pingpongshow/MDX-1/docs/img/Main PCB.png

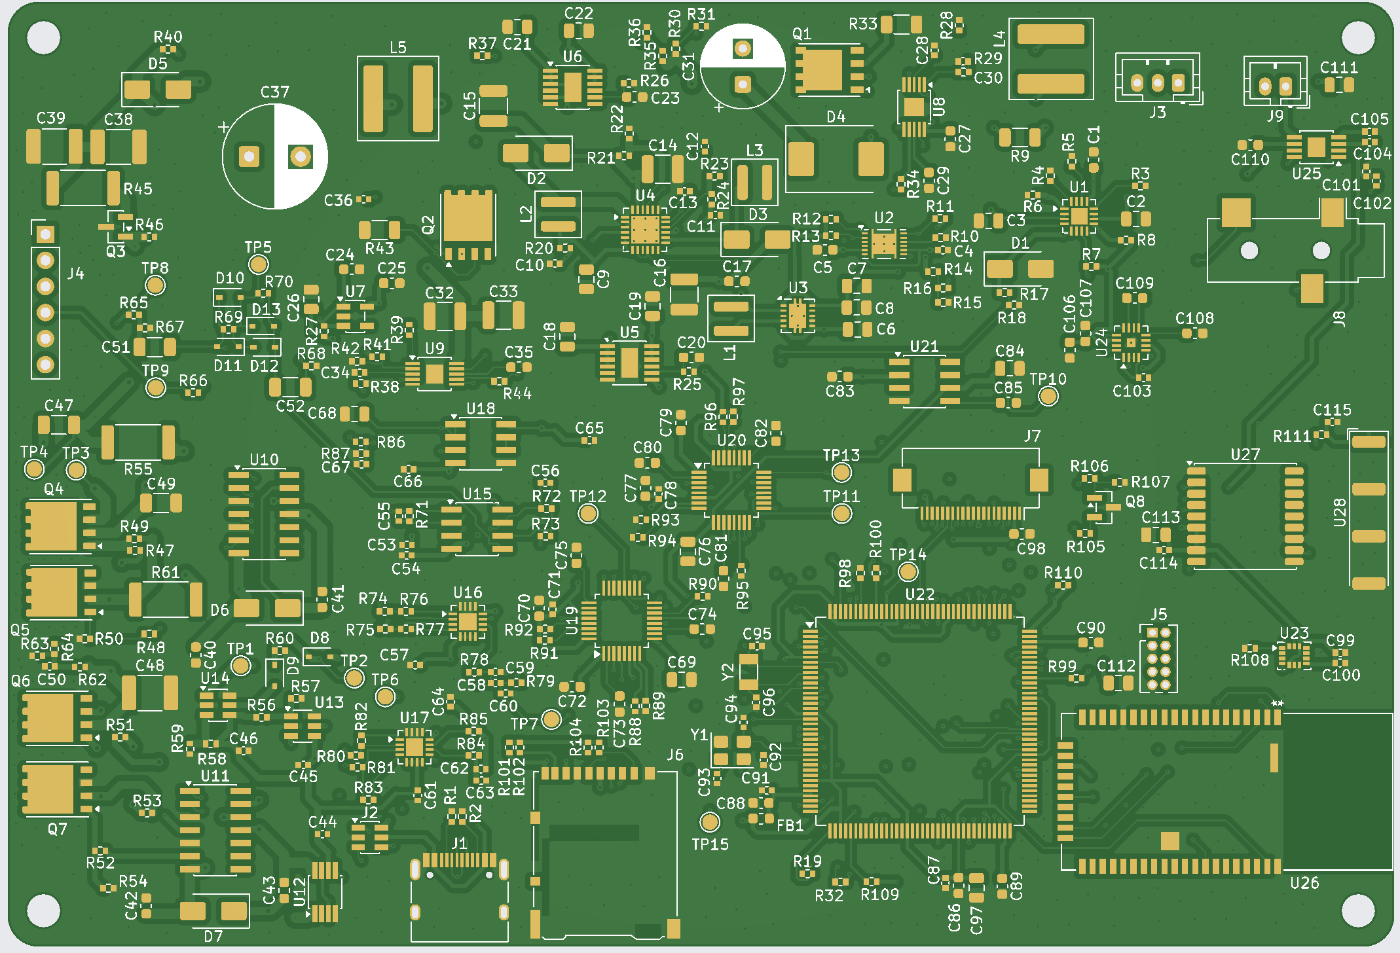
docs/img/Main PCB.png
