pingpongshow/MDX-1/hardware/mdx1/images/mdx1_main_B_Cu.png

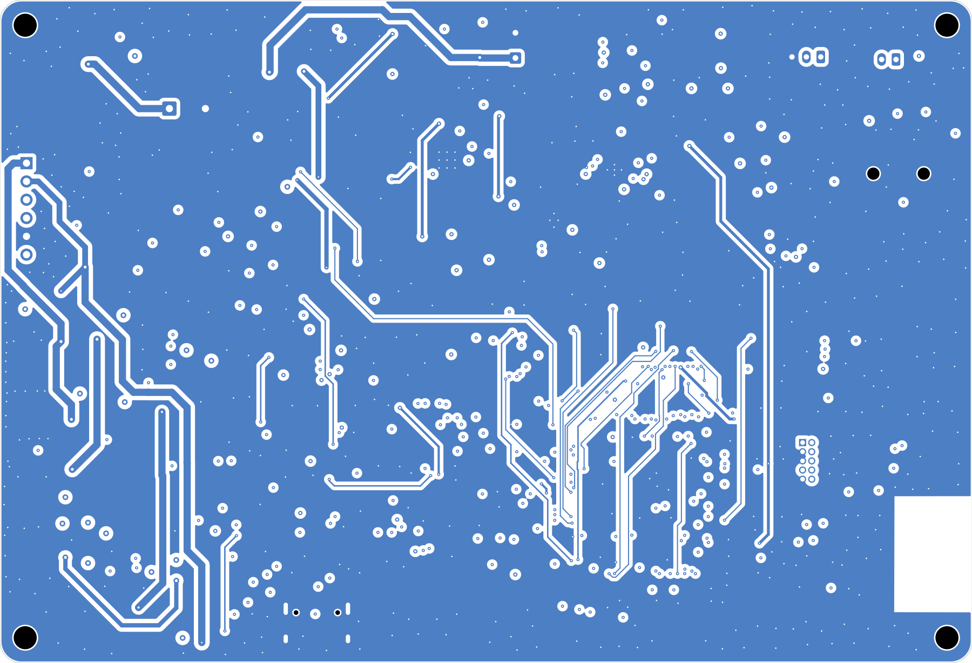
hardware/mdx1/images/mdx1_main_B_Cu.png
