pingpongshow/MDX-1/hardware/mdx1/images/mdx1_main_In2_Cu.png

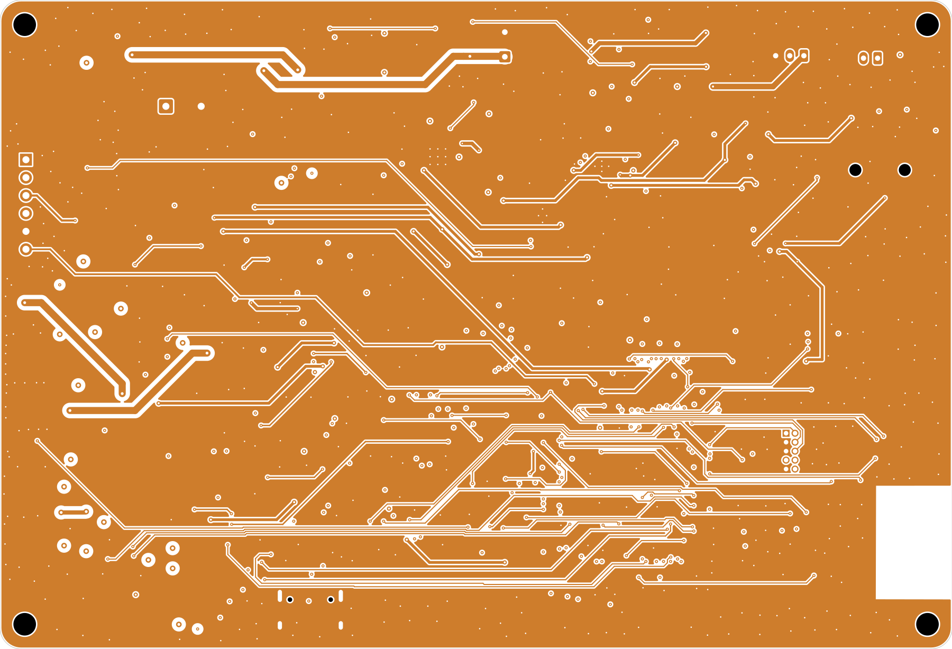
hardware/mdx1/images/mdx1_main_In2_Cu.png
