pingpongshow/MDX-1/hardware/mdx1/images/mdx1_ui_3d_top.png

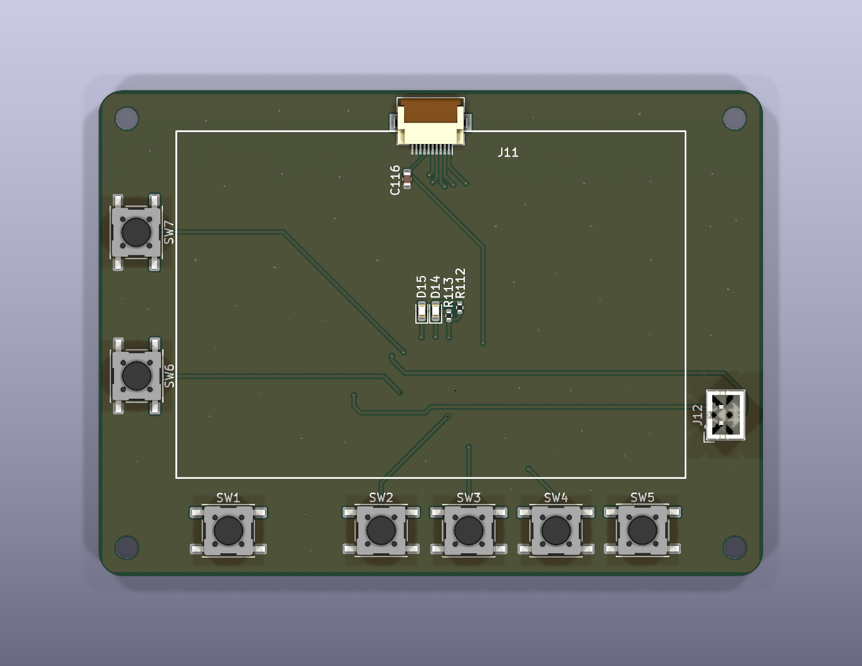
hardware/mdx1/images/mdx1_ui_3d_top.png
