pingpongshow/MDX-1/hardware/mdx1/images/mdx1_ui_B_Cu.png

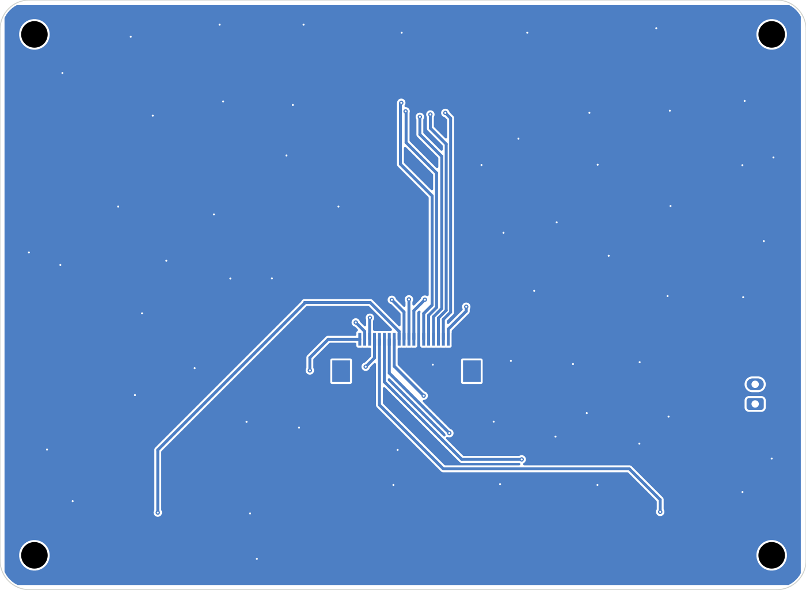
hardware/mdx1/images/mdx1_ui_B_Cu.png
