pingpongshow/MDX-1/hardware/mdx1/fab/BOM/MDX-1_interconnect_BOM.csv

Item | Qty | Description | Mates with | Manufacturer | MPN | Notes
FFC jumper 20-way | 1 | 20 circuits, 0.5 mm pitch, 0.30 mm thick, OPPOSITE-SIDE contacts (Type D), length to suit the enclosure | J7 on the main board to J10 on the UI board | Molex | 15020-02xx (Premo-Flex Type D; e.g. 0150200208 = 51 mm) | Type D is required: FH12 is a bottom-contact ZIF, J7 sits on the main board's TOP layer and J10 on the UI board's BOTTOM layer, so the two ends face opposite ways. Choose the length suffix from the Molex table once the board spacing is fixed. A Type A (same-side) cable only works if the cable is folded 180 degrees in the gap.
JST PH housing 2-pin | 2 | PH series crimp housing, 2 way, 2.0 mm pitch | J9 speaker on the main board; J12 front-light on the UI board | JST | PHR-2 | One per connector
JST PH housing 3-pin | 1 | PH series crimp housing, 3 way, 2.0 mm pitch | J3 battery on the main board | JST | PHR-3
JST PH crimp contact | 8 | SPH-002T-P0.5S crimp terminal, 22-28 AWG | loose contacts for PHR-2 and PHR-3 above | JST | SPH-002T-P0.5S | 2 + 2 + 3 contacts plus one spare; needs the JST WC-240 crimp tool or equivalent
Coil cable connector housing | 1 | 6-way crimp housing, 2.54 mm pitch (mates the J4 pin header) | J4 on the main board | Molex | 22-01-3067 | J4 is a 1x06 2.54 mm vertical pin header (Wurth 61300611121). Mate is a KK-254 6-circuit housing (Molex 22-01-3067) with 08-50-0114 crimp terminals, or any 2.54 mm 6-pos socket. Pin 6 (COIL_ID) may be left unwired for coils with no ID chip.
Coil cable crimp contact | 7 | KK-254 crimp terminal, 22-30 AWG | loose contacts for the coil housing above | Molex | 08-50-0114 | 6 contacts plus one spare
LCD flex | 0 | No separate part: the Sharp LS027B7DH01 has an integrated 10-way FPC tail that inserts directly into J11 | J11 on the UI board | Sharp | LS027B7DH01 | Panel is ordered as the display assembly
SWD programming cable | 1 | 2x5 1.27 mm ribbon, keyed | J5 on the main board |  |  | Standard Cortex-M 10-pin debug cable supplied with most SWD probes
