pingpongshow/MDX-1/hardware/mdx1/fab/Case/MDX-1_main_outline.dxf

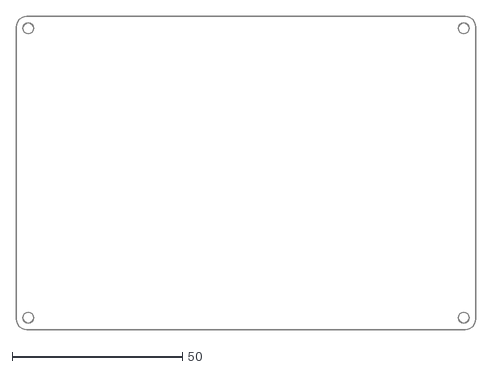
[picture p14: CAD file, 2026-09-09]
hardware/mdx1/fab/Case/MDX-1_main_outline.dxf
135.0 x 92.0
