pingpongshow/MDX-1/hardware/mdx1/fab/Case/LS027B7DH01_LCD_outline.dxf

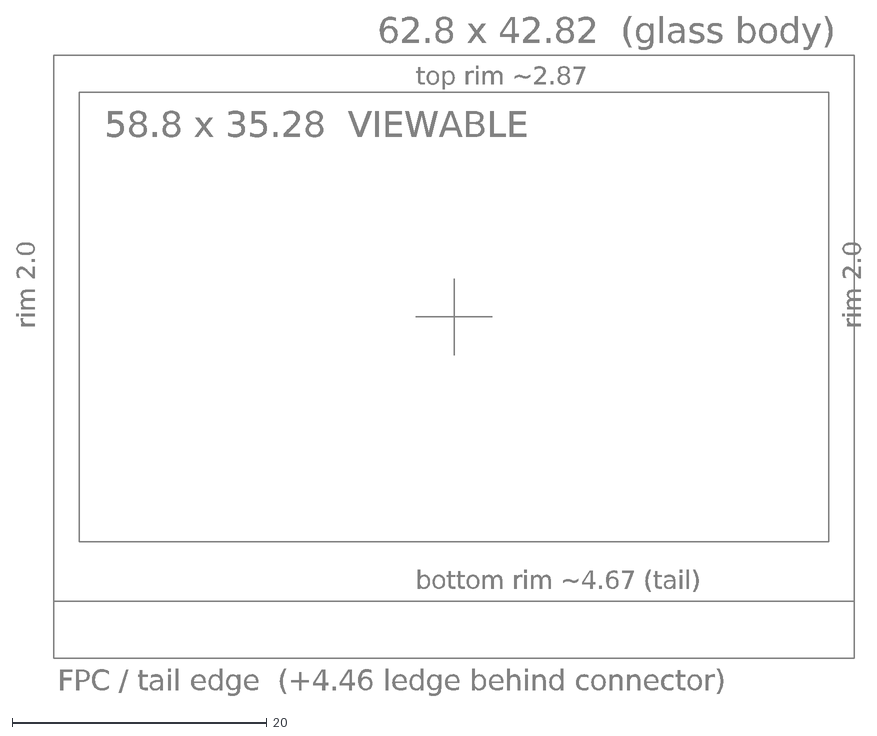
[picture p15: CAD file, 2026-09-09]
hardware/mdx1/fab/Case/LS027B7DH01_LCD_outline.dxf
62.8 x 42.82 (glass body)
58.8 x 35.28 VIEWABLE
FPC / tail edge (+4.46 ledge behind connector)
rim 2.0
top rim ~2.87
bottom rim ~4.67 (tail)
