pingpongshow/MDX-1/hardware/mdx1/fab/Case/MDX-1_ui_layout.dxf

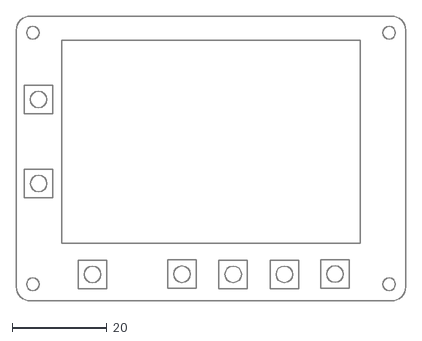
[picture p16: CAD file, 2026-09-09]
hardware/mdx1/fab/Case/MDX-1_ui_layout.dxf
82.0 x 60.0
