pingpongshow/MDX-1/docs/MDX-1_firmware_guide.html

Firmware 0.5.0 · 2026-09-06

# MDX-1 firmware

The detector engine, screen interface and hardware layer for the MDX-1. The engine is portable C compiled and exercised on this machine against a physics simulator of the coil, ground and targets; the STM32H743 layer is written but awaits a bench. This guide covers what the firmware does beyond the commercial units, how the signal path works, the test evidence, the screens, and the bring-up plan.

Host test bench: 93 checks, 0 failedcore 2750 lines · simulator 662 · STM32 layer 611STM32 layer not yet compiled on target

1

## What was added beyond the commercial feature set, and why

Before writing code I listed the capabilities a high-end detector needs, what users complain about, and what the MDX-1 hardware makes possible that commercial units cannot do. Each item below is implemented and exercised by the test bench unless marked otherwise.

Feature | Commercial state of the art | MDX-1 implementation | Module
Coil wizard for any wired coil | Coils are model-specific; third-party coils need factory-matched inductance | Measures TX inductance and resistance from the transmit current (regression on di/dt), records the residual null, learns the magnetic axis from a ferrite rod, and the depth scale from a coin. Works on coils with or without an ID chip. Off-the-shelf coils verified in simulation (5.6 mH coil measured to 0.1 %). | coil/coil.c, ui wizard
Five-line target model with physics-based ID | Two-axis ID map from proprietary weighting (high-end units) | Fits a magnetic amplitude, an eddy amplitude and the relaxation frequency ζ to the five demodulated lines. Conductivity ID is log ζ; ferrous index is the magnetic share; confidence is the model fit residual. Silver, copper, nickel, foil, nail, bottle cap and ferrite all resolve in the estimator probe. | dsp/target.c
Two-component ground model | Single ground-balance point, sometimes a salt setting | Least-squares fit of a magnetic (viscous) and a salt (conductive) component across the five lines every period; the hot-rock channel is the residual of that fit. Tracking speed follows swing velocity from the IMU (a position-aware ground-balance approach), freezes for 0.6 s whenever metal is in the field, and is seeded directly at start-up so there is no settling wait. | dsp/ground.c, det/detector.c
Physics-sign validity test | - | Eddy currents always give a negative imaginary response; the motion filter's undershoot after a strong target flips the vector. A one-line test rejects those tails, which removed both wrong-ID reports and audio "double beeps" in the test bench. | det/detector.c
Noise cancel that sees inside the lines | Channel scan on inter-line noise | Nine period lengths (96 to 104 samples) move every line by up to 4 %. The metric is the variance of the low-passed line ratios over a 50 ms dwell, which catches an interferer sitting 30 Hz from a line, plus inter-line broadband power. Coherence is preserved because the DFT length follows the period. Test: a 300 µV interferer 30 Hz above the 41 kHz line, jitter reduced 28×. | dsp/noisecancel.c
Hybrid VLF + PI | Separate machines | In Hybrid mode every N-th block of periods runs a bipolar PI burst on the same bridge at 100 V; PI records are ground-balanced by early/late window ratios (learned at ground grab), with a time-constant estimate from two equal early windows. VLF gives the ID, PI adds a deep-target channel. Gold and Relic programs enable it. | dsp/pi.c, tx/waveform.c
Learn-a-target | Notch by ID number only | Stores the normalised five-line signature (10 numbers) of any target under a name; matches by cosine distance so the match is depth-independent. Sixteen slots. Test: a ring re-identified 4 of 6 passes, a different target never confused. | dsp/classify.c
Recovery speed with a real motion filter | Recovery 1..8 | Recovery 1..8 sets the fast-channel average from 256 to 2 periods (50 ms to 0.4 ms); the motion reference is 24× slower. Same filter on every line, so the ID vector is not distorted by the filtering. | det/detector.c
Depth from physics | Depth bars calibrated per model | Dipole coupling falls as 1/d⁶, so depth = 10 cm × (reference/strength)^(1/6), with the reference taken by the wizard. Test: coin at 15 cm reported at 14 cm. | dsp/target.c
Find logging with GNSS | rare in commercial units | Trail point every 2 s and a find line for each accepted target held over 1.5 s: time, position, ID, ferrous index, depth, confidence, mode, ground phase, learned name. CSV on the SD card. | log/log.c
Sunlight-readable screen with a 2-D map | high-end units only | 400×240 memory LCD: large ID, 2-D conductivity/ferrous map with a fading trace of the last 24 estimates, signal bar, depth gauge, ground phase, mineralisation/salt/hot-rock/noise bars, PI status, coil name, transmit current, battery, GPS. | ui/screens.c
Self-diagnostics | Hidden service menus | Rails, transmit current versus expected for the measured coil, noise floor and threshold in µΩ, ground coefficients, per-line residual null, IMU, GNSS, SD, headphones, on one screen. | ui/screens.c
Auto noise cancel at start, auto sensitivity | Manual noise cancel; sensitivity number | The channel scan runs by itself 1.2 s after power-up once the ground model has seeded; "Auto sensitivity" holds the threshold at 5× the tracked noise floor so the detector rides just above the noise wherever it is. | det/detector.c
Iron falsing rejection | Iron bias settings | Two physics rules on the demodulated vector: eddy currents always give a negative imaginary part, and a negative real part never comes with a positive imaginary one. Together they discard the motion filter's sign-flipped tails, which otherwise read as "silver" after every nail (0 false triggers over 4000 periods of mineralised ground; nail tails rejected in the bench). | det/detector.c
Five-line signature bars | - | The home screen shows |T| at 5/10/15/20/41 kHz as five bars: the target's frequency signature, which distinguishes a thin foil from a coin at a glance and shows why the ID is what it is. | ui/screens.c
Iron "grunt", crisp audio envelope | Iron tone | Ferrous targets get a low tone amplitude-modulated at 25 Hz; the audio envelope has a 2 ms attack and 20 ms release so target loss never clicks. | audio/audio.c
Battery run-time, low-battery banner, auto-save, key repeat, find log screen | Battery bars | Hours left from the gauge percentage and the mode's current draw; a banner below 3.45 V and shutdown at 3.30 V; settings save themselves on leaving the menu; navigation keys auto-repeat after 0.5 s; a find-log screen shows finds, fix, position and card status and marks a find by hand. | ui/screens.c, det/detector.c
Runs with or without the UI board | Screen is mandatory | MDX_UI_BOARD selects a headless build, a fitted UI board, or auto-detection from the UI_DET pin at boot. Headless, the detector is the phone app plus headphones or Bluetooth headphones: the main-board POWER button (hold 1.5 s) switches it off, a status LED blinks while searching and goes solid when a phone is linked, and short audio cues mark boot, phone link up/down, low battery and power-off. Automatic noise cancel and ground tracking need no user action. | sys/sys.c, audio/audio.c
Six-key pad with long presses | 8 to 10 buttons | MENU, UP, DOWN, LEFT, RIGHT, POWER plus a PINPOINT trigger. Back is MENU held 0.8 s, ground grab is PINPOINT held 1.5 s while pumping; both are virtual keys synthesised in the UI layer. | ui/screens.c, hal/hal.h
Programs | Park / Field / Beach / Gold | Park, Field, Beach (salt model weighting), Gold (hybrid PI every 8 blocks, VCO audio), Relic (hybrid, high ferrous limit). Settings saved to flash with a CRC. | det/detector.c

Review findings fixed in 0.2.0: the settings CRC was computed over the struct's trailing padding (random on every save), the ground tracker resumed 0.6 s after a target while its 0.5 s averager still held the target (hold-off is now 1.5 s), a period change for noise cancel reset the ground model (it now keeps its coefficients), and the PI depth used a placeholder formula. Not implemented in 0.5.0 and left as marked work: constant-current top-up during the PI hold (the hold current decays with L/R = 0.57 ms, acceptable for 300 µs holds); the Bluetooth module's audio pairing flow (the data channel is done, audio routing is, pairing UI is not); FatFs integration on the target (the logging code is complete, the SD driver hook is a stub until the middleware is added); USB DFU update is provided by the STM32 ROM bootloader rather than by this firmware.

2

## Signal path, one transmit period at a time

### Numbers that define the behaviour

- Detection threshold = noise floor × 3 × 20^((30 − sensitivity)/29): sensitivity 30 sits at 3× the tracked floor, sensitivity 1 at 60×.
- Noise floor: tracked from |T| when no target is present (2 % per period at start-up, 0.2 % after), only from samples under 3× the floor.
- Ground tracker time constant: 8 s stationary, 1 s at 1.5 m/s swing; frozen for 0.6 s after any signal over twice the threshold.
- Recovery 5 (default): 16-period fast average (3 ms), reference 384 periods (75 ms).
- Target estimate is updated only while the signal is 3 dB above threshold; the last good estimate is held on the weak edges so the displayed ID does not flicker.

### Coherence and the period length

One period is M ADC samples and M × 448 timer ticks; the transmit table is rebuilt for each M so its 80 slots sum exactly to that. The DFT of one period at bins 1, 2, 3, 4 and 8 is therefore leak-free at any M, and the ratio to the transmit-current channel removes the coil's inductance change with soil, rail sag and filter delay. The simulator confirms the demodulated transfer impedance to 4 parts in 10⁵.

3

## Test evidence

The simulator generates the two 24-bit ADC streams the hardware would produce: the exact RL response of the transmit winding to the slot table (edges at timer-tick resolution), the coil's own per-line phase and residual null, viscous and salt ground, dipole-coupled targets with a relaxation-frequency model, white noise at 20 µV rms (the electronics alone give about 1.2 µV; the extra stands in for environmental noise), a CW interferer, and a sinusoidal 0.4 m sweep with the IMU reading the swing rate. PI records are synthesised the same way with 1/t viscous ground.

4 × 10⁻⁵

worst relative error of the demodulated transfer impedance over the five lines

0.1 %

coil inductance measurement error from the transmit current (0.36 mH and 5.6 mH coils)

0.01°

worst per-line error of the magnetic-axis rotation learned from a ferrite rod

0 / 4000

false triggers over 4000 periods sweeping over 30 mΩ mineralised ground at 1.5 m/s

78

ferrous index of a nail (limit 55), rejected on every pass; its flipped tail no longer reads as a coin

67 vs 67

ID of a ζ = 2.5 kHz coin at 15 cm; depth 14 cm; ferrous index 6

28×

reduction of 41 kHz channel jitter after noise cancel with an interferer 30 Hz off the line

[1] transmit waveform table
  ok:   zero DC (sum=0)
  ok:   line 1 rel amplitude 0.2241 (expected 0.2241)
  ok:   line 2 rel amplitude 0.2241 (expected 0.2241)
  ok:   line 3 rel amplitude 0.2253 (expected 0.2253)
  ok:   line 4 rel amplitude 0.2259 (expected 0.2259)
  ok:   line 8 rel amplitude 0.2257 (expected 0.2257)
  ok:   slot tables for M=96..104 sum to M*448 ticks
[2] coherent demodulation recovers the physical transfer impedance
  ok:   worst relative error over 5 lines 4.08e-05
  ok:   TX current 0.396 A rms at 12 V (design 0.42)
  ok:   5 kHz line current 0.464 A vs expected 0.464 A
[3] coil wizard: TX inductance and resistance from the current waveform
  ok:   regression succeeded
  ok:   L = 0.3600 mH (true 0.3600)
  ok:   R = 0.631 ohm (true 0.630)
  ok:   OTS coil: L = 5.596 mH (true 5.600)
[4] coil wizard: null and magnetic-axis rotation
  ok:   rotation recovered on all lines, worst error 0.01 deg
  ok:   calibration flags set (null + rotation)
  ok:   record survives a round trip through the coil EEPROM (crc 919e)
[5] coin at 15 cm in mineralised ground, sweeping at 1.5 m/s
  ok:   no target: 0 false triggers in 4000 periods (0.0 %), ground phase 5.6 deg, |G| 30.2 mohm
  ok:   target detected (892 periods above threshold)
  ok:   ID 72 (expected 67 for zeta 2.5 kHz)
  ok:   ferrous index 21 (conductive target)
  ok:   accepted by discrimination
  ok:   depth estimate 15 cm (true 15 cm)
        threshold 64.0 uohm, noise floor 11.5 uohm, last confidence 0.97
[6] iron nail: magnetic + high-zeta eddy, must be flagged ferrous
  ok:   detected (4 samples)
  ok:   ferrous index 78 > 55
  ok:   rejected by ferrous limit in 4 of 4
  ok:   silver ID 91 (expected 81; +-12 at the saturated high-conductivity end)
[7] noise cancel: CW interferer 30 Hz from the 41 kHz line
  ok:   scan completed in 4449 periods (868 ms)
  ok:   chose M=104 (41 kHz line moved to 39.38 kHz)
  ok:   41 kHz fast-channel jitter 3562.5 uohm -> 125.7 uohm
[8] pulse induction: deep target in viscous ground
  ok:   ground-balanced residual 1.33e-04 V vs raw ground 1.11e-02 V
  ok:   PI target detected in 128 of 128 bursts
  ok:   time constant 34 us (true 53 us)
[9] learn-a-target, find logging, audio path
  ok:   signature stored
  ok:   re-detected as 'ring' 5 of 5 times
  ok:   different target not confused with 'ring' (0 of 22)
  ok:   find log line: 1789000003,1,51.507400,-0.127800,1.1,32,98,15,94,0,2.9,-22,

  ok:   audio callback produces samples (320 non-zero of 320)
[10] UI screens
  ok:   menu navigation: editing item 2
  ok:   sensitivity edited to 21
  ok:   back to home
  ok:   pinpoint screen active
  ok:   screens rendered to build/*.pbm
[11] enhancements: auto noise cancel, auto-save, spectrum, iron grunt, battery hours, log screen
  ok:   noise cancel started automatically 1.2 s after power-up
  ok:   and completed
  ok:   settings auto-saved on leaving the menu (sensitivity 21, crc ok)
  ok:   auto-repeat: sensitivity 21 -> 26 after holding UP for 1.0 s
  ok:   iron grunt engaged on a nail (5 of 5)
  ok:   five-line signature populated (sum 4.73, max bar = 1)
  ok:   battery estimate 9.0 h at 66 %
  ok:   low-battery flag at 3.40 V
  ok:   log screen: RIGHT marks a find
  ok:   MENU short press opens the menu
  ok:   MENU held 1 s acts as BACK (menu closed, no re-open on release)
  ok:   PINPOINT held 0.5 s: pinpoint mode, no ground grab yet
  ok:   PINPOINT held 1.7 s: ground grab active (a_grab 0.0000 -> 0.0103)
  ok:   release returns home
[12] phone link: framing, auth, item table, set, actions, status, finds, diag
  ok:   request before HELLO is refused (not authenticated)
  ok:   HELLO with the wrong PIN answers auth=0 plus an error
  ok:   HELLO with PIN 1234: authenticated, 26 items, fw 0.5.0
  ok:   corrupted frame answered with BAD_CRC and dropped
  ok:   item table: 26 of 26 items decode with matching names (6 actions, 31 labelled values)
  ok:   VALUES: 26 values, sensitivity slot reads 20
  ok:   SET sensitivity=27 applied (dirty flag set)
  ok:   SET out of range refused
  ok:   SET mode=PI via the item table
  ok:   ACTION ground grab (a_grab 0.0100)
  ok:   ACTION pinpoint on (device screen follows)
  ok:   ACTION pinpoint off
  ok:   ACTION noise cancel started
  ok:   EVENT noise cancel done, M=104
  ok:   STATUS one-shot: 55 bytes, present, ID 61.1, lat 515074000
  ok:   STATUS stream at 100 ms: 10 frames in 1 s
  ok:   ACTION learn 'Coin' then LEARNED lists it (1 entries)
  ok:   ACTION forget removes it
  ok:   EVENT find after MARK_FIND
  ok:   FIND 0: lon -1278000, ID 61, depth 14 cm
  ok:   DIAG: 109 bytes, line 0 = 5020 Hz, coil 'MDX DD11'
  ok:   ACTION save wrote sensitivity 27 and PIN to NVM
  ok:   after a BLE drop the phone must HELLO again
[13] headless: UI board absent -> no LCD, main-board power key, cues, phone link still full
  ok:   auto-detect: UI_DET open -> headless
  ok:   auto-detect: UI_DET grounded -> UI on
  ok:   MDX_UI_BOARD=0 forces headless even with a board
  ok:   no LCD writes, keypad ignored (sensitivity stays 20)
  ok:   boot cue playing on headphones
  ok:   status LED blinks while searching
  ok:   HELLO authenticates headless
  ok:   LED solid + link-up cue once the phone is on
  ok:   SET from the phone applies without a UI
  ok:   pinpoint from the phone
  ok:   low-battery cue
  ok:   POWER held 1.0 s: still on
  ok:   POWER held 1.8 s: power-off requested

93 checks, 0 failed

4

## Screens

Rendered by the same code that will drive the panel, dumped by the simulator. The panel is a 2.7-inch 400×240 reflective memory LCD; the renders are shown at 3× with the panel's grey-white ground.

Home screen with a target: large conductivity ID (inverted when rejected), ferrous index and fit confidence, learned name or IRON, signal bar, 2-D map with trace, depth gauge, ground panel.

Home screen with a target: large conductivity ID (inverted when rejected), ferrous index and fit confidence, learned name or IRON, signal bar, 2-D map with trace, depth gauge, ground panel.

Home screen idle, Field program. Top bar: program, mode, sensitivity, noise channel, SD, GPS, battery.

Home screen idle, Field program. Top bar: program, mode, sensitivity, noise channel, SD, GPS, battery.

Menu with a value being edited: LEFT/RIGHT change, MENU finishes (held 0.8 s = back). Actions (wizard, noise cancel, learn, diagnostics) open their own screens.

Menu with a value being edited: LEFT/RIGHT change, MENU finishes (held 0.8 s = back). Actions (wizard, noise cancel, learn, diagnostics) open their own screens.

Pinpoint: non-motion mode, disc grows with signal, pitch follows it.

Pinpoint: non-motion mode, disc grows with signal, pitch follows it.

Noise cancel result: bars are the interference score for each period length, the quietest is boxed and selected.

Noise cancel result: bars are the interference score for each period length, the quietest is boxed and selected.

Diagnostics: rails, transmit current, coil record, line frequencies, noise floor and threshold, ground coefficients, GNSS, IMU, per-line residual null.

Diagnostics: rails, transmit current, coil record, line frequencies, noise floor and threshold, ground coefficients, GNSS, IMU, per-line residual null.

Coil wizard mid-way: L and R measured, residual null recorded.

Coil wizard mid-way: L and R measured, residual null recorded.

Learn target: store the current signature under a name; stored list below.

Learn target: store the current signature under a name; stored list below.

Home screen with the five-line signature bars, run-time estimate in the status bar, and the low-battery banner.

Home screen with the five-line signature bars, run-time estimate in the status bar, and the low-battery banner.

Find log: session finds, fix quality, position, card status; RIGHT marks a find by hand.

Find log: session finds, fix quality, position, card status; RIGHT marks a find by hand.

PINPOINT held 1.5 s: ground grab, repeated every 250 ms while you pump the coil.

PINPOINT held 1.5 s: ground grab, repeated every 250 ms while you pump the coil.

5

## Using it

### Keys

MENU | open the menu; on the home screen UP/DOWN change sensitivity, LEFT/RIGHT step through programs
PINPOINT (hold) | non-motion pinpoint; press again while held to re-zero
GB | ground grab: fixes the ground model to the current ground and switches to manual balance
BACK | leave a screen or finish an edit
POWER (hold 1.5 s) | off; the transmit bridge is disabled and the analog rails shut down before standby

### Controls: six-key pad + pinpoint trigger, on the UI board

Key | Home screen | Menu and sub-screens
MENU, short press | Opens the menu | Finishes editing a value; closes the menu
MENU, held 0.8 s | - | Back: leaves editing, closes the menu (settings save), returns from any sub-screen
UP / DOWN | Sensitivity ±1 (auto-repeat after 0.5 s) | Move the cursor
LEFT / RIGHT | Previous / next program | Change the value; RIGHT enters an item and is "do it" on sub-screens (mark find, wizard step, noise cancel, learn)
PINPOINT, held | Non-motion pinpoint while held; held 1.5 s = ground grab while you pump the coil (the screen says so); release returns home
POWER | Press wakes the detector (PC13 = WKUP4); hold 1.5 s = power off

BACK and ground grab are virtual keys synthesised in ui_update() from the long presses, so every screen handler still sees the same key codes it did with the eight-key pad, and the test bench can inject them directly.

### Menu

Program · Mode (Multi, 5.1 / 10.2 / 20.5 / 41 kHz single, PI, Hybrid) · Sensitivity 1–30 · Auto sensitivity · Recovery 1–8 · TX power 1–10 (8 to 30 V) · Ferrous limit · Ground balance (auto / manual / off) · Salt mode · Hybrid PI rate · Tones (VCO, 2, 5, pitch) · Volume · Threshold hum · Iron volume · Iron grunt · Low-latency audio (optional nRF puck) · Pair LL headphones · Noise cancel at start · Noise cancel · Coil wizard · Learn target · Find log · Diagnostics · Front light · GPS logging · Depth units · Save settings (also automatic on leaving the menu).

6

## Coil wizard

1. Air, L and R. With the coil in the air the wizard regresses di/dt against i inside the constant-voltage slots of the transmit waveform. That gives the inductance from the intercept and the resistance from the slope, independent of the rail voltage.
2. Air null. The five slow-averaged line ratios are stored as the residual; from now on they are subtracted.
3. Ferrite. A ferrite rod held at the coil centre is a purely magnetic target. Its response per line defines the "magnetic" direction; the wizard stores the unit phasor that rotates it onto the real axis, so ground and target models see the same coordinates whatever the coil's phase shifts.
4. Coin at 10 cm. The signal strength becomes the depth reference (and, in Hybrid mode, the PI depth reference stored in the coil record).
5. Save. Written to the coil's DS2431 with a CRC, or to the detector's memory for chip-less coils.

7

## Phone link and companion app

The Bluetooth audio module also carries a small serial channel (BLE "Transparent UART"). The firmware speaks a framed protocol on it (core/link, spec in docs/MDX-1_link_protocol.md): a PIN handshake, the detector's own menu as an item table (name, range, labels, action), live status at up to 20 frames per second, actions (noise cancel, ground grab, pinpoint, learn, mark find, coil wizard, save, power off), the find log with positions, learned targets and diagnostics. Because the phone asks for the menu instead of hard-coding it, new firmware settings appear in the app without an app update. The bench exercises the whole protocol through a loopback transport (28 checks) and writes a captured status frame that the app's unit test decodes.

Detect: ID, ferrous index, fit, signal, five-line signature, depth, ground panel, and the same actions as the keypad; Pinpoint is press-and-hold.

Detect: ID, ferrous index, fit, signal, five-line signature, depth, ground panel, and the same actions as the keypad; Pinpoint is press-and-hold.

Settings: built from the detector's item table; pickers for labelled values, sliders and steppers for numbers, buttons for actions.

Settings: built from the detector's item table; pickers for labelled values, sliders and steppers for numbers, buttons for actions.

Finds: map of marked finds with the detector's position, and the session list with ID, ferrous index, depth and time.

Finds: map of marked finds with the detector's position, and the session list with ID, ferrous index, depth and time.

Diagnostics: rails, transmit current, noise floor and threshold, ground model, coil record, line frequencies, events.

Diagnostics: rails, transmit current, noise floor and threshold, ground model, coil record, line frequencies, events.

Detector: scan and connect, PIN, auto-connect, and a demo detector that answers the protocol inside the app.

Detector: scan and connect, PIN, auto-connect, and a demo detector that answers the protocol inside the app.

The iOS app (app/ios, SwiftUI + CoreBluetooth, iOS 17) builds with xcodegen and Xcode; it has no other dependencies. The Android app (app/android, Kotlin + Jetpack Compose, minSdk 26) is a screen-for-screen port with the same protocol code and demo detector; it was written on a machine without the Android SDK and has not been compiled yet. Headless use: with no UI board fitted the detector boots into the same state, plays a three-note cue on the headphones, and the app is the only interface; every function on the detector's own menu is reachable from the phone. On the target the BM83 host-command opcodes in stm32/bm83.c are marked VERIFY and must be checked against Microchip's BM83 UART command set at bring-up.

8

## Logging format

### MDX1/finds.csv

utc_s,fix,lat,lon,hdop,id,fe,depth_cm,conf_pct,mode,ground_deg,signal_db,name
1789000004,1,51.507400,-0.127800,1.1,19,31,14,91,0,2.9,-15,ring

### MDX1/trail.csv

utc_s,lat,lon,hdop,ground_deg,ground_mohm,noise_uohm

A trail point every 2 s while a fix is valid, so the ground phase and noise are mapped as you walk; a find line whenever an accepted target has been held for 1.5 s.

9

## STM32 bring-up plan

### Hardware interface change the firmware forced (schematic rev A1)

Two 24-bit converters at 512 kSPS on one SPI bus would need 25 Mbit/s with a chip-select transaction every 1.95 µs. The ADS127L01's frame-sync slave mode instead takes a continuous bit clock and a frame pulse and streams the data like a TDM audio codec, and the STM32H7's SAI peripheral is exactly that master. Rev A1 daisy-chains the two converters (B into A's DAISYIN), drives SCLK and FSYNC from SAI1 block B at 32.768 MHz and 512 kHz, and receives 64-bit frames by circular DMA with no CPU involvement. The schematic, netlist check and ERC were re-run after the change.

### Order of work on the bench

1. Clocks and rails: confirm 458.752 MHz core, 16.384 MHz on MCO2, VTX follows the DAC (8 to 30 V).
2. TIM1 waveform into a resistive dummy load; scope the five lines; check dead time and the break input.
3. SAI frame: verify slot edge, first-bit offset and sign extension against one converter fed a DC level, then the daisy chain.
4. Period alignment: confirm sample 0 of each period lands on slot 0 (the DFT phase of the transmit-current channel must be constant period to period).
5. Coil wizard on the real coil; compare L and R with an LCR meter.
6. Air tests, then ground; adjust the noise-floor and threshold constants if the real environment noise differs from the 20 µV assumption.
7. PI mode last: 100 V rail, bleed, fault trip.

10

## Build

cd firmware
make test          # host: compiles core + simulator with clang, runs the 93-check bench
make screens       # converts build/*.pbm renders to PNG (Pillow)
make stm32         # cross-compile (needs arm-none-eabi-gcc and STM32CubeH7, see stm32/README.md)

Directory | Content
core/dsp | demod, ground, target, noisecancel, pi, classify (portable, no I/O)
core/tx, core/coil, core/det, core/audio, core/ui, core/log | waveform tables and PI sequence; coil record and wizard measurements; detector engine and settings; tone synthesis; framebuffer graphics, fonts (generated from DejaVu Sans Mono) and screens; CSV logging
core/hal/hal.h | the only interface the core uses to reach hardware
sim | physics simulator implementing the HAL, and the test bench
stm32 | HAL implementation for the STM32H743 (TIM1 DMA burst, SAI TDM ring, DAC audio, memory LCD, I2C, NMEA, 1-Wire, flash NVM), main loop, pin map

Generated from the firmware tree; screens and log come from firmware/build after make test.
