pingpongshow/MDX-1/docs/MDX-1_coil_manual.html

Build manual · coil rev A · 2026-09-05

# MDX-1 search coil

How to build the 11-inch double-D coil the MDX-1 was designed around, with every dimension and winding count computed from the electromagnetic model, and how to use an off-the-shelf wired coil instead. The detector's coil wizard measures whatever coil is connected, so neither path needs an LCR meter for the electrical part.

1

## Electrical specification

Winding | Turns | Wire | Inductance | Resistance | Wire length
TX (transmit D) | 23 | Litz 60 × 0.10 mm (0.80 mm Cu equivalent), or 0.80 mm solid enamelled | 0.36 mH | 0.63 Ω | 18.3 m
RX (receive D) | 63 | 0.25 mm solid enamelled | 3.05 mH | 17.6 Ω | 50.2 m

### Derived figures

- RX self-resonance with 190 pF total (winding 30, shield 60, 1 m cable 100): 209 kHz. Keep above 150 kHz: no more than 1.2 m of cable, and no foil shield directly on the RX bundle.
- Null overlap (RX D edge past TX D edge, both symmetric about the centre): 20.8 mm. Sensitivity of the null: 5.8 µH per mm, which is 1.50 Ω of transfer impedance per mm at 41 kHz. That is why nulling is a two-stage job (section 5).
- TX field on axis at 5 kHz with the 12 V rail (0.49 A peak): 48 µT at 5 cm, 26 µT at 10 cm, 7.5 µT at 20 cm, 2.8 µT at 30 cm.
- Coil tolerance the firmware accepts without recalibration: inductance ±10 %, resistance ±30 %. The wizard measures and stores the real values.

2

## Geometry

### How the numbers were obtained

The centre-line of each D is a 280 mm circle cut by a vertical chord. Inductance uses the Neumann formula on that path with the bundle's geometric mean distance as the self term; mutual inductance between the two D's is the same integral with the windings stacked 4 mm apart. The overlap was swept until the mutual inductance crossed zero. The script is tools/coil_calc.py; change the diameter or wire and it recomputes turns and null.

### Layout rules

- TX D on the left, RX D on the right when the cable exits at 12 o'clock. Either way round works; the wizard defines the axes.
- Both D edges parallel, overlap centred on the coil centre.
- TX bundle sits on the base of the shell, RX bundle above it in the overlap region, separated by 4 mm of foam. This spacing is part of the calculation; changing it moves the null by roughly 1 mm per 2 mm of spacing.
- Keep both bundles at least 8 mm from the shell wall so the shield and potting do not compress them.

3

## Materials

Item | Quantity | Notes
Litz wire 60 × 0.10 mm (or 0.80 mm enamelled copper) | 20 m | Litz halves the AC resistance at 41 kHz (skin depth 0.33 mm). Solid wire is acceptable: +0.2 Ω at 41 kHz.
Enamelled copper 0.25 mm | 55 m | Class 155 polyurethane enamel, solderable.
Coil shell, open 11 in DD housing | 1 | Aftermarket blank DD shells (ABS, 290 mm) fit; or 3D-print in ASA with a 2 mm base and a separate cover.
Closed-cell PE foam sheet, 4 mm | A4 sheet | Spacer between TX and RX at the overlap, and bundle support.
Graphite shielding tape or graphite paint (200 – 2000 Ω/sq) | 3 m / 100 ml | Electrostatic shield. Never use foil or copper tape: a closed conductive loop kills the 41 kHz line.
Tinned drain wire 0.3 mm | 2 m | Spiralled along each shield, joined to the cable shield only at the cable end.
6-core screened cable, 24 AWG, PUR jacket, 6 mm OD | 1.0 m | Two twisted pairs for TX and RX, one pair for ID/GND, overall braid.
M12 A-coded 8-pin male cable connector, IP68 | 1 | Mates with the panel socket on the control box.
DS2431 1-Wire EEPROM (SOT-23) on a carrier | 1 | Coil identity and calibration; solder to a 10 × 8 mm scrap PCB.
Two-part epoxy potting resin + glass microballoons | 500 g | Low-exotherm, slow cure; microballoons reduce weight and shrinkage.
Kapton tape, hot-melt glue, cable gland M12 | - | Tacking, strain relief.

4

## Build steps

Print the winding templates. Two D shapes at 1:1 with the centre-line dimensions from section 2 (chord at ±10.4 mm from the centre). Pin nails every 25 mm just outside the line to form the winding jig on a board.

Wind the TX D. 23 turns of Litz, keeping the bundle round and tight. Leave 300 mm tails. Bind every 40 mm with thread. Lift off the jig and tape the bundle with Kapton.

Wind the RX D. 63 turns of 0.25 mm wire on the second template. Count carefully; every turn is 1.6 % of the inductance. Bind and tape as before.

Shield each bundle. Wrap graphite tape (or brush two coats of graphite paint over a Kapton wrap) with the drain wire spiralled underneath. Stop 10 mm short of closing the loop, on the side facing the cable exit, so the shield is a C, not an O. Bring each drain wire out with the winding tails.

Dry-fit in the shell. TX D on the base, RX D on 4 mm foam over the TX in the overlap region. The RX D must be free to slide ±5 mm across the overlap. Route all tails to the cable exit; keep TX tails twisted together and RX tails twisted together.

Terminate the cable. Pinout in section 6. Solder the DS2431 carrier to the ID and GND cores. Fit the cable gland. Do not connect the drain wires to the shell.

Coarse null. Connect to the MDX-1, open Menu → Coil wizard, run step 1 (L and R are measured from the transmit current, expect 0.36 mH / 0.63 Ω ±10 %). Step 2 shows the residual per line live. Slide the RX D until the 41 kHz residual is smallest, then check the 5 kHz line; they null within 0.5 mm of each other. Tack with hot-melt at four points.

Fine null with a bucking loop. Section 5. Target: residual under 0.3 Ω at 41 kHz (20 mV at the preamp), under 0.1 Ω at 5 kHz.

Pot in two pours. First pour to just cover the TX bundle; cure fully; re-check the null (it will move a little as the resin shrinks); adjust the bucking loop; second pour to cover the RX. Cure 24 h. Fit the cover with a bead of resin.

Final calibration. Run the whole wizard: air null, ferrite rod (defines the magnetic axis per line), and a copper coin at 10 cm (depth reference). Save; the record is written to the DS2431 and the coil is now plug-and-play.

5

## Nulling

### Why two stages

The null moves by %.1f µH per millimetre of overlap. At 41 kHz with the 12 V rail (63 mA on that line) that is 94 mV of residual per millimetre at the coil, and the receive chain saturates at 125 mV. Mechanical positioning gets you to about 0.3 mm; the bucking loop covers the last few hundred microhenries without touching the D's.

The residual does not need to be zero. The firmware measures it in the air null step and subtracts it; what matters is that it is small enough to leave headroom (under 60 mV at every line) and stable with temperature, which is a potting question.

### Bucking loop procedure

1. Cut 600 mm of the 0.25 mm RX wire. Form a single loop of about 40 mm diameter and connect it in series with the RX winding (break the RX tail inside the shell).
2. Lay the loop flat in the overlap zone. Moving it toward the TX D increases negative coupling, toward the RX D positive; rotating it 180° flips the sign. Watch the 41 kHz residual on the wizard screen.
3. When the 41 kHz residual is minimal, check 5 kHz. If the two disagree by more than 0.1 Ω, the phase of the residual differs between lines: a small piece of ferrite (2 mm) or aluminium foil (5 × 5 mm) taped near the loop trims the reactive part. Aluminium adds a lossy (eddy) component, ferrite a magnetic one.
4. Tack, re-check, pot.

The wizard screen shows the residual in µΩ and in mV at the preamp. Numbers to expect after coarse positioning: 0.5 to 2 Ω (30 to 120 mV) at 41 kHz. After the loop: under 0.3 Ω. After potting: a shift of 0.05 to 0.2 Ω, which the air-null step absorbs.

6

## Cable and connector

M12 pin | Signal | Cable core | Notes
1 | TX+ | pair A, white | to bridge output A (COIL_TX+)
2 | TX− | pair A, brown | through the 20 mΩ shunt (COIL_TX−)
3 | RX+ | pair B, green | preamp input +
4 | RX− | pair B, yellow | preamp input −
5 | GND / shield | braid + pair C, grey | cable braid and both winding drains land here; the shell is not grounded
6 | COIL_ID | pair C, pink | 1-Wire data to the DS2431, 4.7 kΩ pull-up in the control box
7 | spare (+3V3 in a future revision) | - | reserved for active coils
8 | spare | - | reserved

### Cable practice

- TX pair carries up to 3 A peak in PI mode and 100 V edges: keep it twisted and away from the RX pair inside the shell; in the cable the pairs are separate.
- The RX pair adds capacitance in parallel with the RX winding (about 100 pF per metre). Do not extend the cable.
- Braid drained at the control-box end only. Inside the coil the drain wires join the braid at the gland.
- Strain relief: 40 mm of the cable is potted into the spine.

7

## Identity chip record (DS2431, 128 bytes)

Offset | Size | Field | Content
0 | 4 | magic | 0x4D445831 "MDX1"
4 | 1 | type | 1 DD, 2 mono, 3 concentric
5 | 1 | size | diameter in cm
6 | 1 | version | record format, 1
7 | 1 | flags | bit 0 null stored, bit 1 rotation stored, bit 2 depth reference stored
8 | 12 | name | ASCII, shown on the home screen
20 | 16 | L_tx, R_tx, L_rx, R_rx | float32, mH / Ω
36 | 40 | null[5] | complex float32 per line, residual transfer impedance in Ω
76 | 40 | rot[5] | complex unit phasor per line rotating measurements so that magnetic material reads +real
116 | 4 | depth_ref | |T| of the reference coin at 10 cm, Ω
120 | 2 | serial | coil serial
122 | 4 | reserved | -
126 | 2 | crc | CRC-16/CCITT-FALSE over bytes 0..125

Coils without a chip work too: the detector keeps one calibration record in its own memory for a "chip-less" coil and shows "no chip" on the diagnostics screen. The wizard must be re-run when such a coil is swapped.

8

## Acceptance tests

Test | Method | Pass
TX winding | Coil wizard step 1 (regression on the transmit current) | L within 10 % and R within 30 % of the table in section 1
RX self-resonance | LCR meter at the connector, or sweep: the diagnostics noise figure rises sharply near resonance | above 150 kHz
Residual null | Wizard step 2, coil in air 1 m from any metal | under 0.3 Ω at 41 kHz, under 0.1 Ω at 5 kHz, no OVERLOAD flag at TX power 10
Noise floor | Diagnostics screen, coil in air, sensitivity 20 | floor under 30 µΩ; the electronics alone contribute about 5 µΩ
Air test | Copper coin swept at 20 cm, 25 cm, 30 cm below the coil, 1 m/s | ID within ±3 of the 10 cm value at all three distances; audible at 30 cm at sensitivity 24
Ferrous | Nail at 10 cm | Ferrous index above 55, rejected in Field program
PI mode | Oscilloscope on RX+ / RX− at the preamp input, PI mode, no target | ringing settled to under 20 mV by 5 µs after each reversal (checks the shield gap and cable dressing)
Thermal | Freezer 30 min, then wizard step 2 | residual shift under 0.2 Ω

9

## Using an off-the-shelf coil

Any wired induction-balance coil with separate transmit and receive windings can be used: DD, concentric or mono-plus-receive. Coils that contain their own electronics (wireless designs) cannot. The MDX-1 does not require a particular inductance because the transmit rail is programmable and the receive chain has no tuned circuits; the coil wizard measures the coil and calibrates the null, the magnetic axis and the depth scale.

Coil | TX / RX inductance (mH) | 5 kHz line current at 12 V | Sensitivity vs MDX DD11 | At 30 V rail | Sensitivity
MDX DD11 (this manual) | 0.36 / 3.05 | 488 mA | +0.0 dB | 1212 mA | +7.9 dB
Fisher F2 / F4 family (2.4 mH / 2.4 mH) | 2.40 / 2.40 | 73 mA | -9.3 dB | 182 mA | -1.4 dB
Tesoro family (5.6 mH / 6.2 mH, 25 ohm) | 5.60 / 6.20 | 31 mA | -8.8 dB | 78 mA | -0.9 dB
DetectorPro 2.4 kHz coils (9.5 mH / 10.3 mH) | 9.50 / 10.30 | 18 mA | -8.9 dB | 46 mA | -1.0 dB

### Reading the table

Sensitivity here is transmit ampere-turns times receive turns, relative to the MDX coil at 12 V, assuming similar geometry. A high-inductance coil has more turns per volt of drive but proportionally less current, so it loses about 9 dB at the default rail and recovers to within about 1 dB when TX power is set to 10 (30 V). Set TX power to 8 to 10 for any coil above 1 mH. The published figures for these families come from Geotech forum measurements; measure your own coil with the wizard, since manufacturers do not publish them.

### Identify the windings

1. With an ohmmeter at the coil plug, find the two pairs. The lower-resistance pair (typically 1 to 6 Ω on modern coils, up to 25 Ω on older ones) is TX; the higher pair is RX. On a five-pin plug the fifth pin is the shield.
2. If both pairs read the same, wind three turns of any wire round the coil, drive it from a signal generator, and the pair with the larger induced voltage is RX (more turns).
3. Note any built-in capacitor across a winding (some brands resonate the TX): it must be removed, since the MDX-1 drives a rectangular waveform.

### Adapter and setup

1. Make an adapter from the coil's plug to the M12 socket using the pinout in section 6. Leave pin 6 unconnected (no chip); the firmware falls back to its internal record.
2. Menu → Coil wizard. Step 1 measures L and R; if L is above 8 mH or R above 40 Ω the wizard warns that TX current will be low.
3. Air null, ferrite, coin: as for the MDX coil. Save.
4. Set TX power 8 to 10 for coils above 1 mH. Watch the OVERLOAD flag on the home screen: a poorly nulled commercial coil can exceed the 125 mV input range at high power; reduce TX power until it clears.
5. Noise cancel, then ground balance as usual.

Self-resonance: 6 to 10 mH receive windings with their own cable often resonate between 60 and 100 kHz. The 41 kHz line then sits near resonance, where the winding's gain and phase move with temperature. The wizard's rotation step compensates the phase at the time of calibration; if the 41 kHz ID drifts in the field, run the air-null step again, or use the Multi mode's lower lines by selecting the Beach program, which weights 5 to 20 kHz.

10

## Safety

- PI and Hybrid modes put ±100 V edges on the TX winding and cable. Use only the specified cable and connector, and do not use an off-the-shelf coil in PI mode unless its TX winding insulation and connector are rated for 150 V. The Multi and single-frequency modes stay under 30 V.
- The transmit winding dissipates under 0.5 W in any mode; no thermal precautions are needed.
- Potting resin: follow the manufacturer's ventilation and skin-protection guidance; low-exotherm resin only, in two pours, to avoid softening the shell.

Numbers in this manual are produced by tools/coil_calc.py (Neumann-formula inductance and mutual inductance on the D-shaped centre-lines) and match the firmware's coil model. Commercial coil inductances from Geotech forum threads on the TGSL, Tesoro and DetectorPro coils.
