pingpongshow/MDX-1/docs/MDX-1_schematic.pdf

1 | 2 | 3 | 4 | 5 | 6 | 7 | 8
1 | 2 | 3 | 4 | 5 | 6 | 7 | 8

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
Size: A3 | Rev: A4 | F Date: 2026-09-05
KiCad E.D.A. 10.0.5 | Id: 1/9

# Title: MDX-1 multi-frequency / PI metal detector

### File: mdx1.kicad_sch

### Sheet: /

## Open hardware design (generated)

### Simultaneous 5-frequency VLF-IB + bipolar PI, 24-bit RX

UI board (separate PCB): memory LCD, 6-key pad + pinpoint + power, LEDs, front-light File: ui_board.kicad_sch UI, audio, wireless: memory LCD, keypad, IMU, headphone + speaker amps, Bluetooth audio, GNSS

File: ui_audio_rf.kicad_sch | RX front end: coil input protection, 20x differential preamp, ADC drivers
File: rx_frontend.kicad_sch | ADC: 2x ADS127L01 24-bit 512 kSPS, 2.5 V reference

## File: adc.kicad_sch Search coil assembly (DD 11 in): windings, shield, ID chip

## File: coil.kicad_sch MCU: STM32H743ZI, clocks, debug, storage

## File: mcu.kicad_sch Power: charger, gauge, rails, TX boost converters

File: power.kicad_sch

## TX driver: 3-level H-bridge, current sense, over-current trip

File: tx_driver.kicad_sch MDX-1 Simultaneous multi-frequency + pulse-induction metal detector

Generated from tools/mdx1_design.py - edit the generator, not the .kicad_sch files. Capacitors drawn at a pin belong to that pin.

Sheets: 1 Power 2 TX driver 3 RX front end 4 ADC 5 MCU 6 Audio/RF + UI link 7 UI board (separate PCB) 8 Coil. All inter-sheet signals are global labels.

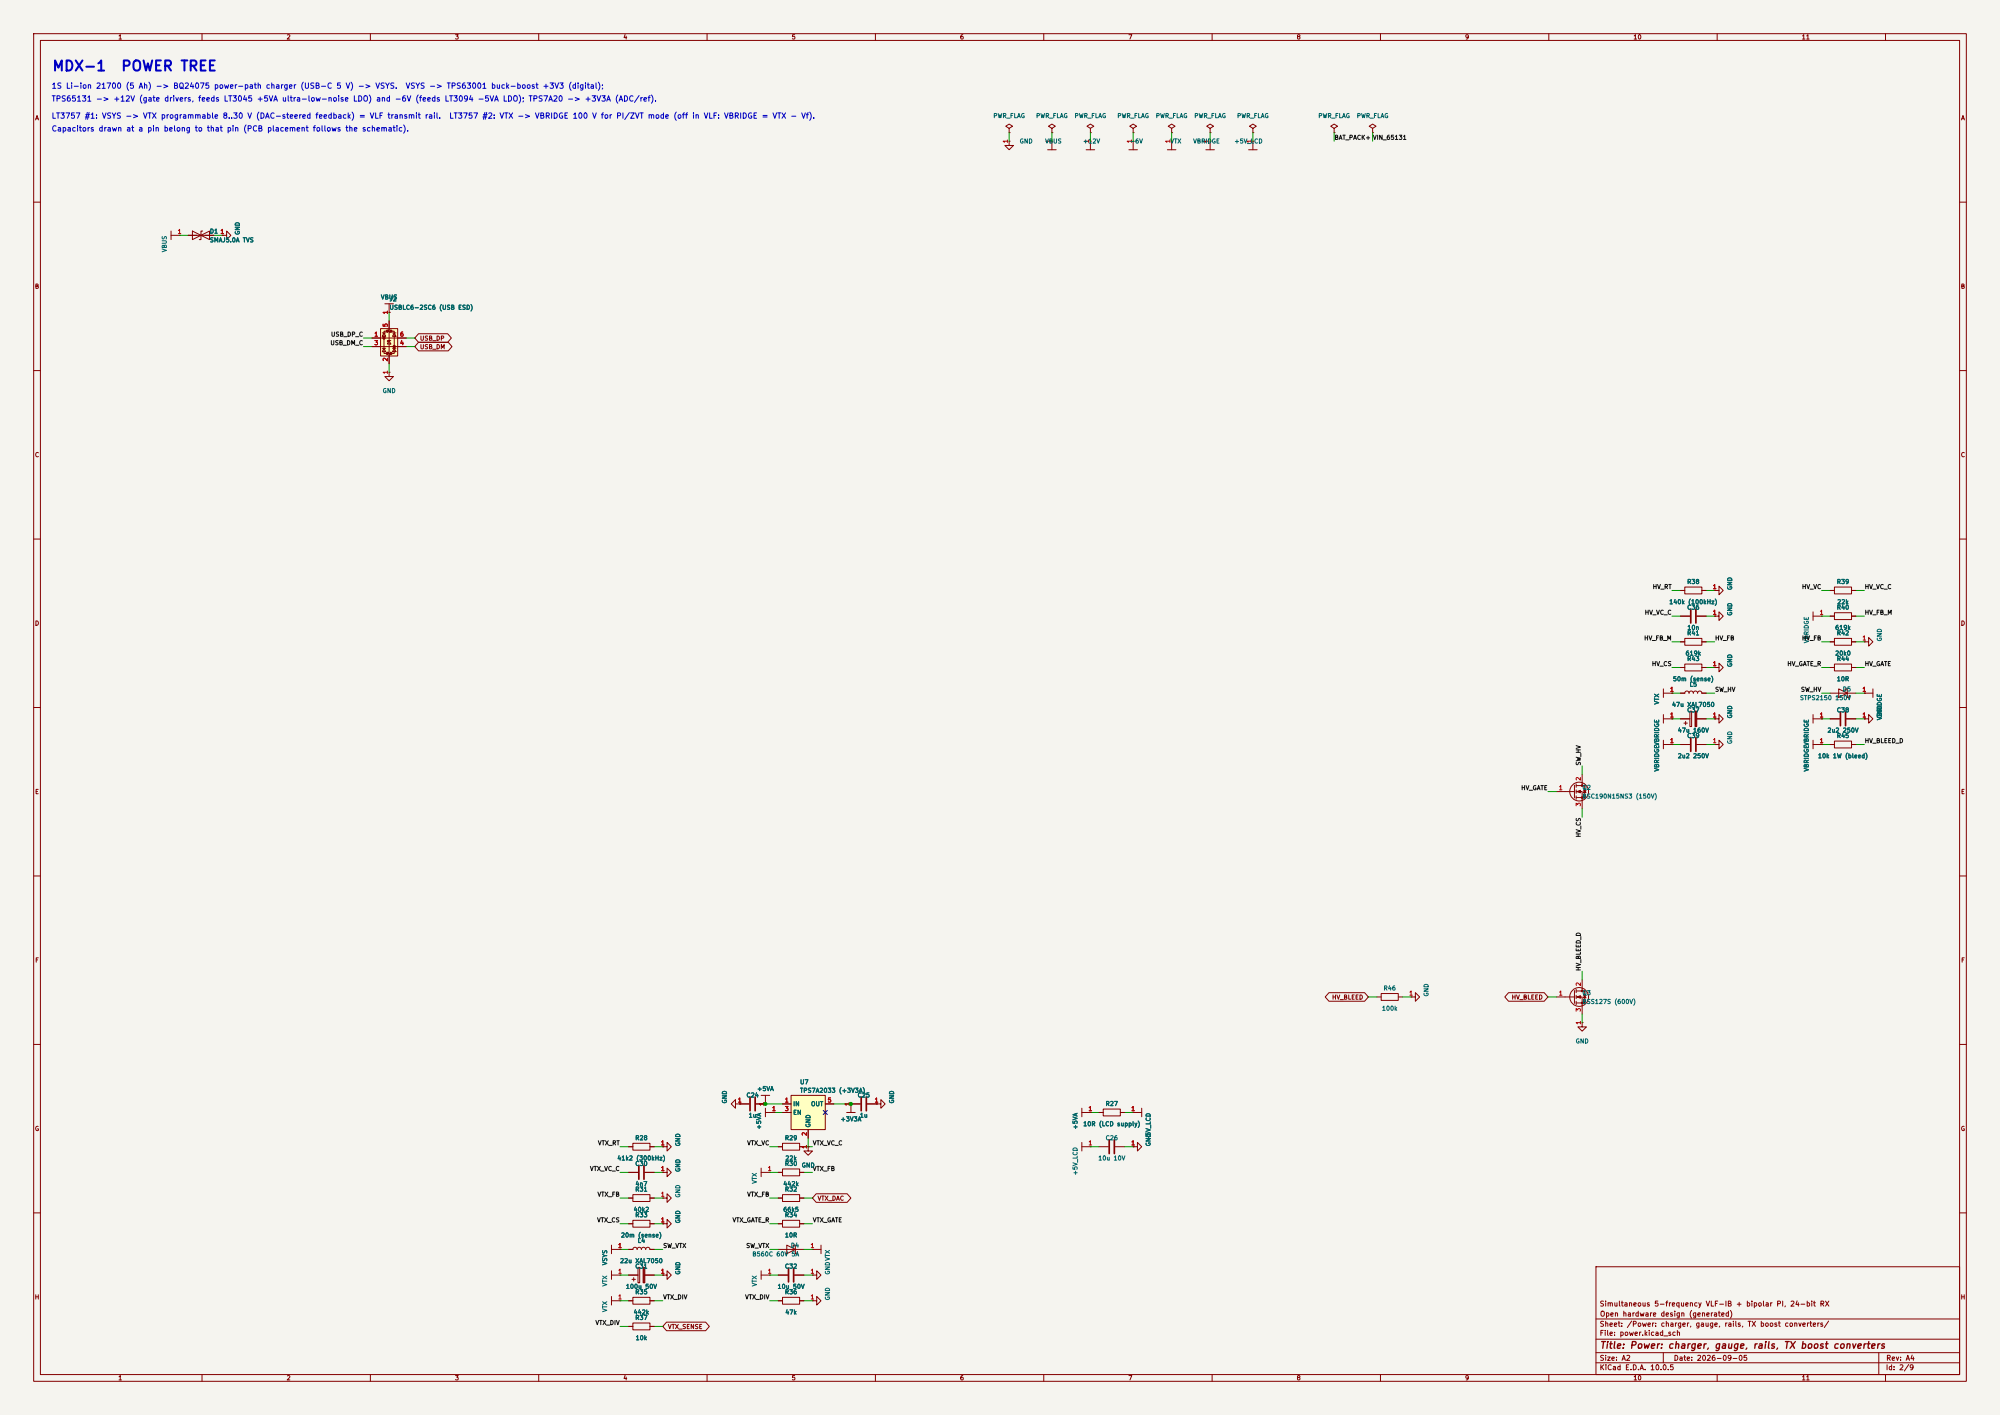
[picture p17: page 2]

Simultaneous 5-frequency VLF-IB + bipolar PI, 24-bit RX GND

TPS65131 -> +12V (gate drivers, feeds LT3045 +5VA ultra-low-noise LDO) and -6V (feeds LT3094 -5VA LDO); TPS7A20 -> +3V3A (ADC/ref).

Capacitors drawn at a pin belong to that pin (PCB placement follows the schematic).

Open hardware design (generated)
Sheet: /Power: charger, gauge, rails, TX boost converters/
File: power.kicad_sch
Title: Power: charger, gauge, rails, TX boost converters

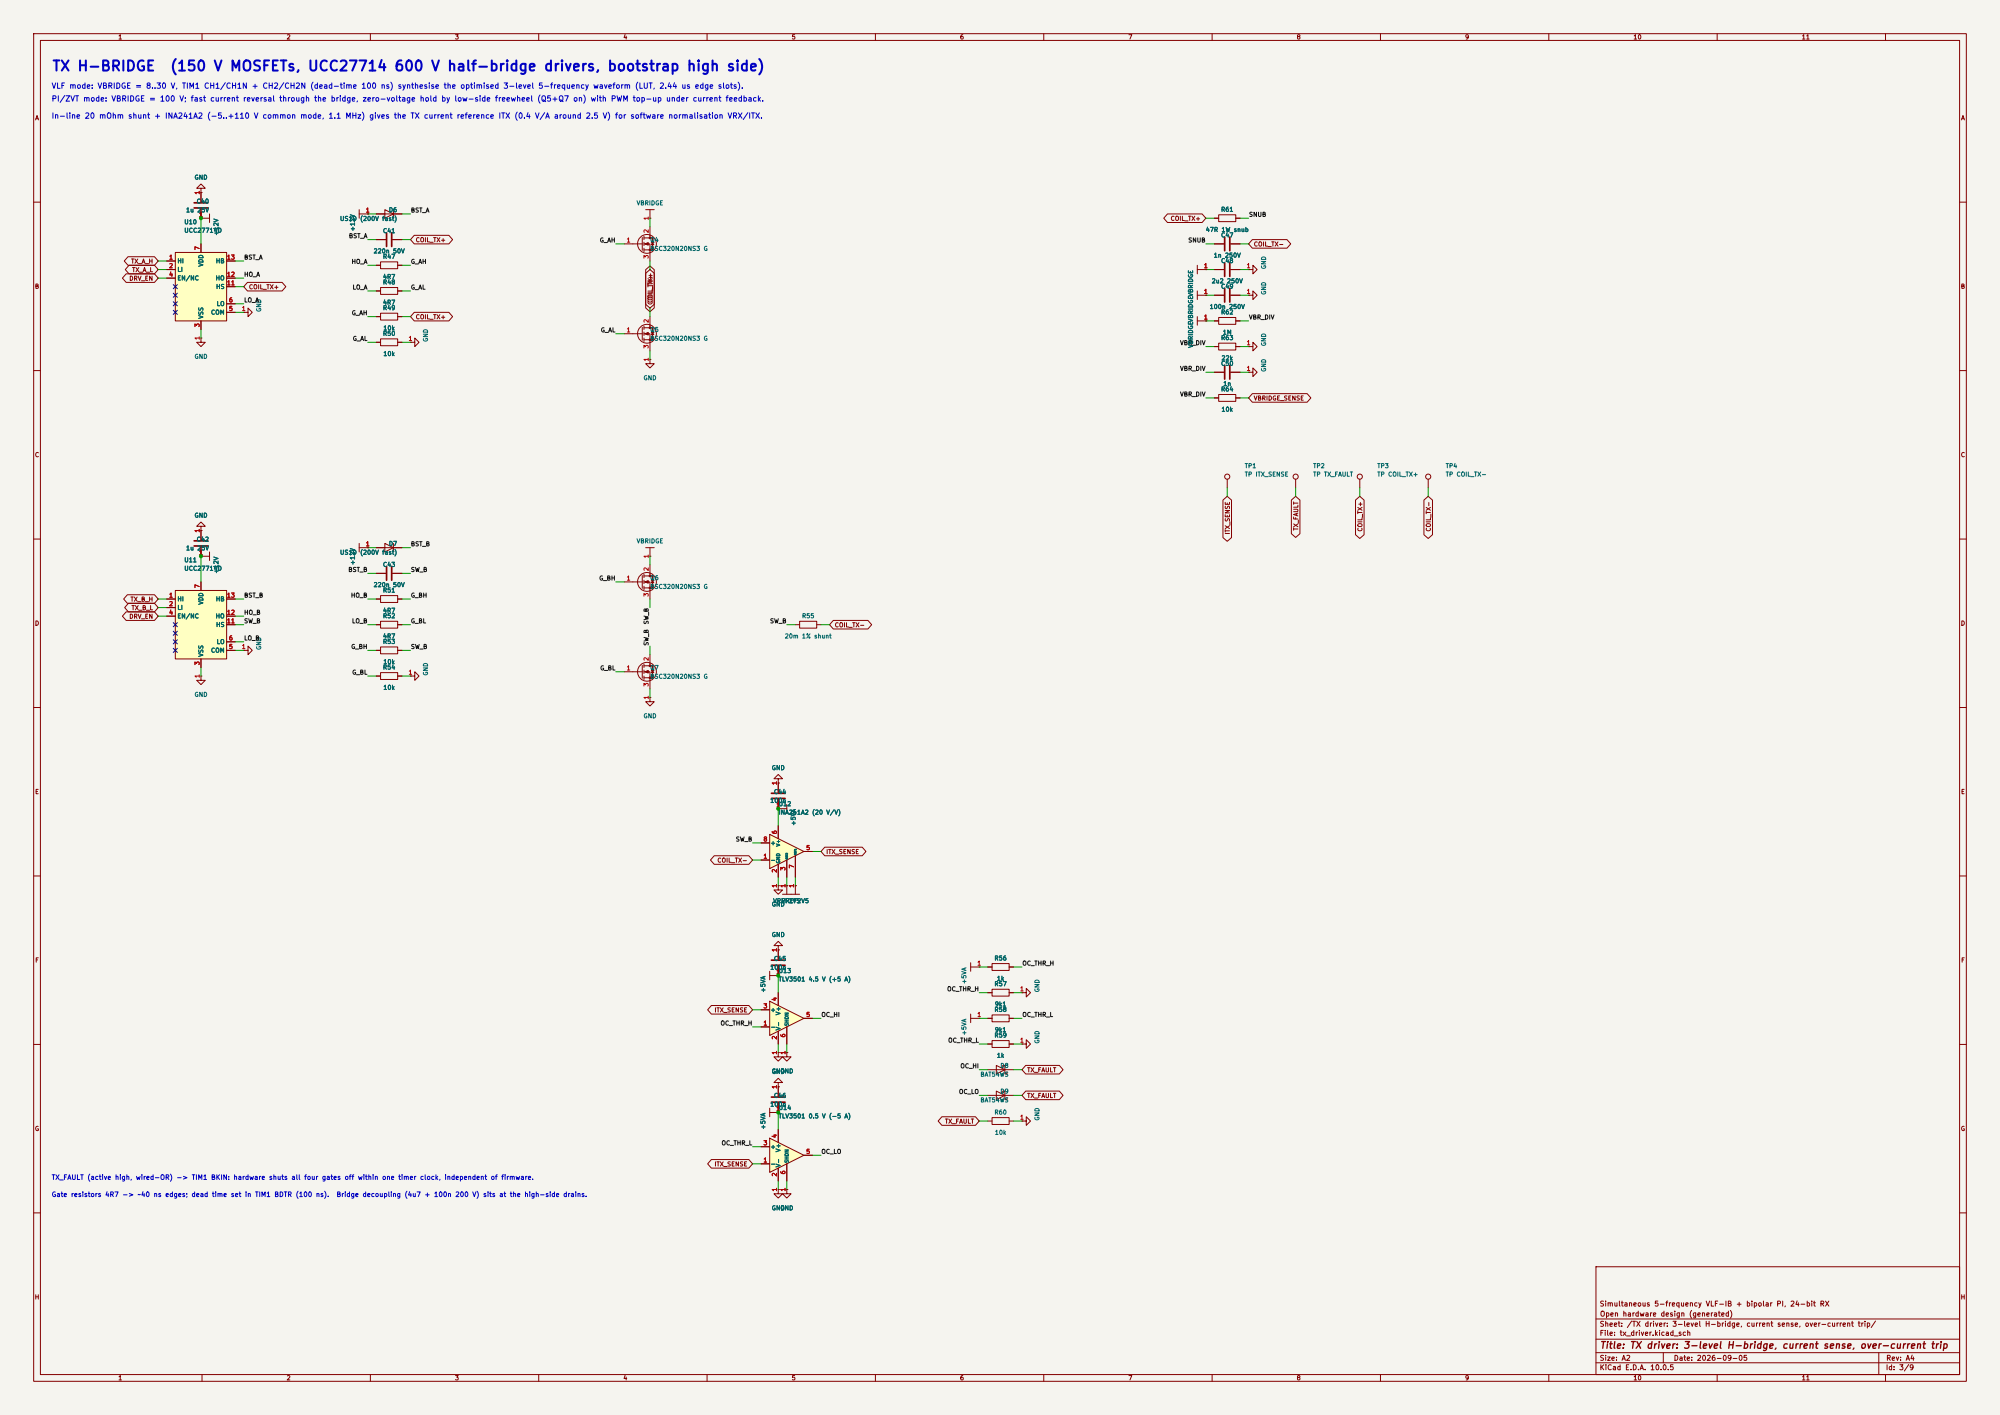
[picture p18: page 3]

TX H-BRIDGE (150 V MOSFETs, UCC27714 600 V half-bridge drivers, bootstrap high side)

VLF mode: VBRIDGE = 8..30 V, TIM1 CH1/CH1N + CH2/CH2N (dead-time 100 ns) synthesise the optimised 3-level 5-frequency waveform (LUT, 2.44 us edge slots).

PI/ZVT mode: VBRIDGE = 100 V; fast current reversal through the bridge, zero-voltage hold by low-side freewheel (Q5+Q7 on) with PWM top-up under current feedback.

In-line 20 mOhm shunt + INA241A2 (-5..+110 V common mode, 1.1 MHz) gives the TX current reference ITX (0.4 V/A around 2.5 V) for software normalisation VRX/ITX.

TX_FAULT (active high, wired-OR) -> TIM1 BKIN: hardware shuts all four gates off within one timer clock, independent of firmware. Gate resistors 4R7 -> ~40 ns edges; dead time set in TIM1 BDTR (100 ns). Bridge decoupling (4u7 + 100n 200 V) sits at the high-side drains.

Simultaneous 5-frequency VLF-IB + bipolar PI, 24-bit RX

Sheet: /TX driver: 3-level H-bridge, current sense, over-current trip/
File: tx_driver.kicad_sch
Title: TX driver: 3-level H-bridge, current sense, over-current trip

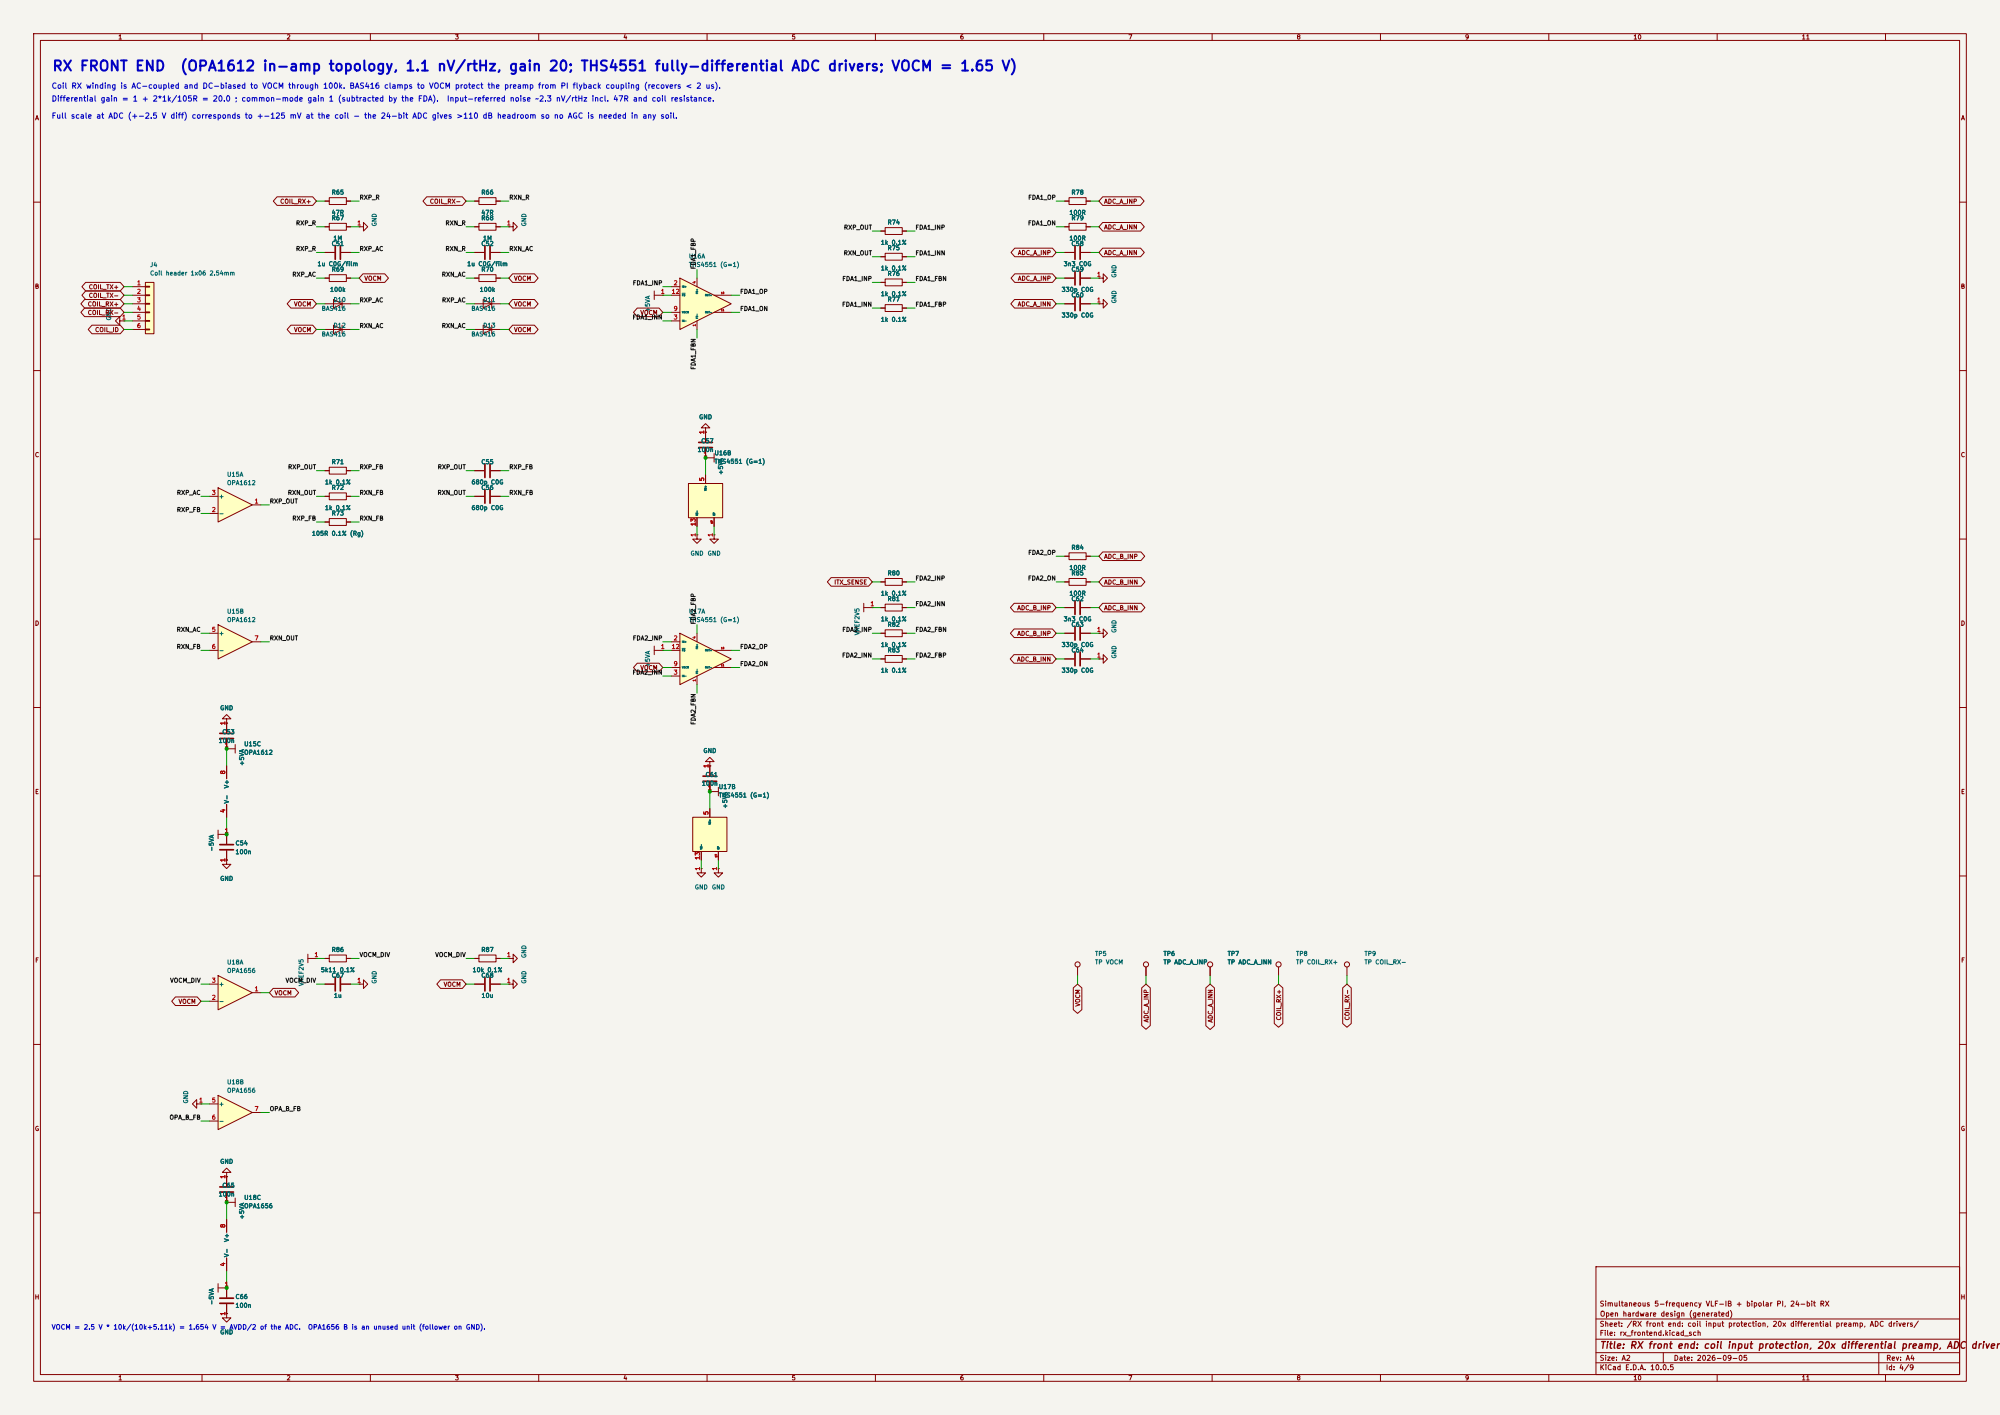
[picture p19: page 4]

RX FRONT END (OPA1612 in-amp topology, 1.1 nV/rtHz, gain 20; THS4551 fully-differential ADC drivers; VOCM = 1.65 V)

Coil RX winding is AC-coupled and DC-biased to VOCM through 100k. BAS416 clamps to VOCM protect the preamp from PI flyback coupling (recovers < 2 us).

Full scale at ADC (+-2.5 V diff) corresponds to +-125 mV at the coil - the 24-bit ADC gives >110 dB headroom so no AGC is needed in any soil.

VOCM = 2.5 V * 10k/(10k+5.11k) = 1.654 V = AVDD/2 of the ADC. OPA1656 B is an unused unit (follower on GND).

Sheet: /RX front end: coil input protection, 20x differential preamp, ADC drivers/
File: rx_frontend.kicad_sch
Title: RX front end: coil input protection, 20x differential preamp, ADC drivers

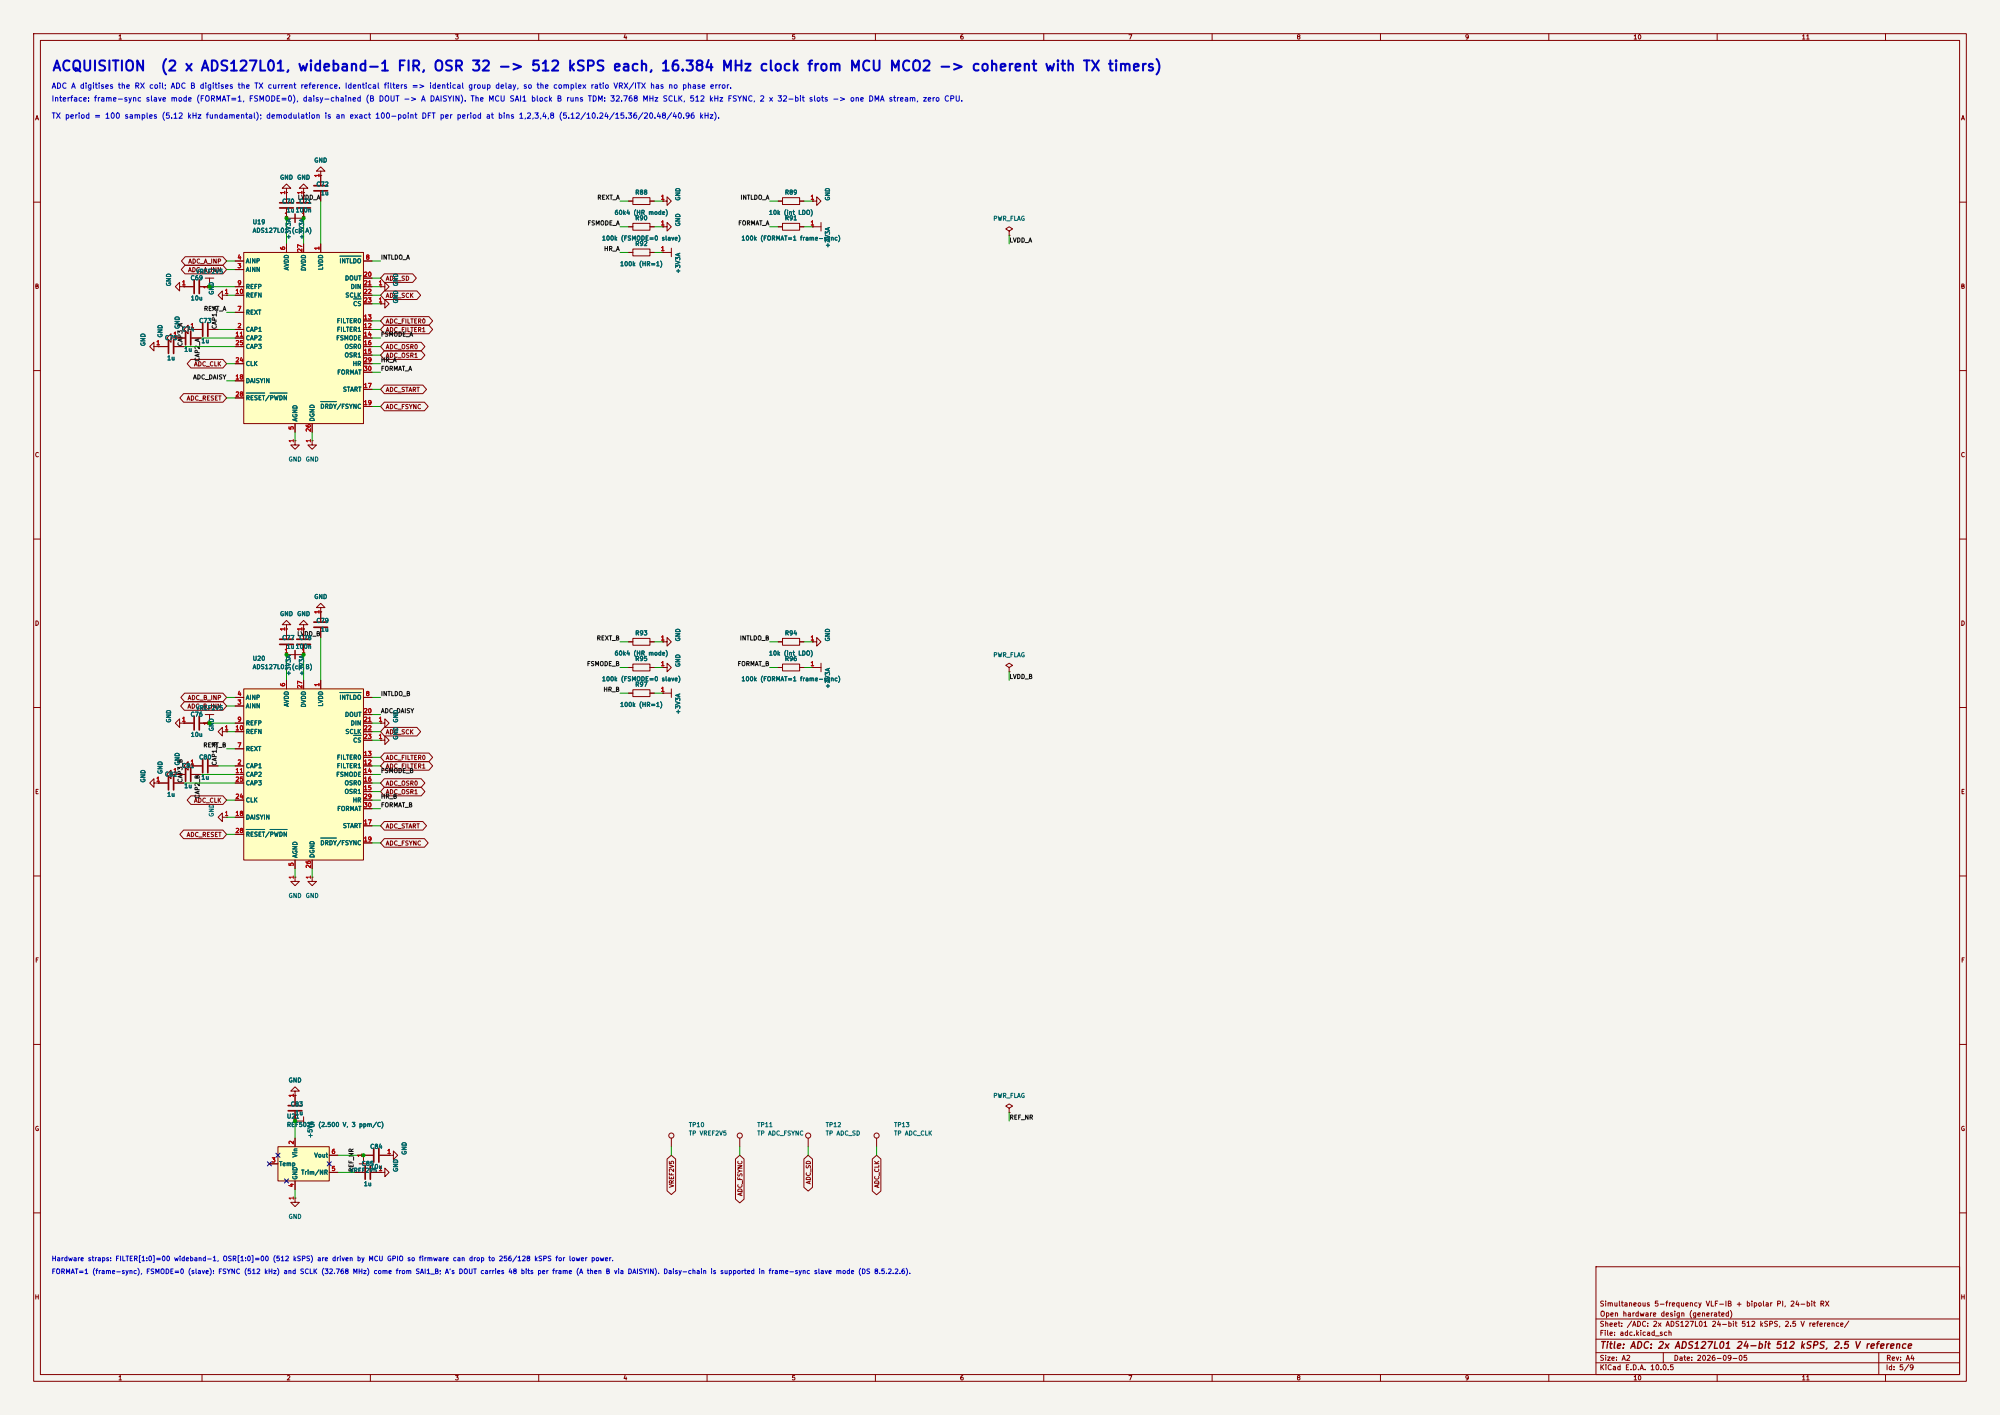
[picture p20: page 5]

ACQUISITION (2 x ADS127L01, wideband-1 FIR, OSR 32 -> 512 kSPS each, 16.384 MHz clock from MCU MCO2 -> coherent with TX timers)

ADC A digitises the RX coil; ADC B digitises the TX current reference. Identical filters => identical group delay, so the complex ratio VRX/ITX has no phase error.
Interface: frame-sync slave mode (FORMAT=1, FSMODE=0), daisy-chained (B DOUT -> A DAISYIN). The MCU SAI1 block B runs TDM: 32.768 MHz SCLK, 512 kHz FSYNC, 2 x 32-bit slots -> one DMA stream, zero CPU.

TX period = 100 samples (5.12 kHz fundamental); demodulation is an exact 100-point DFT per period at bins 1,2,3,4,8 (5.12/10.24/15.36/20.48/40.96 kHz).

FORMAT=1 (frame-sync), FSMODE=0 (slave): FSYNC (512 kHz) and SCLK (32.768 MHz) come from SAI1_B; A's DOUT carries 48 bits per frame (A then B via DAISYIN). Daisy-chain is supported in frame-sync slave mode (DS 8.5.2.2.6). Hardware straps: FILTER[1:0]=00 wideband-1, OSR[1:0]=00 (512 kSPS) are driven by MCU GPIO so firmware can drop to 256/128 kSPS for lower power.

Sheet: /ADC: 2x ADS127L01 24-bit 512 kSPS, 2.5 V reference/
File: adc.kicad_sch
Title: ADC: 2x ADS127L01 24-bit 512 kSPS, 2.5 V reference

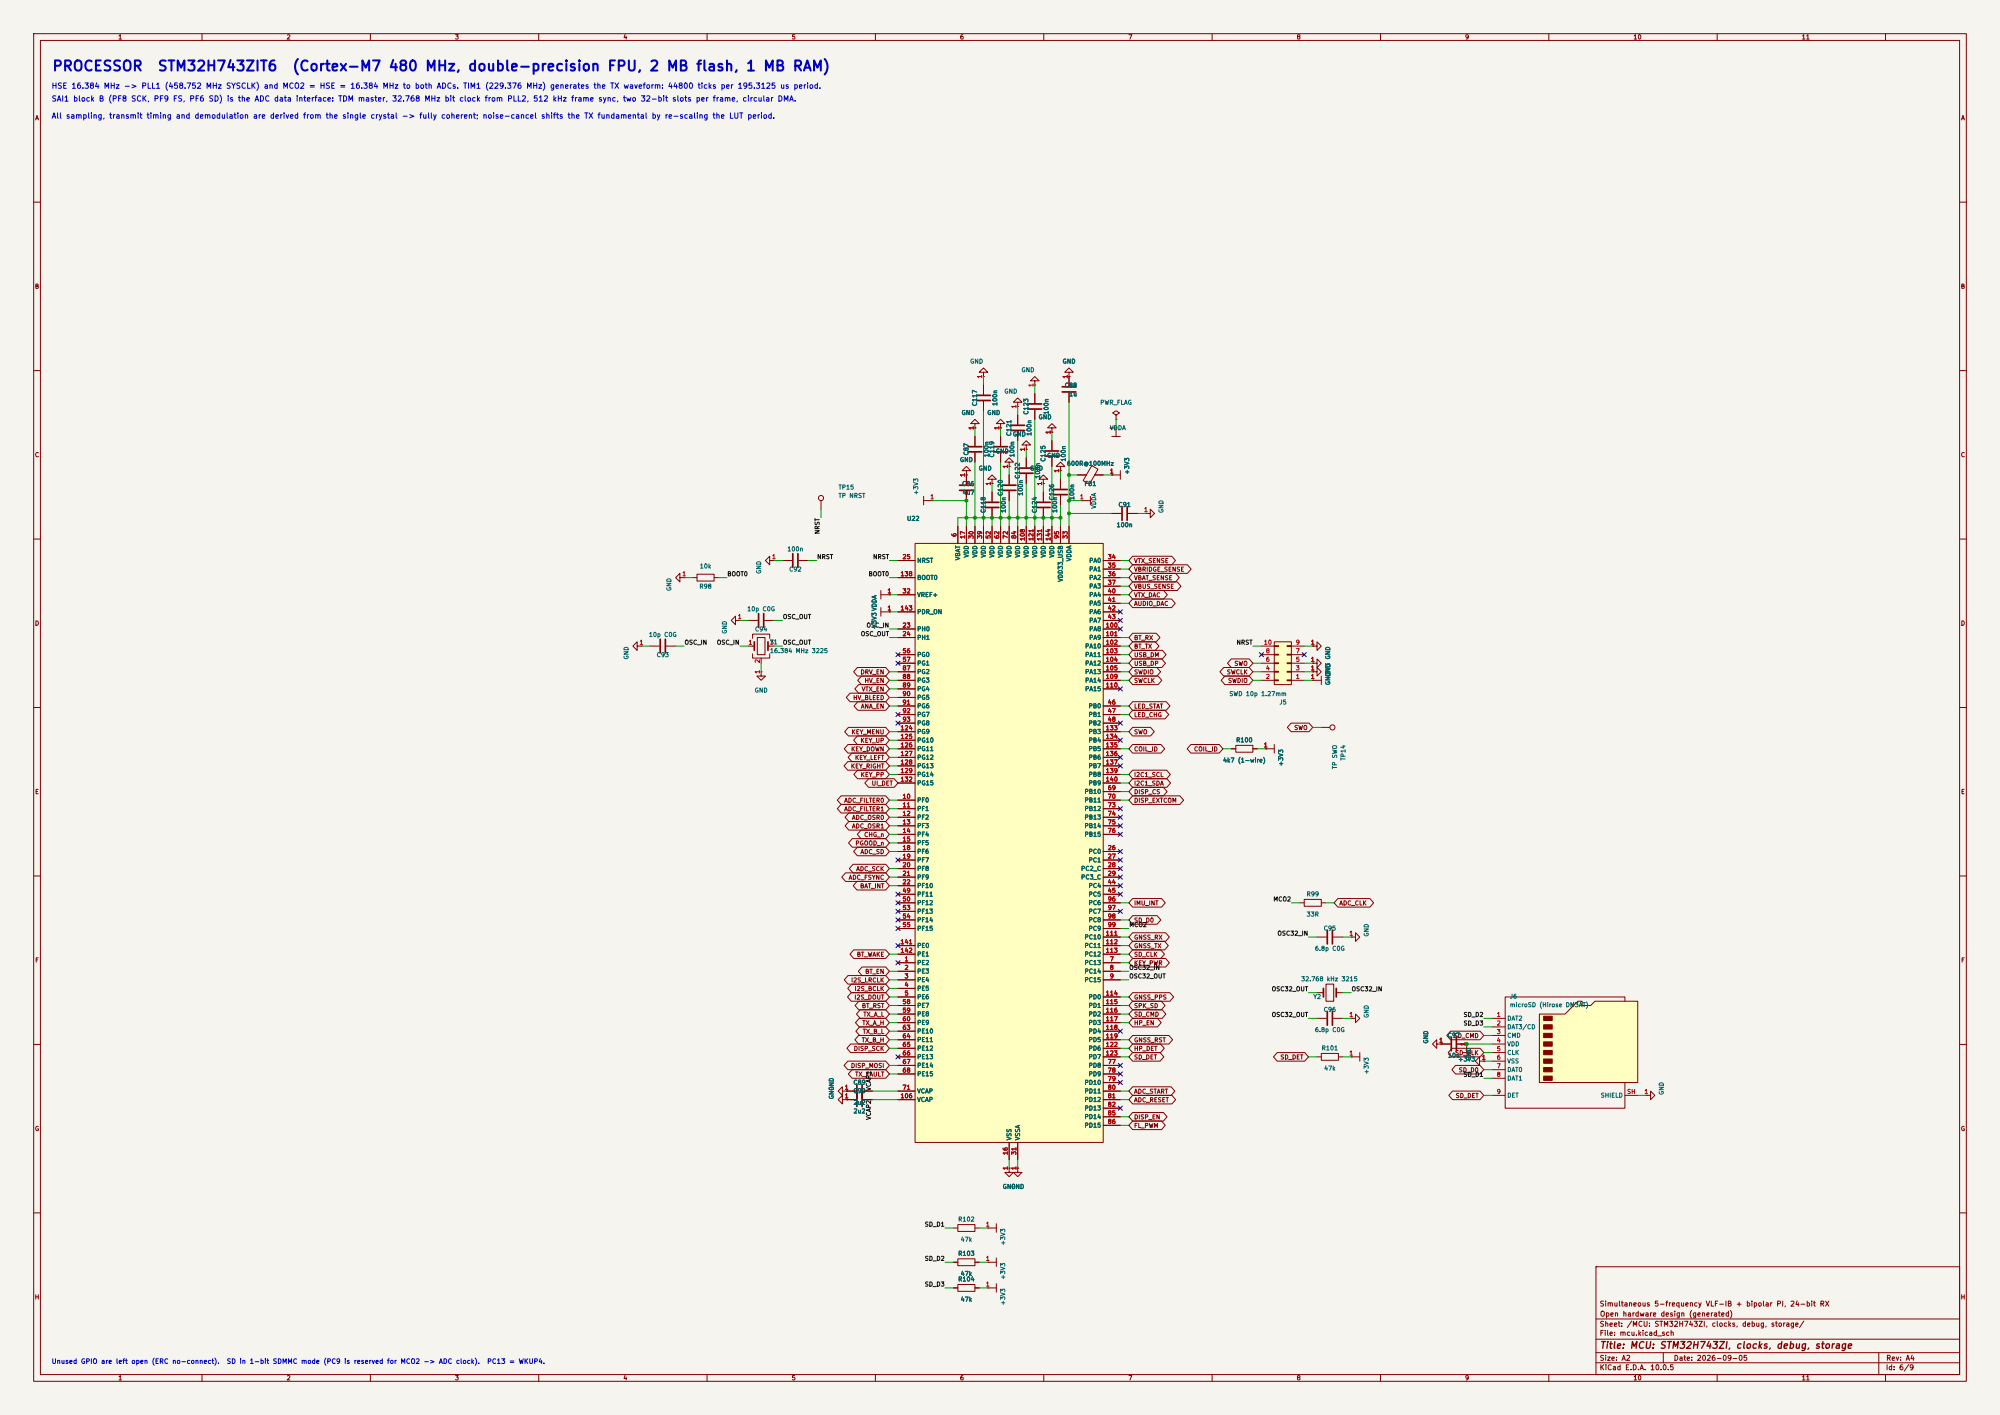
[picture p21: page 6]

PROCESSOR STM32H743ZIT6 (Cortex-M7 480 MHz, double-precision FPU, 2 MB flash, 1 MB RAM)

HSE 16.384 MHz -> PLL1 (458.752 MHz SYSCLK) and MCO2 = HSE = 16.384 MHz to both ADCs. TIM1 (229.376 MHz) generates the TX waveform: 44800 ticks per 195.3125 us period.
SAI1 block B (PF8 SCK, PF9 FS, PF6 SD) is the ADC data interface: TDM master, 32.768 MHz bit clock from PLL2, 512 kHz frame sync, two 32-bit slots per frame, circular DMA.

1 U22PE2 1 PE3 2 PE4 3 PE5 4 PE6 5 VBAT 6 PC13 7 PC14 8 PC15 9 PF0 10 PF1 11 PF2 12 PF3 13 PF4 14 PF5 15 VSS 16 VDD 17 PF6 18 PF7 19 PF8 20 PF9 21 PF10 22 PH0 23 PH1 24 NRST 25 PC0 26 PC1 27 PC2_C 28 PC3_C 29 VDD 30 VSSA 31

Sheet: /MCU: STM32H743ZI, clocks, debug, storage/
File: mcu.kicad_sch
Title: MCU: STM32H743ZI, clocks, debug, storage

Unused GPIO are left open (ERC no-connect). SD in 1-bit SDMMC mode (PC9 is reserved for MCO2 -> ADC clock). PC13 = WKUP4.

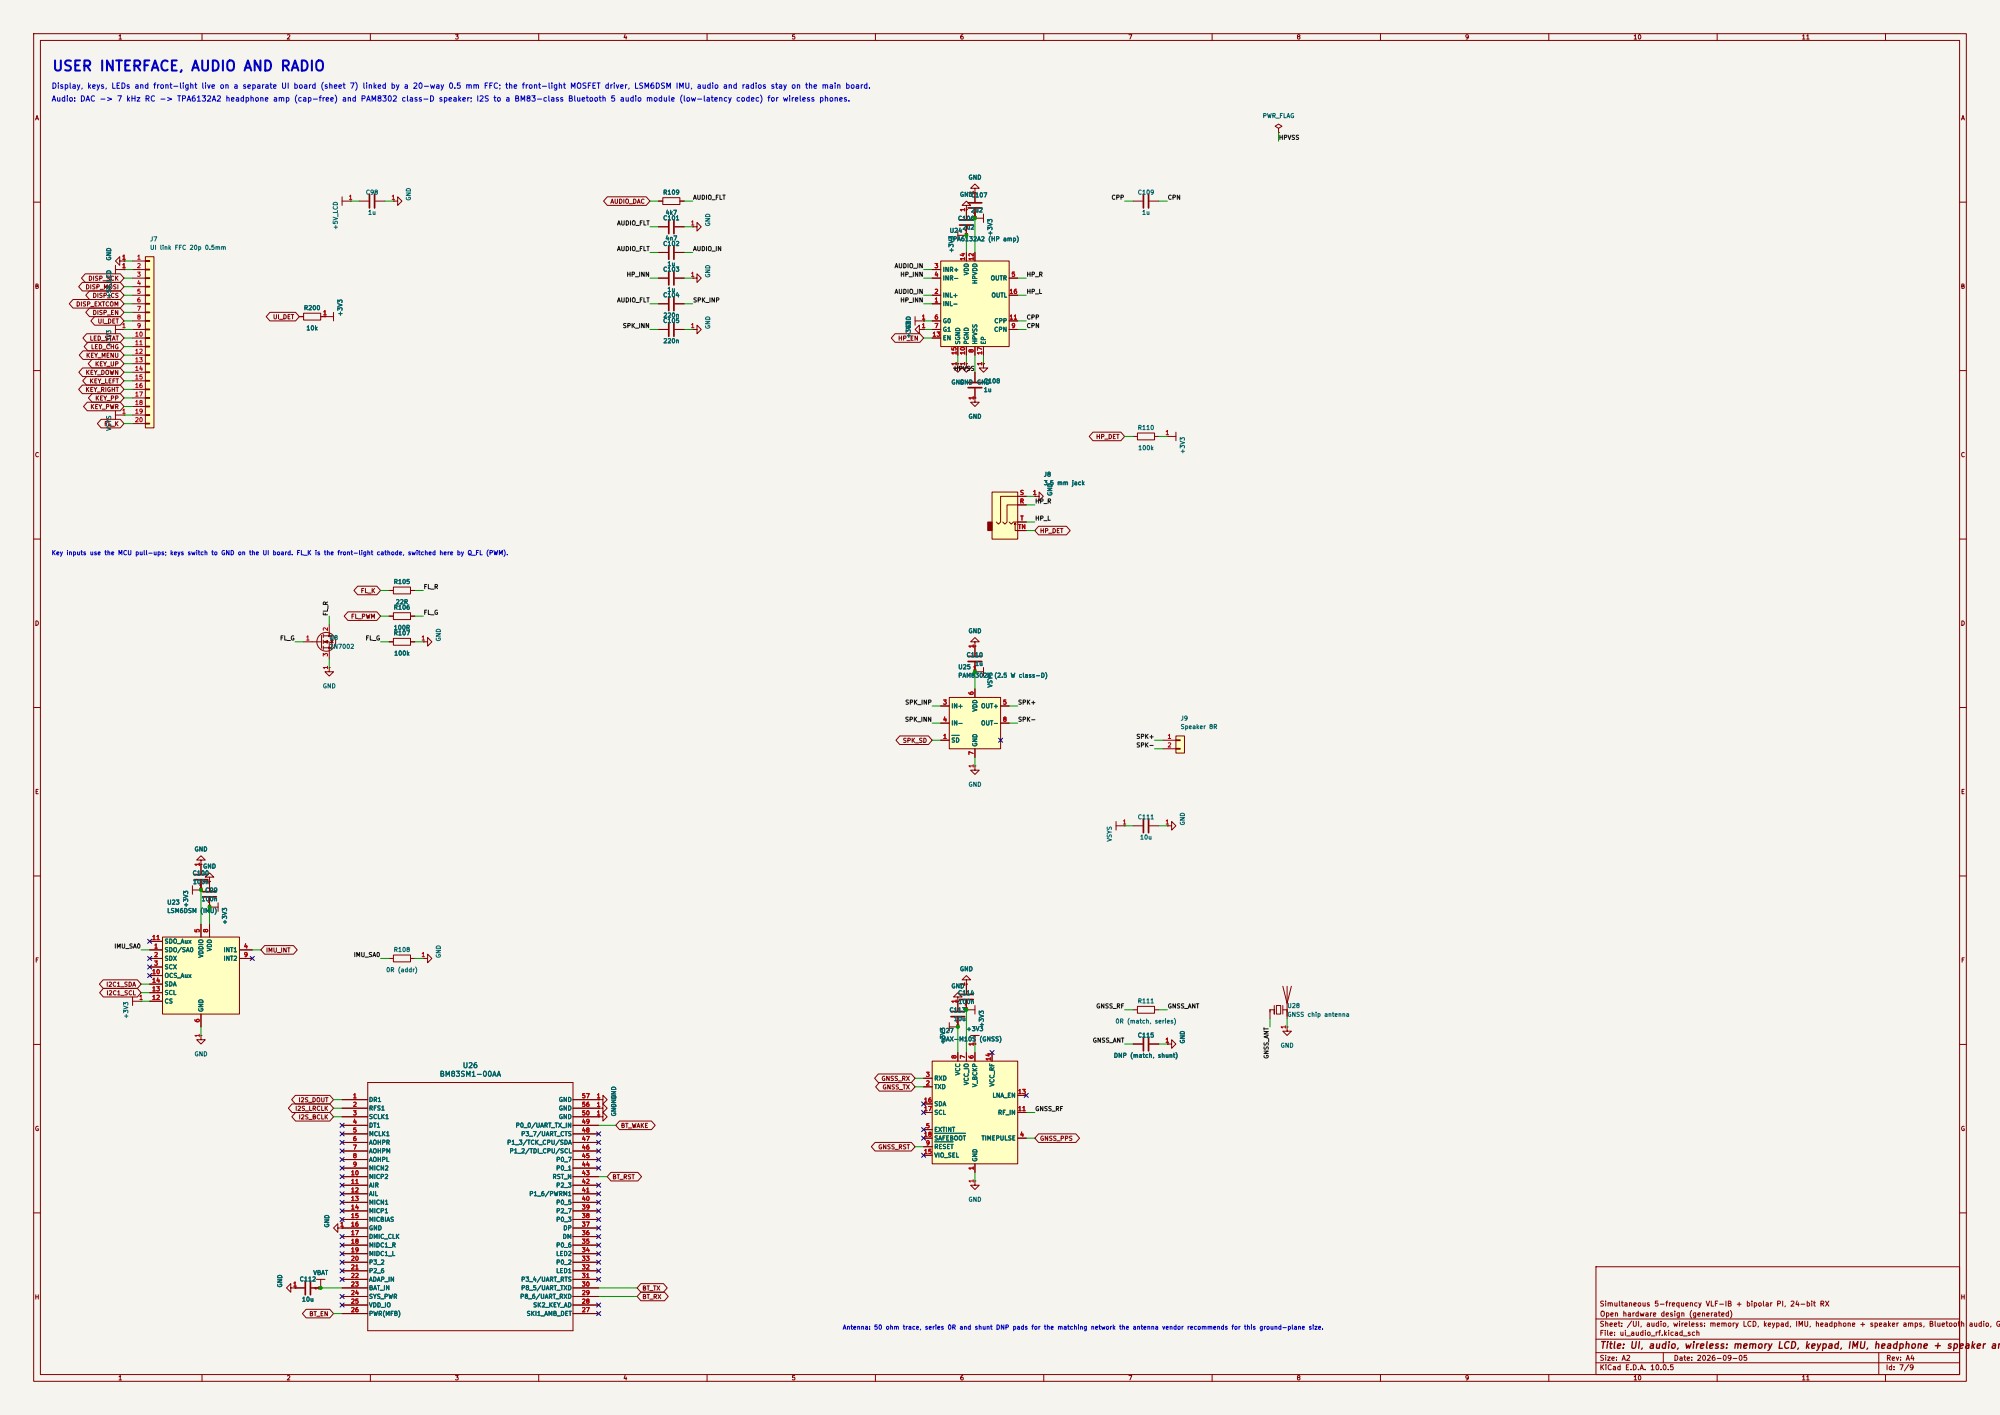
[picture p22: page 7]

CPP USER INTERFACE, AUDIO AND RADIO

Display, keys, LEDs and front-light live on a separate UI board (sheet 7) linked by a 20-way 0.5 mm FFC; the front-light MOSFET driver, LSM6DSM IMU, audio and radios stay on the main board.

Audio: DAC -> 7 kHz RC -> TPA6132A2 headphone amp (cap-free) and PAM8302 class-D speaker; I2S to a BM83-class Bluetooth 5 audio module (low-latency codec) for wireless phones.

8 CPN 9 PGND 10 CPP 11 HPVDD 12

Key inputs use the MCU pull-ups; keys switch to GND on the UI board. FL_K is the front-light cathode, switched here by Q_FL (PWM).

Antenna: 50 ohm trace, series 0R and shunt DNP pads for the matching network the antenna vendor recommends for this ground-plane size. U27 MAX-M10S (GNSS) GND

Sheet: /UI, audio, wireless: memory LCD, keypad, IMU, headphone + speaker amps, Bluetooth audio, GNSS/
File: ui_audio_rf.kicad_sch
Title: UI, audio, wireless: memory LCD, keypad, IMU, headphone + speaker amps, Bluetooth audio, GNSS

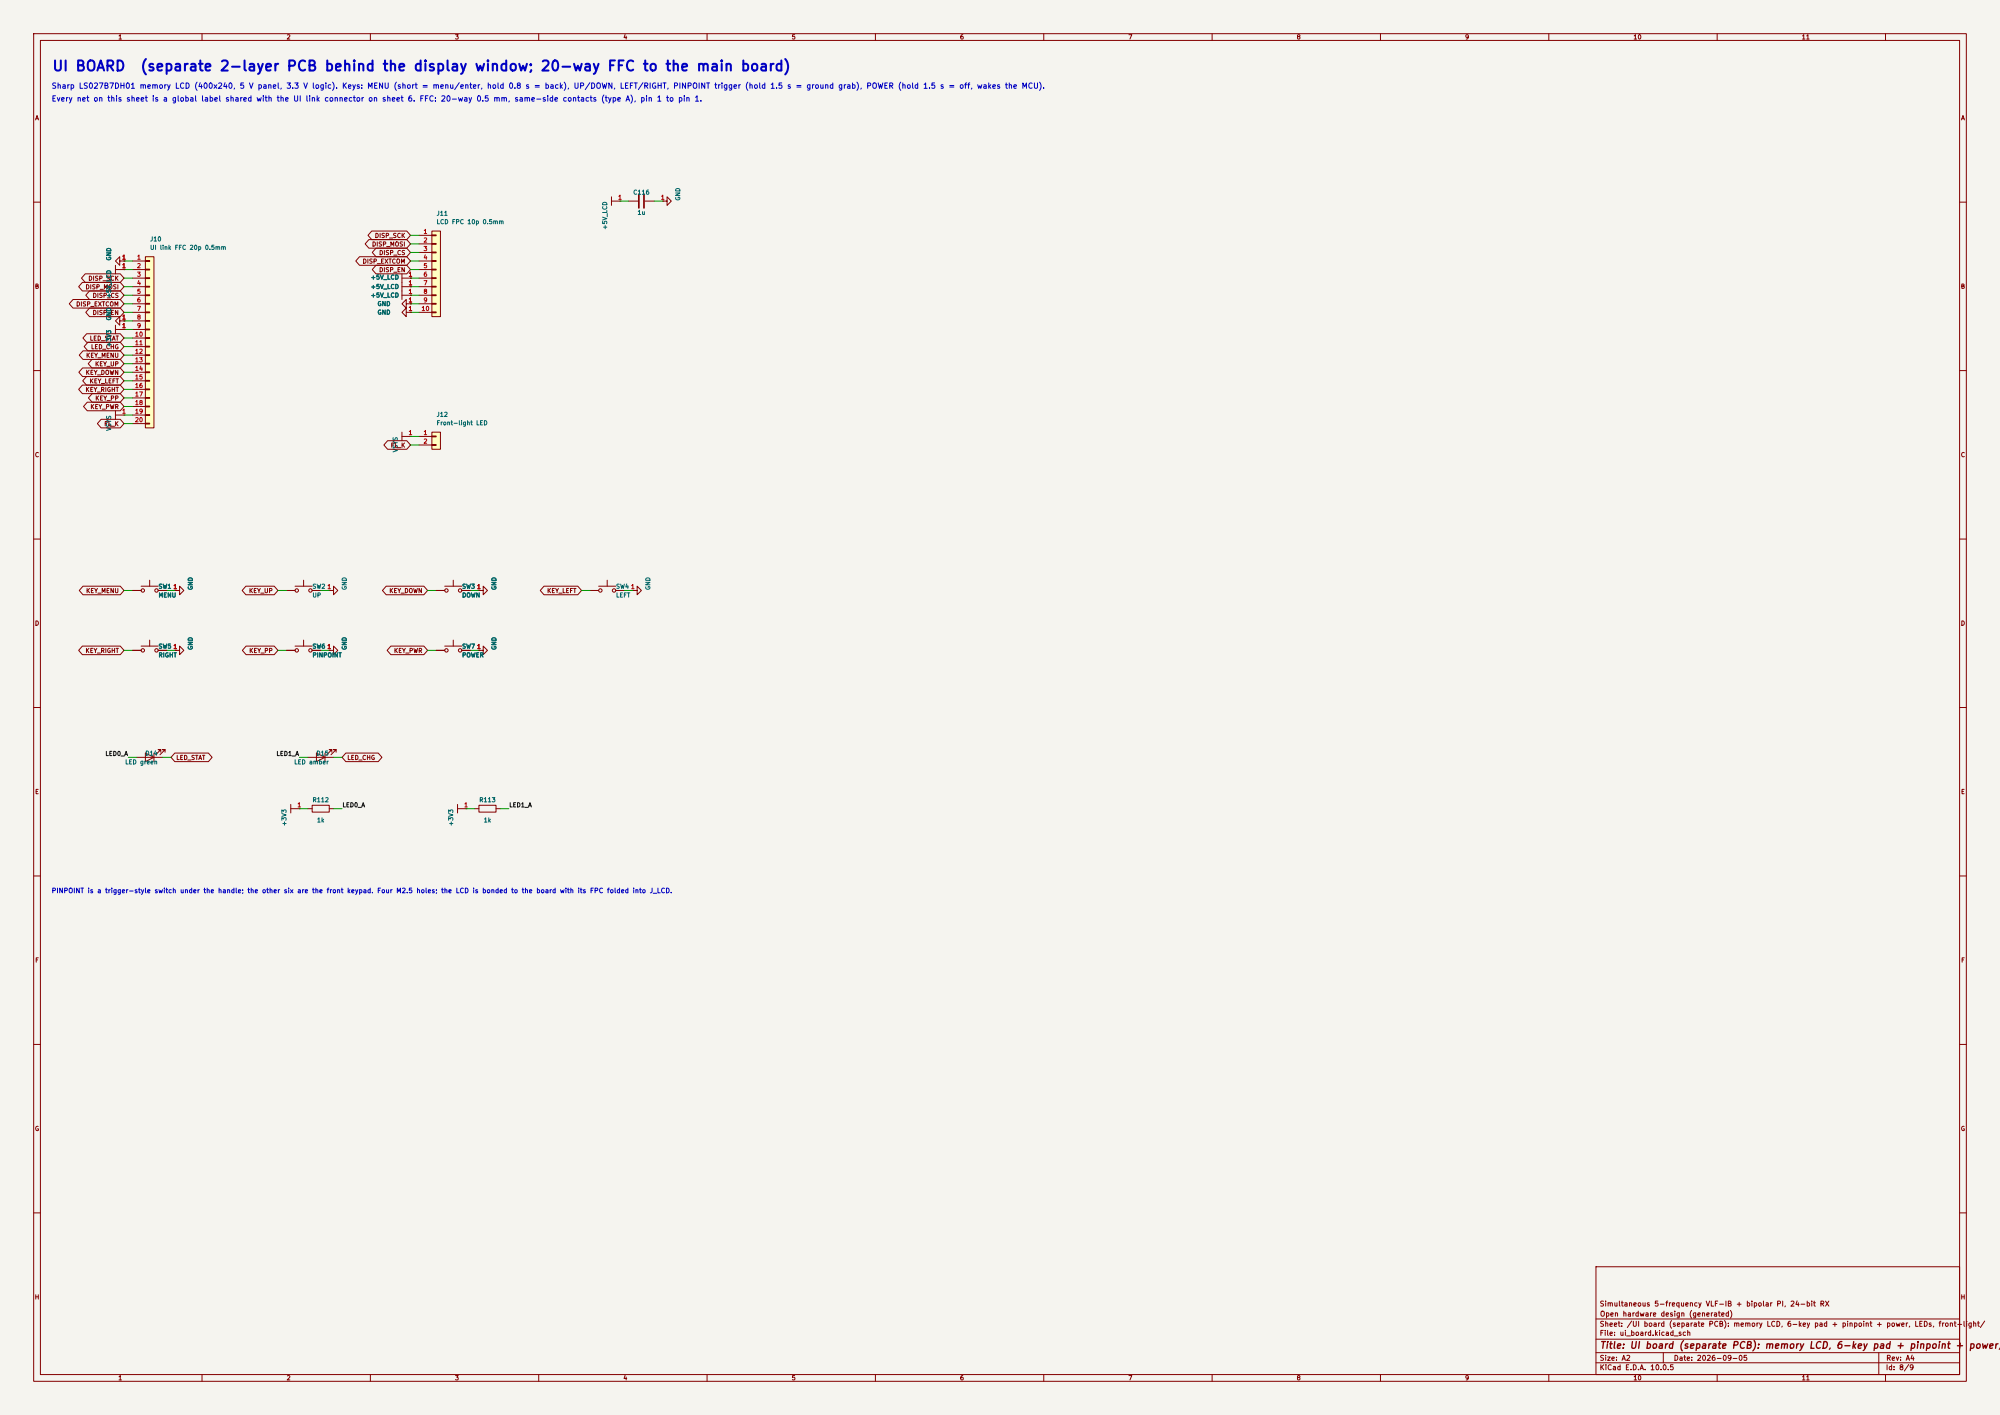
[picture p23: page 8]

UI BOARD (separate 2-layer PCB behind the display window; 20-way FFC to the main board)

Sharp LS027B7DH01 memory LCD (400x240, 5 V panel, 3.3 V logic). Keys: MENU (short = menu/enter, hold 0.8 s = back), UP/DOWN, LEFT/RIGHT, PINPOINT trigger (hold 1.5 s = ground grab), POWER (hold 1.5 s = off, wakes the MCU).

Every net on this sheet is a global label shared with the UI link connector on sheet 6. FFC: 20-way 0.5 mm, same-side contacts (type A), pin 1 to pin 1.

Sheet: /UI board (separate PCB): memory LCD, 6-key pad + pinpoint + power, LEDs, front-light/
File: ui_board.kicad_sch
Title: UI board (separate PCB): memory LCD, 6-key pad + pinpoint + power, LEDs, front-light

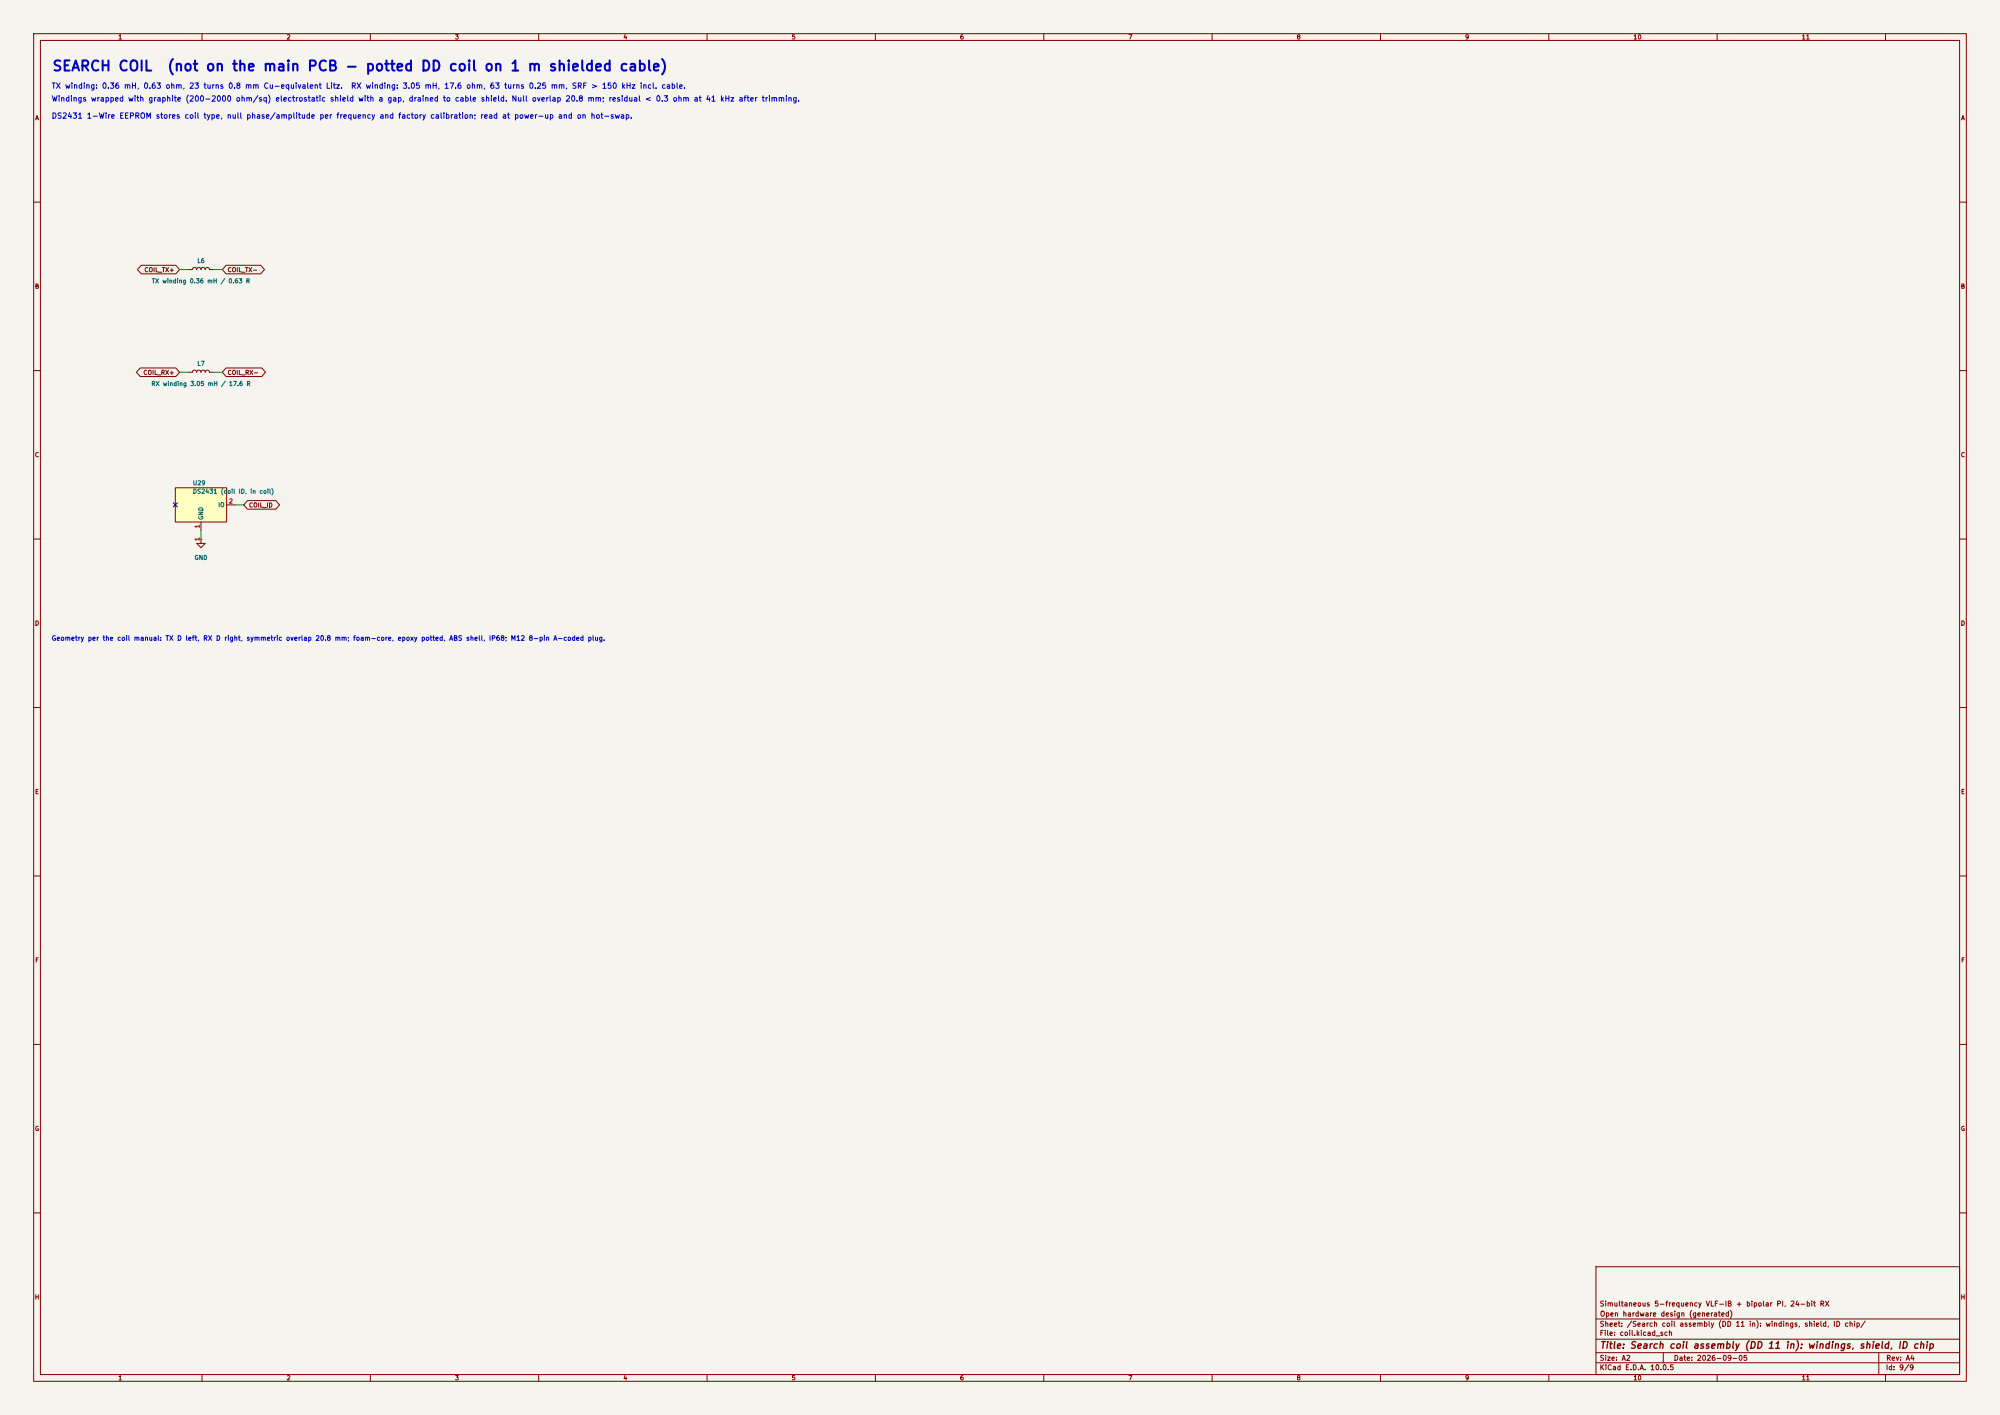
[picture p24: page 9]

SEARCH COIL (not on the main PCB - potted DD coil on 1 m shielded cable)

Windings wrapped with graphite (200-2000 ohm/sq) electrostatic shield with a gap, drained to cable shield. Null overlap 20.8 mm; residual < 0.3 ohm at 41 kHz after trimming.

DS2431 1-Wire EEPROM stores coil type, null phase/amplitude per frequency and factory calibration; read at power-up and on hot-swap.

Geometry per the coil manual: TX D left, RX D right, symmetric overlap 20.8 mm; foam-core, epoxy potted, ABS shell, IP68; M12 8-pin A-coded plug.

Sheet: /Search coil assembly (DD 11 in): windings, shield, ID chip/
File: coil.kicad_sch
Title: Search coil assembly (DD 11 in): windings, shield, ID chip
