pingpongshow/MDX-1/(list of files, drawings)

Other design files:
hardware/mdx1/mdx1_route3.dsn
