pingpongshow/MDX-1/hardware/mdx1/mdx1.kicad_pcb

## KiCad design hardware/mdx1/mdx1.kicad_pcb (2026-09-26)

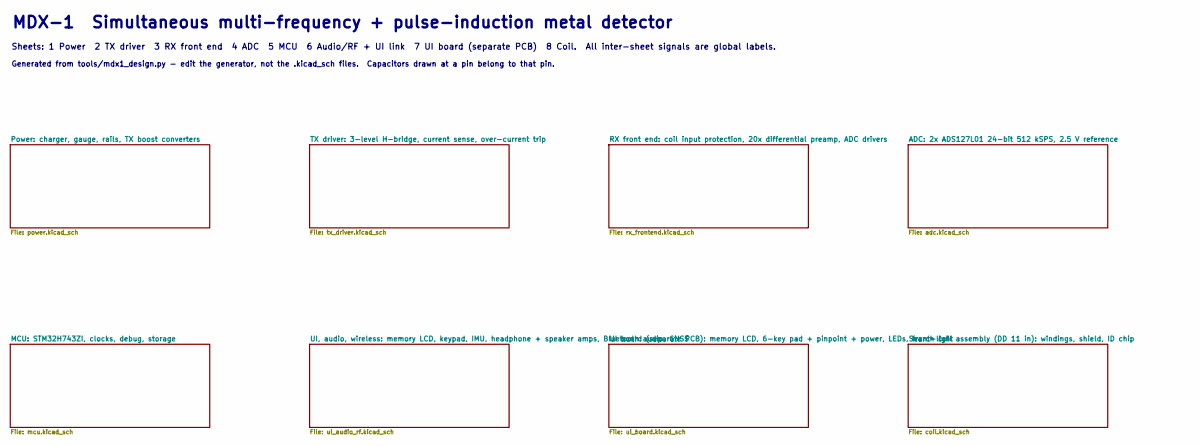
[picture p25: schematic mdx1.kicad_sch, MDX-1 multi-frequency / PI metal detector]

Notes on the sheet:
MDX-1 Simultaneous multi-frequency + pulse-induction metal detector
Generated from tools/mdx1_design.py - edit the generator, not the .kicad_sch files. Capacitors drawn at a pin belong to that pin.
Sheets: 1 Power 2 TX driver 3 RX front end 4 ADC 5 MCU 6 Audio/RF + UI link 7 UI board (separate PCB) 8 Coil. All inter-sheet signals are global labels.

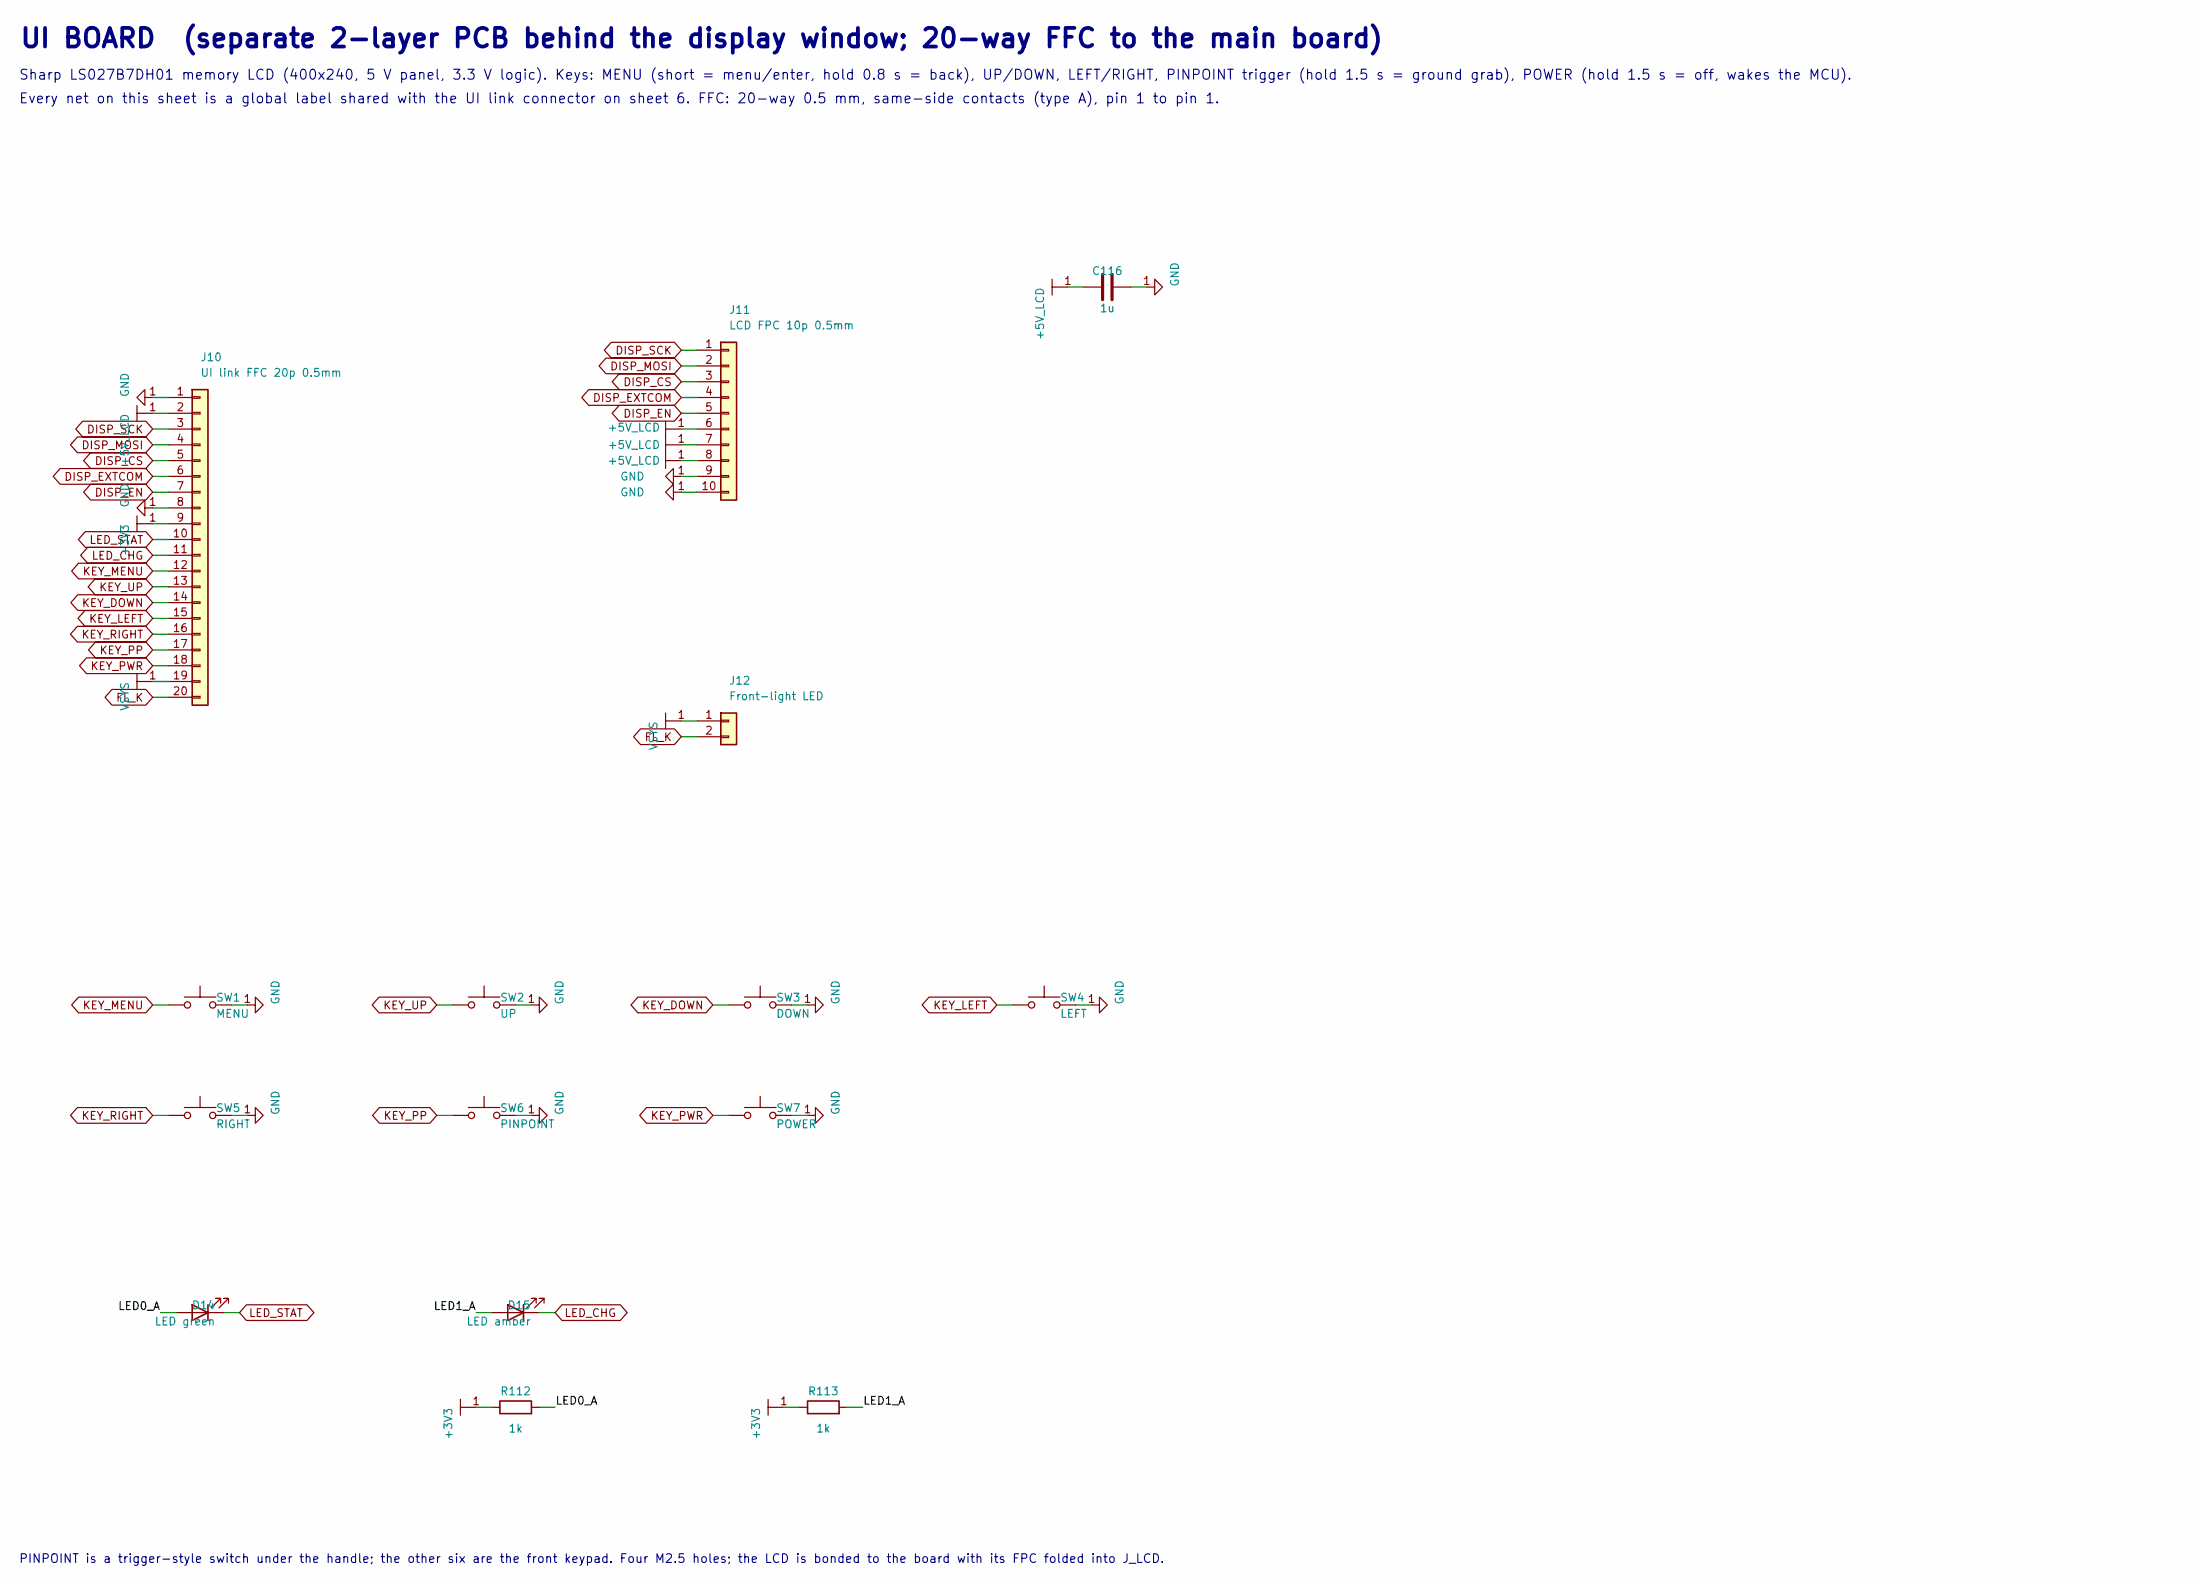
[picture p26: schematic ui_board.kicad_sch, UI board (separate PCB): memory LCD, 6-key pad + pinpoint +…]

Parts:
C116: 1u; C_0603_1608Metric
D14: LED green; LED_0603_1608Metric
D15: LED amber; LED_0603_1608Metric
J10: UI link FFC 20p 0.5mm; Hirose_FH12-20S-0.5SH_1x20-1MP_P0.50mm_Horizontal
J11: LCD FPC 10p 0.5mm; Hirose_FH12-10S-0.5SH_1x10-1MP_P0.50mm_Horizontal
J12: Front-light LED; JST_PH_B2B-PH-K_1x02_P2.00mm_Vertical
R112, R113: 1k; R_0402_1005Metric
SW1: MENU; SW_SPST_PTS645Sx43SMTR92
SW2: UP; SW_SPST_PTS645Sx43SMTR92
SW3: DOWN; SW_SPST_PTS645Sx43SMTR92
SW4: LEFT; SW_SPST_PTS645Sx43SMTR92
SW5: RIGHT; SW_SPST_PTS645Sx43SMTR92
SW6: PINPOINT; SW_SPST_PTS645Sx43SMTR92
SW7: POWER; SW_SPST_PTS645Sx43SMTR92

Connections:
unnamed: C116.1, J10.2, J11.6, J11.7, J11.8
unnamed: C116.2, J10.1, J10.8, J11.9, J11.10, SW1.2, SW2.2, SW3.2, SW4.2, SW5.2, SW6.2, SW7.2
unnamed: D14.1 (K), J10.10
unnamed: D14.2 (A), R112.2
unnamed: D15.1 (K), J10.11
unnamed: D15.2 (A), R113.2
unnamed: J10.3, J11.1
unnamed: J10.4, J11.2
unnamed: J10.5, J11.3
unnamed: J10.6, J11.4
unnamed: J10.7, J11.5
unnamed: J10.9, R112.1, R113.1
unnamed: J10.12, SW1.1
unnamed: J10.13, SW2.1
unnamed: J10.14, SW3.1
unnamed: J10.15, SW4.1
unnamed: J10.16, SW5.1
unnamed: J10.17, SW6.1
unnamed: J10.18, SW7.1
unnamed: J10.19, J12.1
unnamed: J10.20, J12.2

Notes on the sheet:
Sharp LS027B7DH01 memory LCD (400x240, 5 V panel, 3.3 V logic). Keys: MENU (short = menu/enter, hold 0.8 s = back), UP/DOWN, LEFT/RIGHT, PINPOINT trigger (hold 1.5 s = ground grab), POWER (hold 1.5 s = off, wakes the MCU).
PINPOINT is a trigger-style switch under the handle; the other six are the front keypad. Four M2.5 holes; the LCD is bonded to the board with its FPC folded into J_LCD.
UI BOARD (separate 2-layer PCB behind the display window; 20-way FFC to the main board)
Every net on this sheet is a global label shared with the UI link connector on sheet 6. FFC: 20-way 0.5 mm, same-side contacts (type A), pin 1 to pin 1.

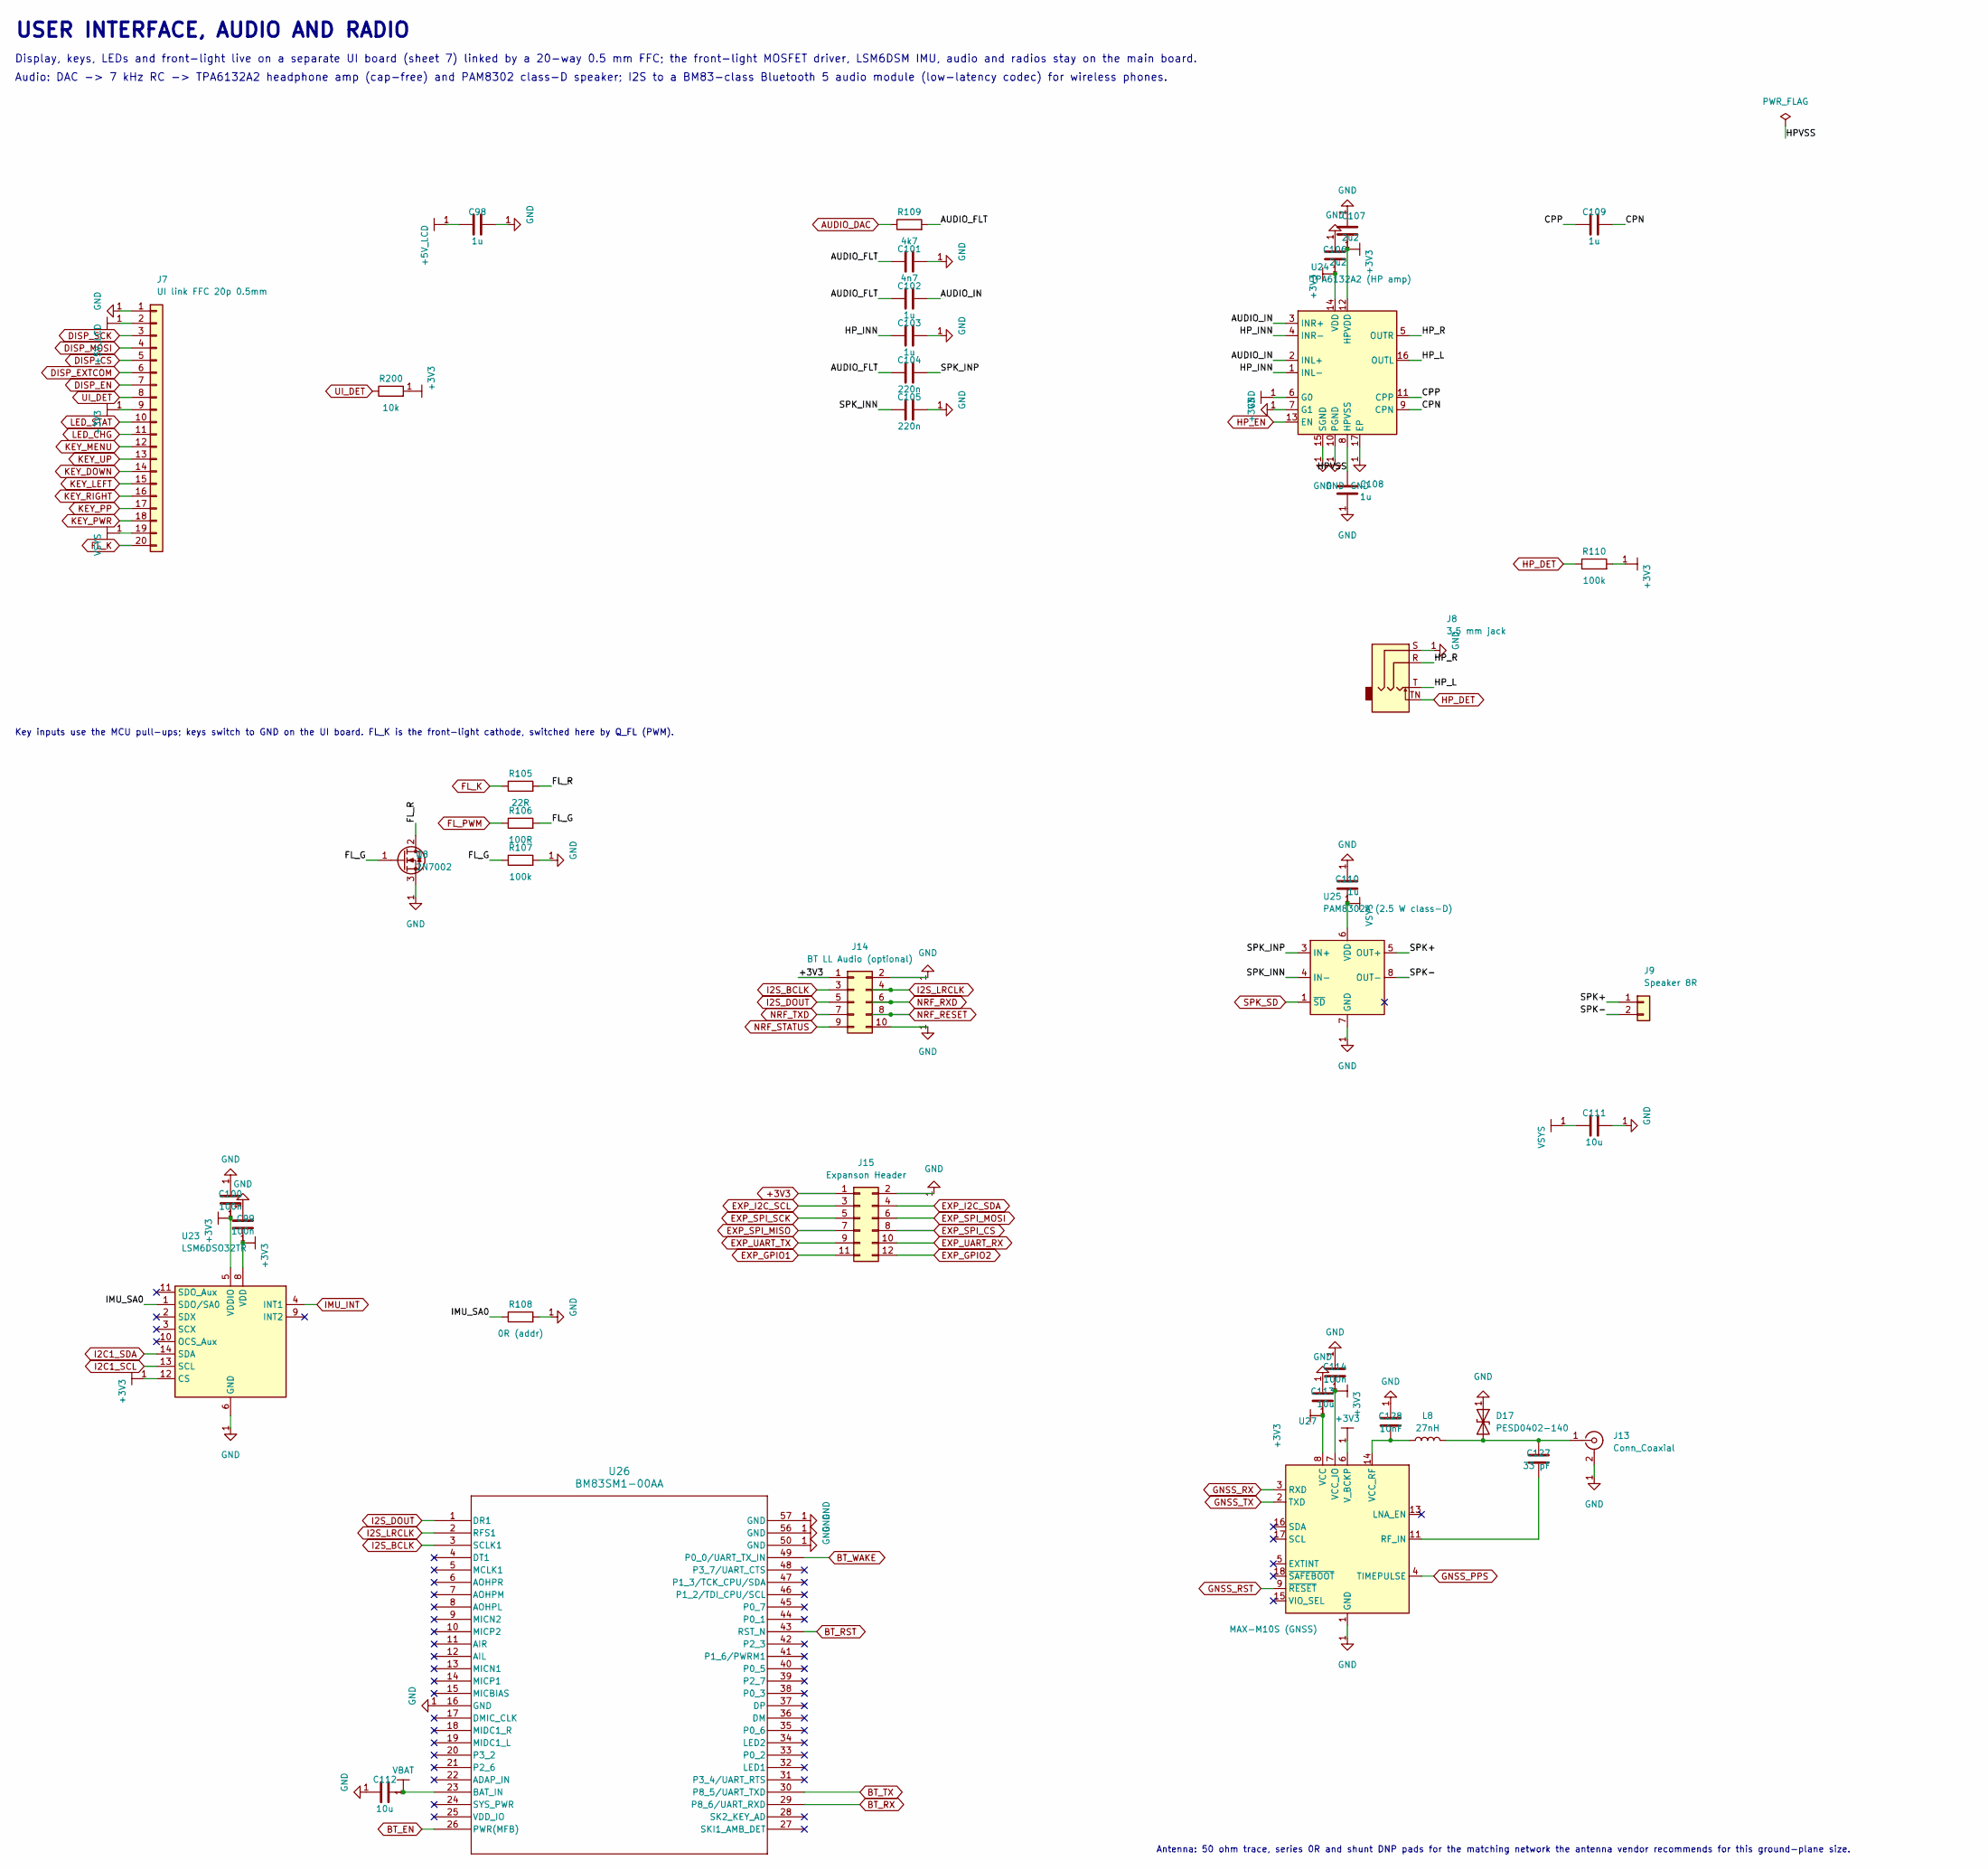
[picture p27: schematic ui_audio_rf.kicad_sch, UI, audio, wireless: memory LCD, keypad, IMU, headphone + s…]

Parts:
C98, C108, C109, C110: 1u; C_0603_1608Metric
C99, C100, C114: 100n; C_0402_1005Metric
C101: 4n7; C_0402_1005Metric
C102, C103: 1u; C_0402_1005Metric
C104, C105: 220n; C_0402_1005Metric
C106, C107: 2u2; C_0603_1608Metric
C111, C112, C113: 10u; C_0805_2012Metric
C127: 33 pF; C_0402_1005Metric
C128: 10nF; C_0402_1005Metric
D17: PESD0402-140; D_0402_1005Metric
J7: UI link FFC 20p 0.5mm; Hirose_FH12-20S-0.5SH_1x20-1MP_P0.50mm_Horizontal
J8: 3.5 mm jack; Jack_3.5mm_CUI_SJ-3523-SMT_Horizontal
J9: Speaker 8R; JST_PH_B2B-PH-K_1x02_P2.00mm_Vertical
J13: Conn_Coaxial; U.FL_Molex_MCRF_73412-0110_Vertical
J14: BT LL Audio (optional); Samtec_T1M-10-X-S-V_1x10-1MP_P1.0mm_Terminal_Vertical
J15: Expanson Header; Samtec_T1M-12-X-S-V_1x12-1MP_P1.0mm_Terminal_Vertical
L8: 27nH; L_0402_1005Metric
Q8: 2N7002; SOT-23
R105: 22R; R_0402_1005Metric
R106: 100R; R_0402_1005Metric
R107, R110: 100k; R_0402_1005Metric
R108: 0R (addr); R_0402_1005Metric
R109: 4k7; R_0402_1005Metric
R200: 10k; R_0402_1005Metric
U23: LSM6DSO32TR; LGA-14_3x2.5mm_P0.5mm_LayoutBorder3x4y
U24: TPA6132A2 (HP amp); Texas_RTE0016D_WQFN-16-1EP_3x3mm_P0.5mm_EP0.8x0.8mm_Thermal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
U25: PAM8302A (2.5 W class-D); MSOP-8-1EP_3x3mm_P0.65mm_EP1.68x1.88mm
U26: BM83SM1-00AA; BM83_MCH
U27: MAX-M10S (GNSS); ublox_MAX

Connections:
+3V3: C99.1, C100.1, C106.1, C107.1, C113.1, C114.1, J7.9, J14.1, J15.1, R110.2, R200.2, U23.5 (VDDIO), U23.8 (VDD), U23.12 (CS), U24.6 (G0), U24.12 (HPVDD), U24.14 (VDD), U27.6 (V_BCKP), U27.7 (VCC_IO), U27.8 (VCC); also elsewhere on the board
+5V_LCD: C98.1, J7.2; also elsewhere on the board
/UI, audio, wireless: memory LCD, keypad, IMU, headphone + speaker amps, Blueto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: C101.1, C102.1, C104.1, R109.2
/UI, audio, wireless: memory LCD, keypad, IMU, headphone + speaker amps, Blueto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: C102.2, U24.2 (INL+), U24.3 (INR+)
/UI, audio, wireless: memory LCD, keypad, IMU, headphone + speaker amps, Blueto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: C109.2, U24.9 (CPN)
/UI, audio, wireless: memory LCD, keypad, IMU, headphone + speaker amps, Blueto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: C109.1, U24.11 (CPP)
/UI, audio, wireless: memory LCD, keypad, IMU, headphone + speaker amps, Blueto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: Q8.1 (G), R106.2, R107.1
/UI, audio, wireless: memory LCD, keypad, IMU, headphone + speaker amps, Blueto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: Q8.2 (D), R105.2
/UI, audio, wireless: memory LCD, keypad, IMU, headphone + speaker amps, Blueto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: C108.1, U24.8 (HPVSS)
/UI, audio, wireless: memory LCD, keypad, IMU, headphone + speaker amps, Blueto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: C103.1, U24.1 (INL-), U24.4 (INR-)
/UI, audio, wireless: memory LCD, keypad, IMU, headphone + speaker amps, Blueto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: J8.T, U24.16 (OUTL)
/UI, audio, wireless: memory LCD, keypad, IMU, headphone + speaker amps, Blueto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: J8.R, U24.5 (OUTR)
/UI, audio, wireless: memory LCD, keypad, IMU, headphone + speaker amps, Blueto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: R108.1, U23.1 (SDO/SA0)
/UI, audio, wireless: memory LCD, keypad, IMU, headphone + speaker amps, Blueto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: J9.1, U25.5 (OUT+)
/UI, audio, wireless: memory LCD, keypad, IMU, headphone + speaker amps, Blueto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: J9.2, U25.8 (OUT-)
/UI, audio, wireless: memory LCD, keypad, IMU, headphone + speaker amps, Blueto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: C105.1, U25.4 (IN-)
/UI, audio, wireless: memory LCD, keypad, IMU, headphone + speaker amps, Blueto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: C104.2, U25.3 (IN+)
AUDIO_DAC: R109.1; also elsewhere on the board
BT_EN: U26.26 (PWR(MFB)); also elsewhere on the board
BT_RST: U26.43 (RST_N); also elsewhere on the board
BT_RX: U26.29 (P8_6/UART_RXD); also elsewhere on the board
BT_TX: U26.30 (P8_5/UART_TXD); also elsewhere on the board
BT_WAKE: U26.49 (P0_0/UART_TX_IN); also elsewhere on the board
DISP_CS: J7.5; also elsewhere on the board
DISP_EN: J7.7; also elsewhere on the board
DISP_EXTCOM: J7.6; also elsewhere on the board
DISP_MOSI: J7.4; also elsewhere on the board
DISP_SCK: J7.3; also elsewhere on the board
EXP_GPIO1: J15.11; also elsewhere on the board
EXP_GPIO2: J15.12; also elsewhere on the board
EXP_I2C_SCL: J15.3; also elsewhere on the board
EXP_I2C_SDA: J15.4; also elsewhere on the board
EXP_SPI_CS: J15.8; also elsewhere on the board
EXP_SPI_MISO: J15.7; also elsewhere on the board
EXP_SPI_MOSI: J15.6; also elsewhere on the board
EXP_SPI_SCK: J15.5; also elsewhere on the board
EXP_UART_RX: J15.10; also elsewhere on the board
EXP_UART_TX: J15.9; also elsewhere on the board
FL_K: J7.20, R105.1
FL_PWM: R106.1; also elsewhere on the board
GNSS_PPS: U27.4 (TIMEPULSE); also elsewhere on the board
GNSS_RST: U27.9 (~RESET); also elsewhere on the board
GNSS_RX: U27.3 (RXD); also elsewhere on the board
GNSS_TX: U27.2 (TXD); also elsewhere on the board
HP_DET: J8.TN, R110.1; also elsewhere on the board
HP_EN: U24.13 (EN); also elsewhere on the board
I2C1_SCL: U23.13 (SCL); also elsewhere on the board
I2C1_SDA: U23.14 (SDA); also elsewhere on the board
I2S_BCLK: J14.3, U26.3 (SCLK1); also elsewhere on the board
I2S_DOUT: J14.5, U26.1 (DR1); also elsewhere on the board
I2S_LRCLK: J14.4, U26.2 (RFS1); also elsewhere on the board
IMU_INT: U23.4 (INT1); also elsewhere on the board
KEY_DOWN: J7.14; also elsewhere on the board
KEY_LEFT: J7.15; also elsewhere on the board
KEY_MENU: J7.12; also elsewhere on the board
KEY_PP: J7.17; also elsewhere on the board
KEY_PWR: J7.18; also elsewhere on the board
KEY_RIGHT: J7.16; also elsewhere on the board
KEY_UP: J7.13; also elsewhere on the board
LED_CHG: J7.11; also elsewhere on the board
LED_STAT: J7.10; also elsewhere on the board
NRF_RESET: J14.8; also elsewhere on the board
NRF_RXD: J14.6; also elsewhere on the board
NRF_STATUS: J14.9; also elsewhere on the board
NRF_TXD: J14.7; also elsewhere on the board
unnamed: C127.2, D17.2 (A2), J13.1 (In), L8.2
unnamed: C127.1, U27.11 (RF_IN)
unnamed: C128.1, L8.1, U27.14 (VCC_RF)
SPK_SD: U25.1 (~SD); also elsewhere on the board
UI_DET: J7.8, R200.1; also elsewhere on the board
VBAT: C112.1, U26.23 (BAT_IN); also elsewhere on the board
VSYS: C110.1, C111.1, J7.19, U25.6 (VDD); also elsewhere on the board

Notes on the sheet:
Display, keys, LEDs and front-light live on a separate UI board (sheet 7) linked by a 20-way 0.5 mm FFC; the front-light MOSFET driver, LSM6DSM IMU, audio and radios stay on the main board.
Antenna: 50 ohm trace, series 0R and shunt DNP pads for the matching network the antenna vendor recommends for this ground-plane size.
Key inputs use the MCU pull-ups; keys switch to GND on the UI board. FL_K is the front-light cathode, switched here by Q_FL (PWM).
USER INTERFACE, AUDIO AND RADIO
Audio: DAC -> 7 kHz RC -> TPA6132A2 headphone amp (cap-free) and PAM8302 class-D speaker; I2S to a BM83-class Bluetooth 5 audio module (low-latency codec) for wireless phones.

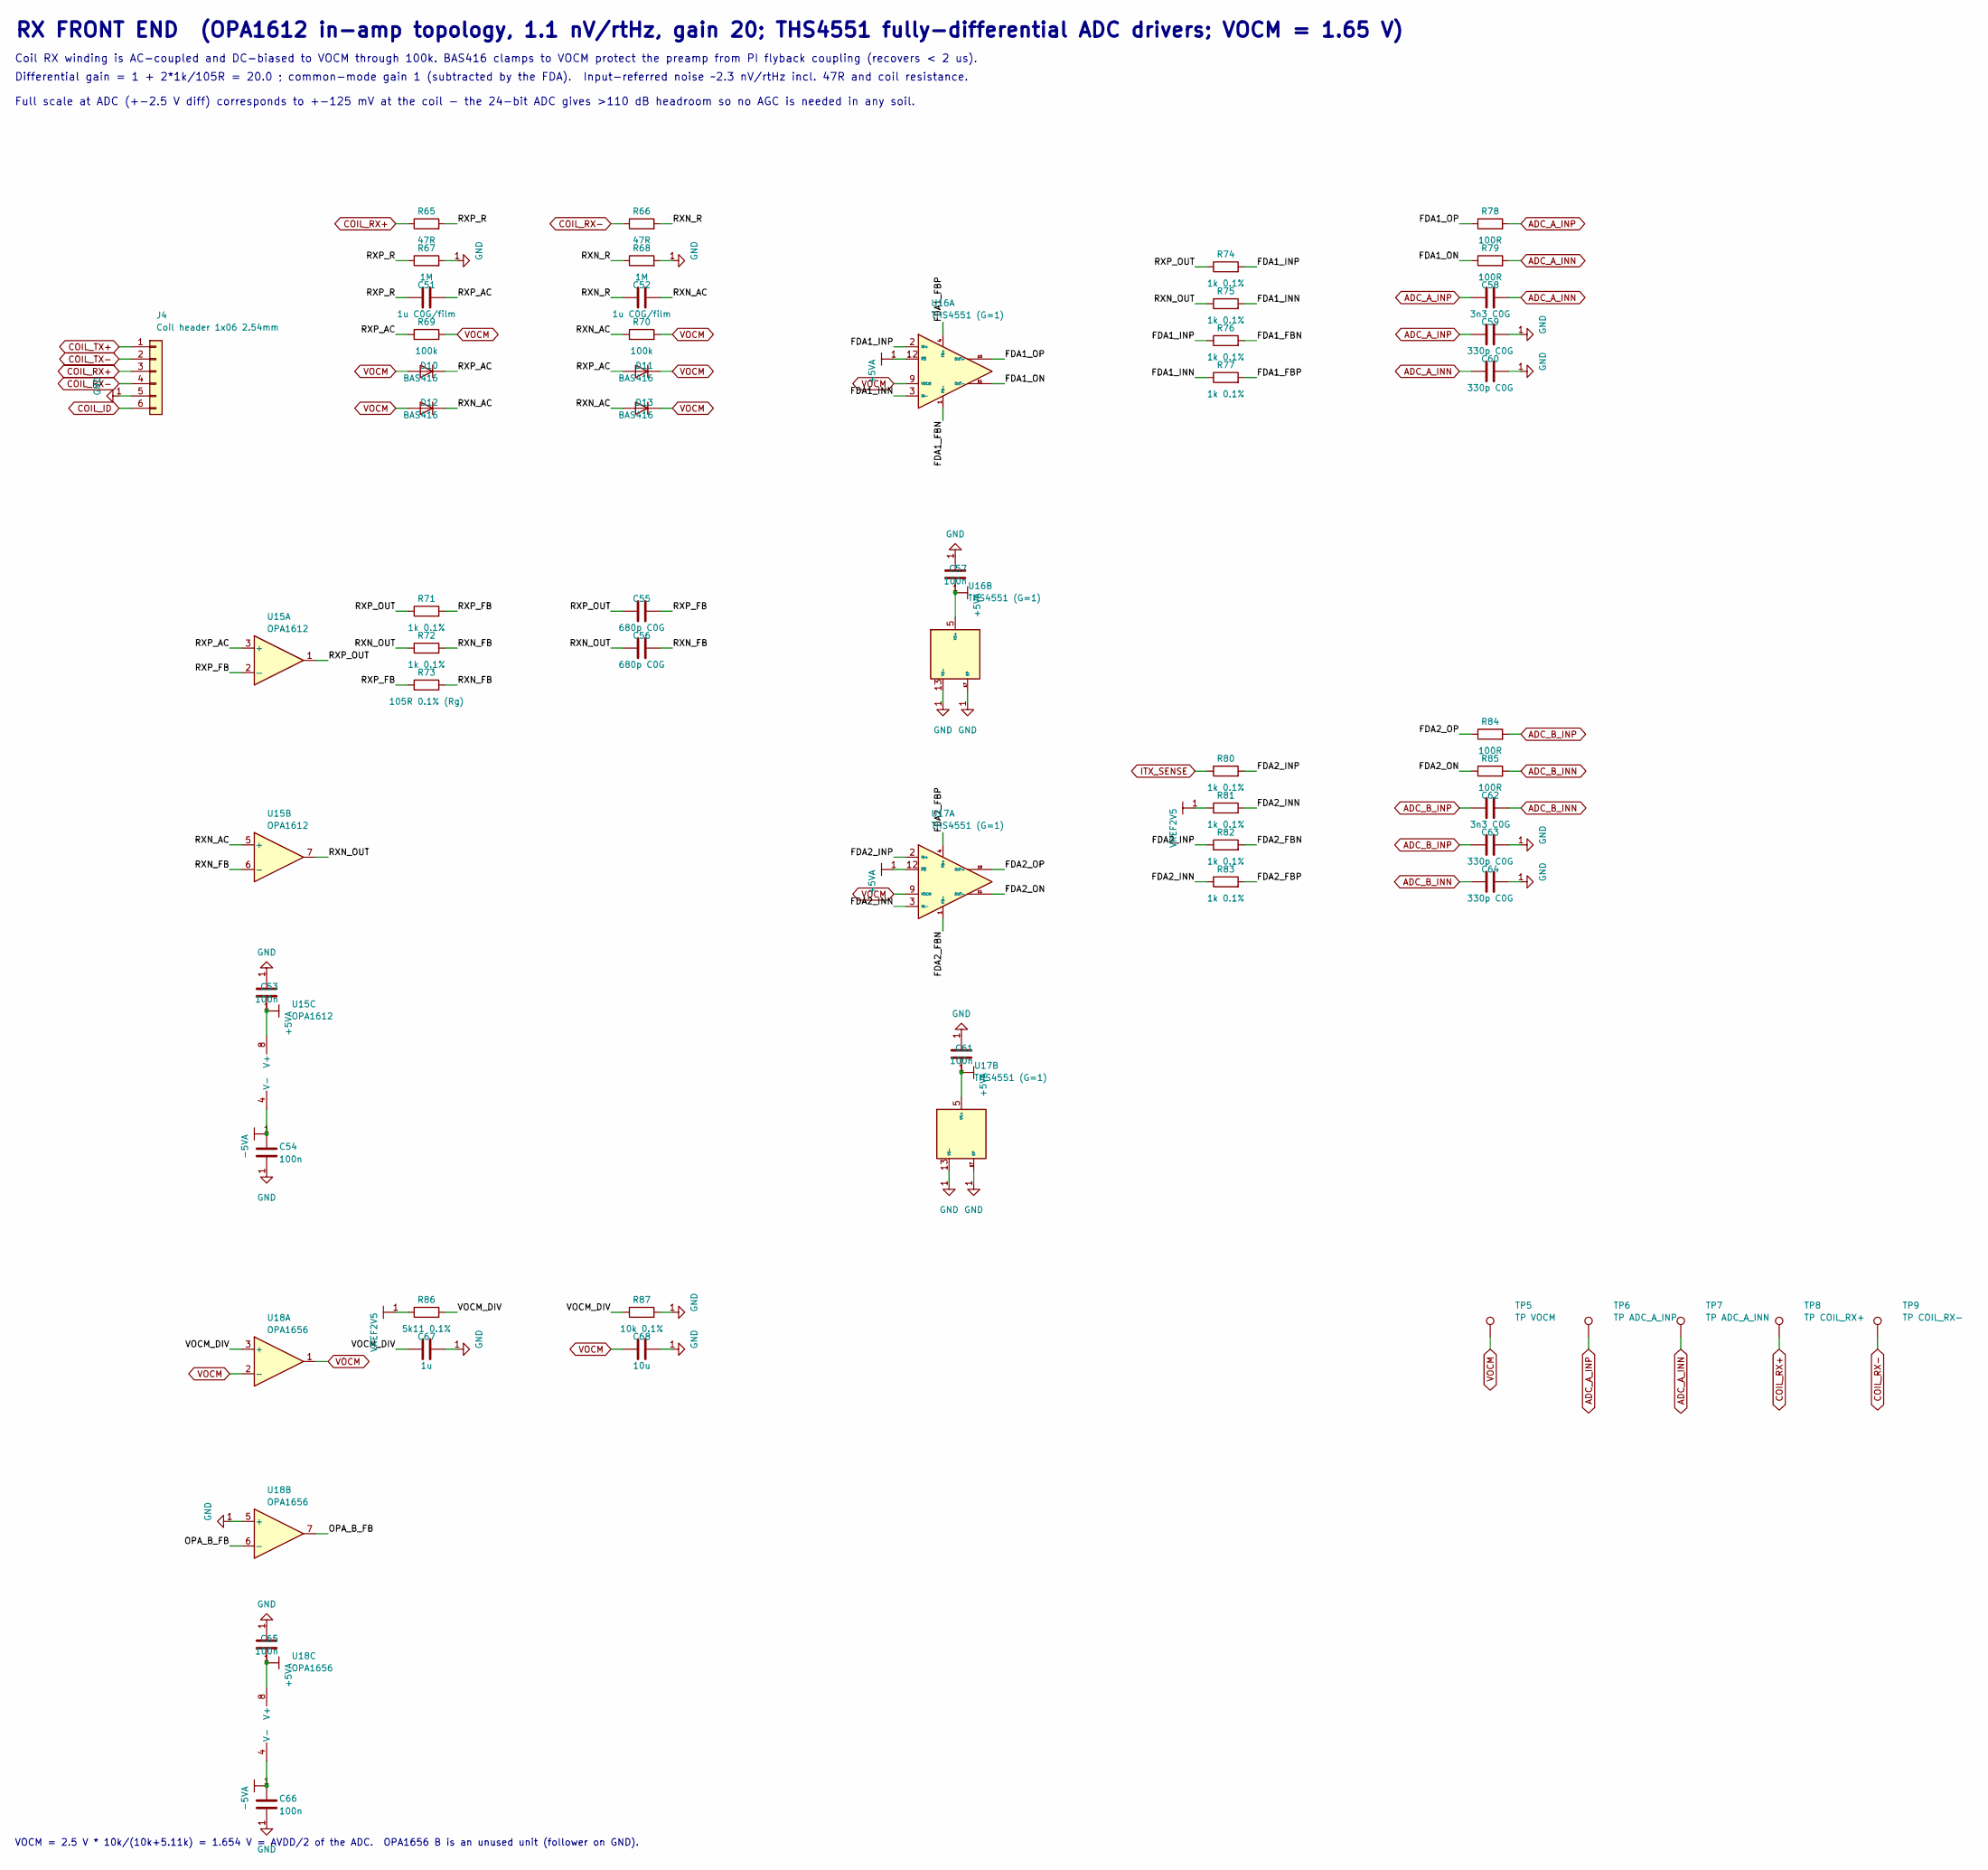
[picture p28: schematic rx_frontend.kicad_sch, RX front end: coil input protection, 20x differential pream…]

Parts:
C51, C52: 1u C0G/film; C_1210_3225Metric
C53, C54, C57, C61, C65, C66: 100n; C_0402_1005Metric
C55, C56: 680p C0G; C_0402_1005Metric
C58, C62: 3n3 C0G; C_0402_1005Metric
C59, C60, C63, C64: 330p C0G; C_0402_1005Metric
C67: 1u; C_0402_1005Metric
C68: 10u; C_0805_2012Metric
D10, D11, D12, D13: BAS416; SOT-23
J4: Coil header 1x06 2.54mm; PinHeader_1x06_P2.54mm_Vertical
R65, R66: 47R; R_0402_1005Metric
R67, R68: 1M; R_0402_1005Metric
R69, R70: 100k; R_0402_1005Metric
R71, R72, R74, R75, R76, R77, R80, R81, R82, R83: 1k 0.1%; R_0402_1005Metric
R73: 105R 0.1% (Rg); R_0402_1005Metric
R78, R79, R84, R85: 100R; R_0402_1005Metric
R86: 5k11 0.1%; R_0402_1005Metric
R87: 10k 0.1%; R_0402_1005Metric
TP5: TP VOCM; TestPoint_Pad_D1.5mm
TP6: TP ADC_A_INP; TestPoint_Pad_D1.5mm
TP7: TP ADC_A_INN; TestPoint_Pad_D1.5mm
TP8: TP COIL_RX+; TestPoint_Pad_D1.5mm
TP9: TP COIL_RX-; TestPoint_Pad_D1.5mm
U15: OPA1612
U16: THS4551 (G=1); VQFN-16-1EP_3x3mm_P0.5mm_EP1.68x1.68mm
U17: THS4551 (G=1)
U18: OPA1656

Connections:
+5VA: C53.1, C57.1, C61.1, C65.1, U15.8 (V+), U16.5 (VS+), U16.6 (VS+), U16.7 (VS+), U16.8 (VS+), U16.12 (~PD), U17.5 (VS+), U17.6 (VS+), U17.7 (VS+), U17.8 (VS+), U17.12 (~PD), U18.8 (V+); also elsewhere on the board
-5VA: C54.1, C66.1, U15.4 (V-), U18.4 (V-); also elsewhere on the board
/RX front end: coil input protection, 20x differential preamp, ADC drivers/FDA1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: R76.2, U16.1 (FB-)
/RX front end: coil input protection, 20x differential preamp, ADC drivers/FDA1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: R77.2, U16.4 (FB+)
/RX front end: coil input protection, 20x differential preamp, ADC drivers/FDA1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: R75.2, R77.1, U16.3 (IN-)
/RX front end: coil input protection, 20x differential preamp, ADC drivers/FDA1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: R74.2, R76.1, U16.2 (IN+)
/RX front end: coil input protection, 20x differential preamp, ADC drivers/FDA1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: R79.1, U16.11 (OUT-)
/RX front end: coil input protection, 20x differential preamp, ADC drivers/FDA1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: R78.1, U16.10 (OUT+)
/RX front end: coil input protection, 20x differential preamp, ADC drivers/FDA2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: R82.2, U17.1 (FB-)
/RX front end: coil input protection, 20x differential preamp, ADC drivers/FDA2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: R83.2, U17.4 (FB+)
/RX front end: coil input protection, 20x differential preamp, ADC drivers/FDA2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: R81.2, R83.1, U17.3 (IN-)
/RX front end: coil input protection, 20x differential preamp, ADC drivers/FDA2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: R80.2, R82.1, U17.2 (IN+)
/RX front end: coil input protection, 20x differential preamp, ADC drivers/FDA2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: R85.1, U17.11 (OUT-)
/RX front end: coil input protection, 20x differential preamp, ADC drivers/FDA2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: R84.1, U17.10 (OUT+)
/RX front end: coil input protection, 20x differential preamp, ADC drivers/OPA_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: U18.6 (-), U18.7
/RX front end: coil input protection, 20x differential preamp, ADC drivers/RXN_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: C52.2, D12.1 (K), D13.2 (A), R70.1, U15.5 (+)
/RX front end: coil input protection, 20x differential preamp, ADC drivers/RXN_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: C56.2, R72.2, R73.2, U15.6 (-)
/RX front end: coil input protection, 20x differential preamp, ADC drivers/RXN_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: C56.1, R72.1, R75.1, U15.7
/RX front end: coil input protection, 20x differential preamp, ADC drivers/RXN_R: C52.1, R66.2, R68.1
/RX front end: coil input protection, 20x differential preamp, ADC drivers/RXP_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: C51.2, D10.1 (K), D11.2 (A), R69.1, U15.3 (+)
/RX front end: coil input protection, 20x differential preamp, ADC drivers/RXP_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: C55.2, R71.2, R73.1, U15.2 (-)
/RX front end: coil input protection, 20x differential preamp, ADC drivers/RXP_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: C55.1, R71.1, R74.1, U15.1
/RX front end: coil input protection, 20x differential preamp, ADC drivers/RXP_R: C51.1, R65.2, R67.1
/RX front end: coil input protection, 20x differential preamp, ADC drivers/VOCM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: C67.1, R86.2, R87.1, U18.3 (+)
ADC_A_INN: C58.2, C60.1, R79.2, TP7.1 (1_1); also elsewhere on the board
ADC_A_INP: C58.1, C59.1, R78.2, TP6.1 (1_1); also elsewhere on the board
ADC_B_INN: C62.2, C64.1, R85.2; also elsewhere on the board
ADC_B_INP: C62.1, C63.1, R84.2; also elsewhere on the board
COIL_ID: J4.6; also elsewhere on the board
COIL_RX+: J4.3, R65.1, TP8.1 (1_1)
COIL_RX-: J4.4, R66.1, TP9.1 (1_1)
COIL_TX+: J4.1; also elsewhere on the board
COIL_TX-: J4.2; also elsewhere on the board
ITX_SENSE: R80.1; also elsewhere on the board
VOCM: C68.1, D10.2 (A), D11.1 (K), D12.2 (A), D13.1 (K), R69.2, R70.2, TP5.1 (1_1), U16.9 (VOCM), U17.9 (VOCM), U18.1, U18.2 (-)
VREF2V5: R81.1, R86.1; also elsewhere on the board

Notes on the sheet:
Coil RX winding is AC-coupled and DC-biased to VOCM through 100k. BAS416 clamps to VOCM protect the preamp from PI flyback coupling (recovers < 2 us).
VOCM = 2.5 V * 10k/(10k+5.11k) = 1.654 V = AVDD/2 of the ADC. OPA1656 B is an unused unit (follower on GND).
Full scale at ADC (+-2.5 V diff) corresponds to +-125 mV at the coil - the 24-bit ADC gives >110 dB headroom so no AGC is needed in any soil.
RX FRONT END (OPA1612 in-amp topology, 1.1 nV/rtHz, gain 20; THS4551 fully-differential ADC drivers; VOCM = 1.65 V)
Differential gain = 1 + 2*1k/105R = 20.0 ; common-mode gain 1 (subtracted by the FDA). Input-referred noise ~2.3 nV/rtHz incl. 47R and coil resistance.
