pingpongshow/MDX-1/hardware/mdx1/mdx1.kicad_pcb

## KiCad design hardware/mdx1/mdx1.kicad_pcb (continued)

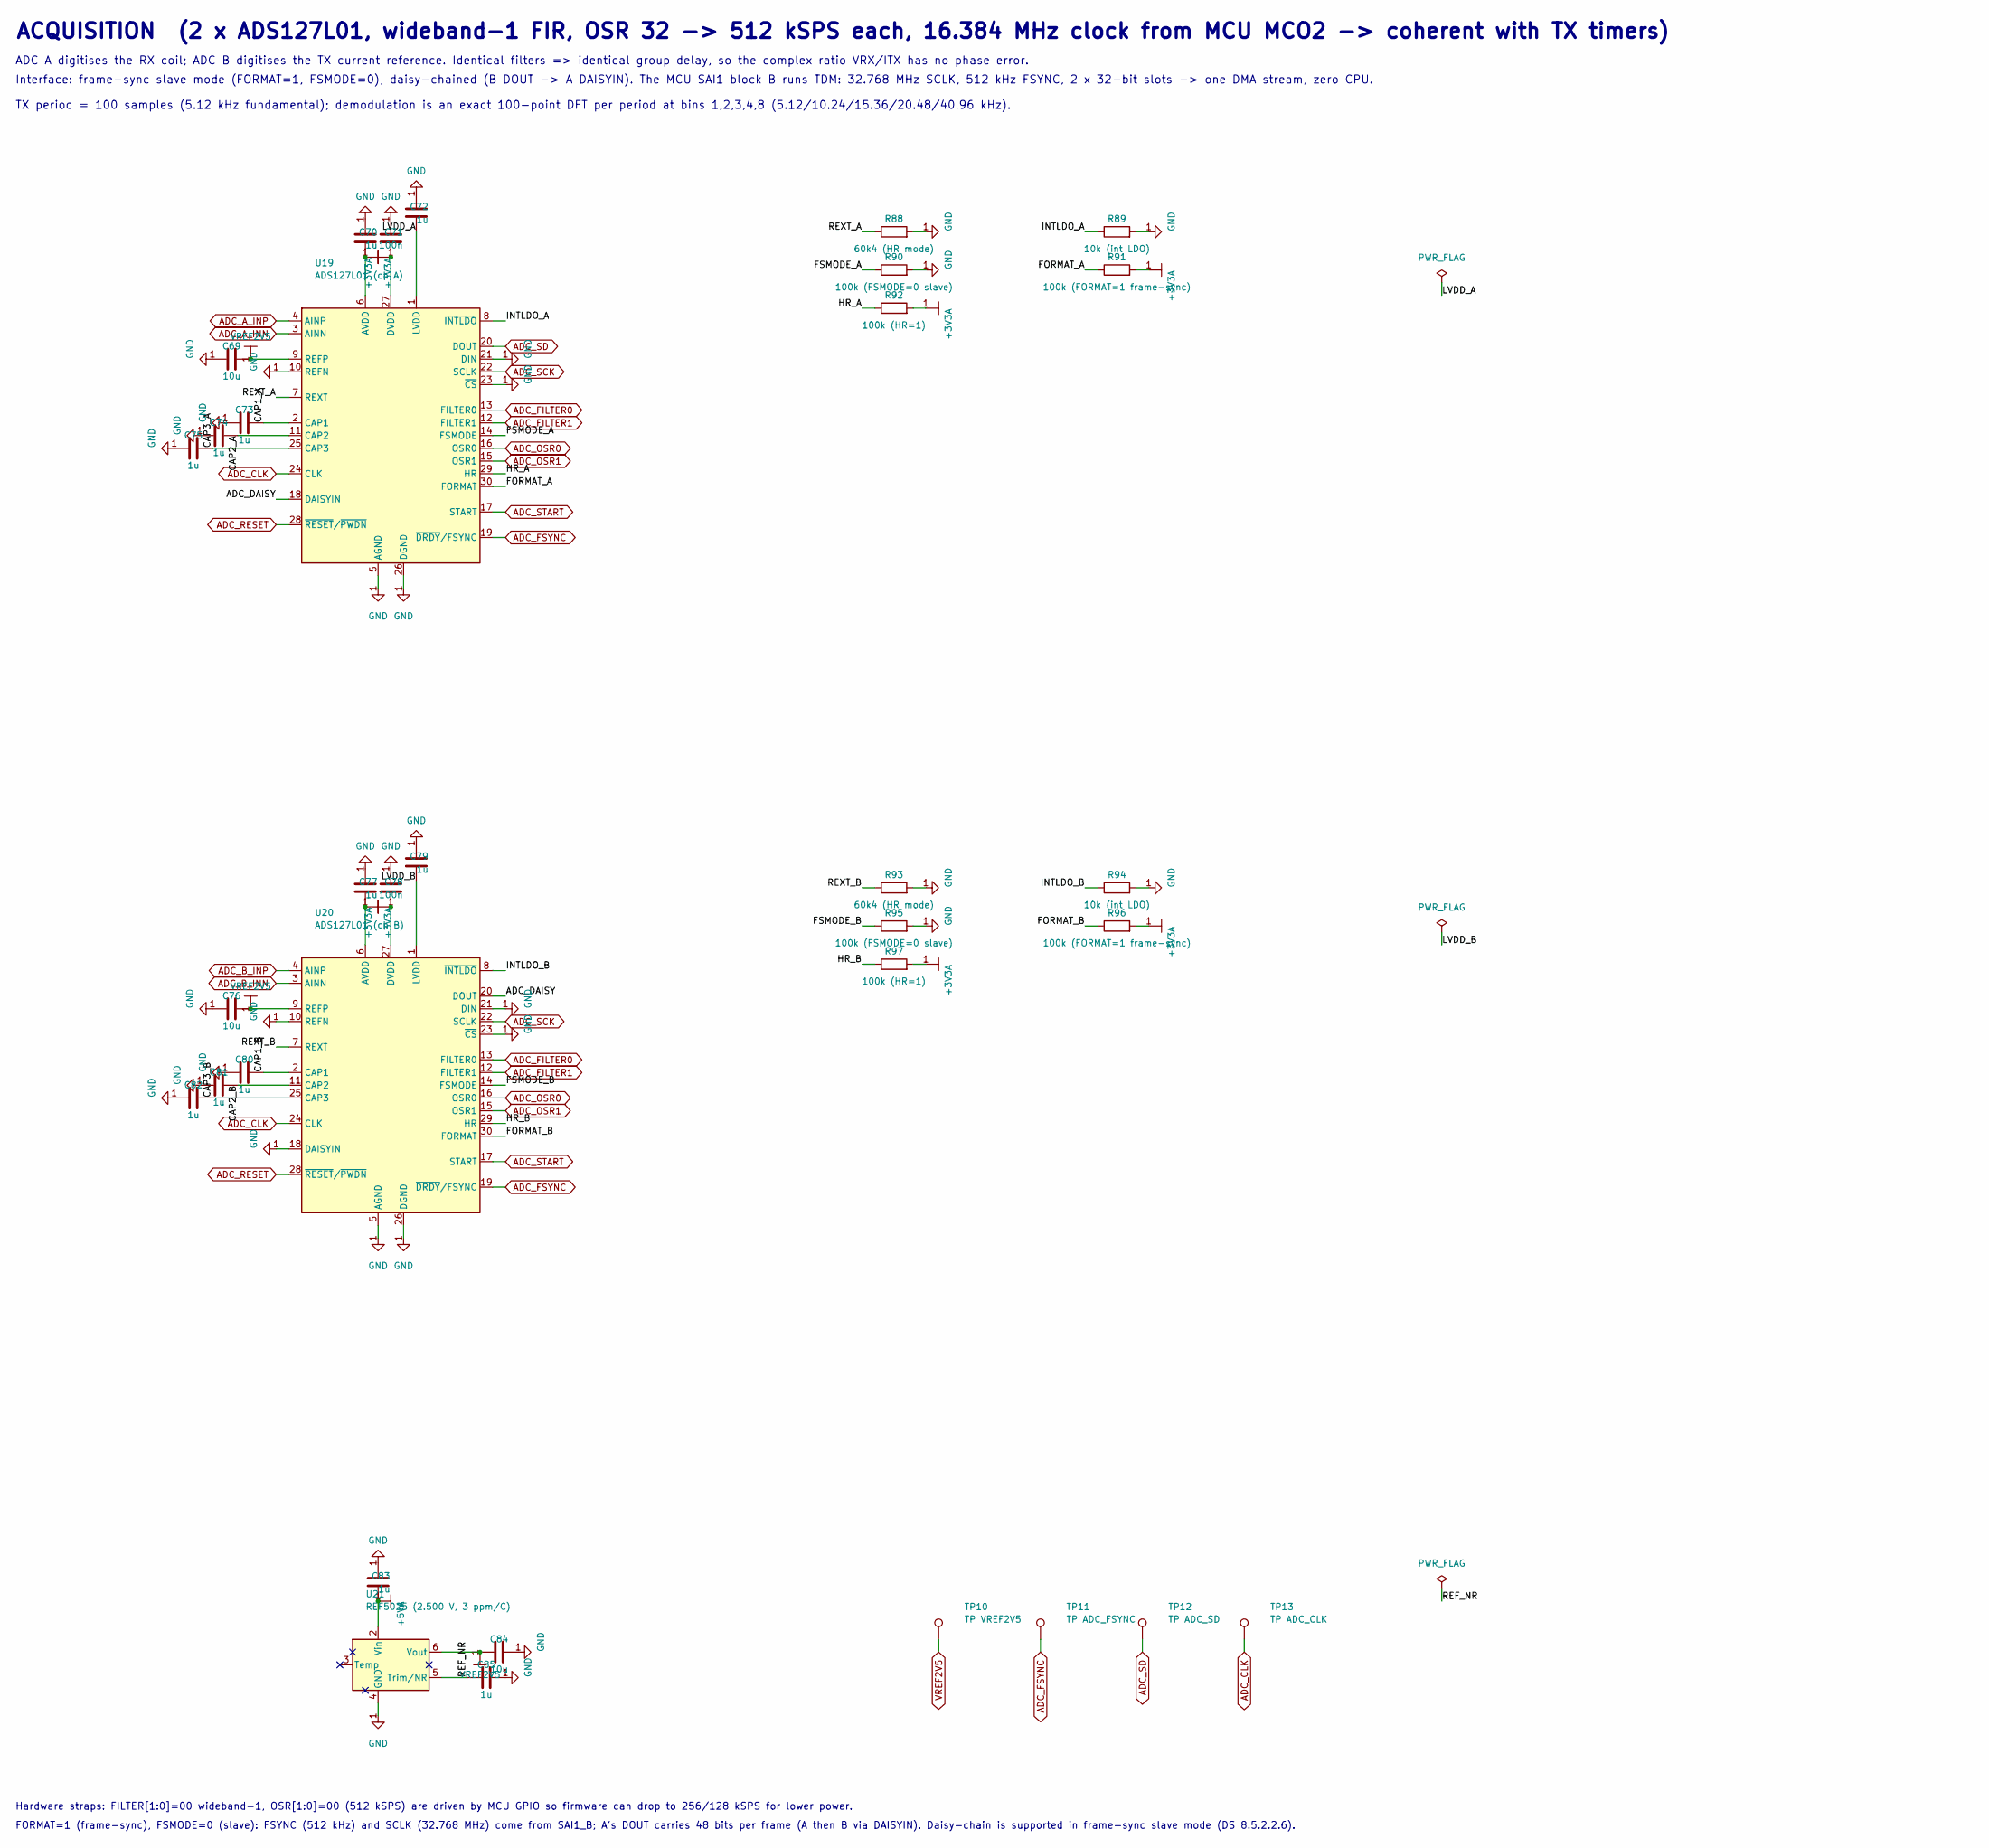
[picture p29: schematic adc.kicad_sch, ADC: 2x ADS127L01 24-bit 512 kSPS, 2.5 V reference]

Parts:
C69, C76, C84: 10u; C_0805_2012Metric
C70, C72, C73, C74, C75, C77, C79, C80, C81, C82, C83, C85: 1u; C_0603_1608Metric
C71, C78: 100n; C_0402_1005Metric
R88, R93: 60k4 (HR mode); R_0402_1005Metric
R89, R94: 10k (int LDO); R_0402_1005Metric
R90, R95: 100k (FSMODE=0 slave); R_0402_1005Metric
R91, R96: 100k (FORMAT=1 frame-sync); R_0402_1005Metric
R92, R97: 100k (HR=1); R_0402_1005Metric
TP10: TP VREF2V5; TestPoint_Pad_D1.5mm
TP11: TP ADC_FSYNC; TestPoint_Pad_D1.5mm
TP12: TP ADC_SD; TestPoint_Pad_D1.5mm
TP13: TP ADC_CLK; TestPoint_Pad_D1.5mm
U19: ADS127L01 (ch A); TQFP-32_5x5mm_P0.5mm
U20: ADS127L01 (ch B); TQFP-32_5x5mm_P0.5mm
U21: REF5025 (2.500 V, 3 ppm/C); SOIC-8_3.9x4.9mm_P1.27mm

Connections:
+3V3A: C70.1, C71.1, C77.1, C78.1, R91.2, R92.2, R96.2, R97.2, U19.6 (AVDD), U19.27 (DVDD), U19.32 (AVDD), U20.6 (AVDD), U20.27 (DVDD), U20.32 (AVDD); also elsewhere on the board
+5VA: C83.1, U21.2 (Vin); also elsewhere on the board
/ADC: 2x ADS127L01 24-bit 512 kSPS, 2.5 V reference/ADC_DAISY: U19.18 (DAISYIN), U20.20 (DOUT)
/ADC: 2x ADS127L01 24-bit 512 kSPS, 2.5 V reference/CAP1_A: C73.1, U19.2 (CAP1)
/ADC: 2x ADS127L01 24-bit 512 kSPS, 2.5 V reference/CAP1_B: C80.1, U20.2 (CAP1)
/ADC: 2x ADS127L01 24-bit 512 kSPS, 2.5 V reference/CAP2_A: C74.1, U19.11 (CAP2)
/ADC: 2x ADS127L01 24-bit 512 kSPS, 2.5 V reference/CAP2_B: C81.1, U20.11 (CAP2)
/ADC: 2x ADS127L01 24-bit 512 kSPS, 2.5 V reference/CAP3_A: C75.1, U19.25 (CAP3)
/ADC: 2x ADS127L01 24-bit 512 kSPS, 2.5 V reference/CAP3_B: C82.1, U20.25 (CAP3)
/ADC: 2x ADS127L01 24-bit 512 kSPS, 2.5 V reference/FORMAT_A: R91.1, U19.30 (FORMAT)
/ADC: 2x ADS127L01 24-bit 512 kSPS, 2.5 V reference/FORMAT_B: R96.1, U20.30 (FORMAT)
/ADC: 2x ADS127L01 24-bit 512 kSPS, 2.5 V reference/FSMODE_A: R90.1, U19.14 (FSMODE)
/ADC: 2x ADS127L01 24-bit 512 kSPS, 2.5 V reference/FSMODE_B: R95.1, U20.14 (FSMODE)
/ADC: 2x ADS127L01 24-bit 512 kSPS, 2.5 V reference/HR_A: R92.1, U19.29 (HR)
/ADC: 2x ADS127L01 24-bit 512 kSPS, 2.5 V reference/HR_B: R97.1, U20.29 (HR)
/ADC: 2x ADS127L01 24-bit 512 kSPS, 2.5 V reference/INTLDO_A: R89.1, U19.8 (~INTLDO)
/ADC: 2x ADS127L01 24-bit 512 kSPS, 2.5 V reference/INTLDO_B: R94.1, U20.8 (~INTLDO)
/ADC: 2x ADS127L01 24-bit 512 kSPS, 2.5 V reference/LVDD_A: C72.1, U19.1 (LVDD)
/ADC: 2x ADS127L01 24-bit 512 kSPS, 2.5 V reference/LVDD_B: C79.1, U20.1 (LVDD)
/ADC: 2x ADS127L01 24-bit 512 kSPS, 2.5 V reference/REF_NR: C85.1, U21.5 (Trim/NR)
/ADC: 2x ADS127L01 24-bit 512 kSPS, 2.5 V reference/REXT_A: R88.1, U19.7 (REXT)
/ADC: 2x ADS127L01 24-bit 512 kSPS, 2.5 V reference/REXT_B: R93.1, U20.7 (REXT)
ADC_A_INN: U19.3 (AINN); also elsewhere on the board
ADC_A_INP: U19.4 (AINP); also elsewhere on the board
ADC_B_INN: U20.3 (AINN); also elsewhere on the board
ADC_B_INP: U20.4 (AINP); also elsewhere on the board
ADC_CLK: TP13.1 (1_1), U19.24 (CLK), U20.24 (CLK); also elsewhere on the board
ADC_FILTER0: U19.13 (FILTER0), U20.13 (FILTER0); also elsewhere on the board
ADC_FILTER1: U19.12 (FILTER1), U20.12 (FILTER1); also elsewhere on the board
ADC_FSYNC: TP11.1 (1_1), U19.19 (~DRDY/FSYNC), U20.19 (~DRDY/FSYNC); also elsewhere on the board
ADC_OSR0: U19.16 (OSR0), U20.16 (OSR0); also elsewhere on the board
ADC_OSR1: U19.15 (OSR1), U20.15 (OSR1); also elsewhere on the board
ADC_RESET: U19.28 (~RESET/~PWDN), U20.28 (~RESET/~PWDN); also elsewhere on the board
ADC_SCK: U19.22 (SCLK), U20.22 (SCLK); also elsewhere on the board
ADC_SD: TP12.1 (1_1), U19.20 (DOUT); also elsewhere on the board
ADC_START: U19.17 (START), U20.17 (START); also elsewhere on the board
VREF2V5: C69.1, C76.1, C84.1, TP10.1 (1_1), U19.9 (REFP), U20.9 (REFP), U21.6 (Vout); also elsewhere on the board

Notes on the sheet:
ADC A digitises the RX coil; ADC B digitises the TX current reference. Identical filters => identical group delay, so the complex ratio VRX/ITX has no phase error.
Interface: frame-sync slave mode (FORMAT=1, FSMODE=0), daisy-chained (B DOUT -> A DAISYIN). The MCU SAI1 block B runs TDM: 32.768 MHz SCLK, 512 kHz FSYNC, 2 x 32-bit slots -> one DMA stream, zero CPU.
Hardware straps: FILTER[1:0]=00 wideband-1, OSR[1:0]=00 (512 kSPS) are driven by MCU GPIO so firmware can drop to 256/128 kSPS for lower power.
TX period = 100 samples (5.12 kHz fundamental); demodulation is an exact 100-point DFT per period at bins 1,2,3,4,8 (5.12/10.24/15.36/20.48/40.96 kHz).
ACQUISITION (2 x ADS127L01, wideband-1 FIR, OSR 32 -> 512 kSPS each, 16.384 MHz clock from MCU MCO2 -> coherent with TX timers)
FORMAT=1 (frame-sync), FSMODE=0 (slave): FSYNC (512 kHz) and SCLK (32.768 MHz) come from SAI1_B; A's DOUT carries 48 bits per frame (A then B via DAISYIN). Daisy-chain is supported in frame-sync slave mode (DS 8.5.2.2.6).

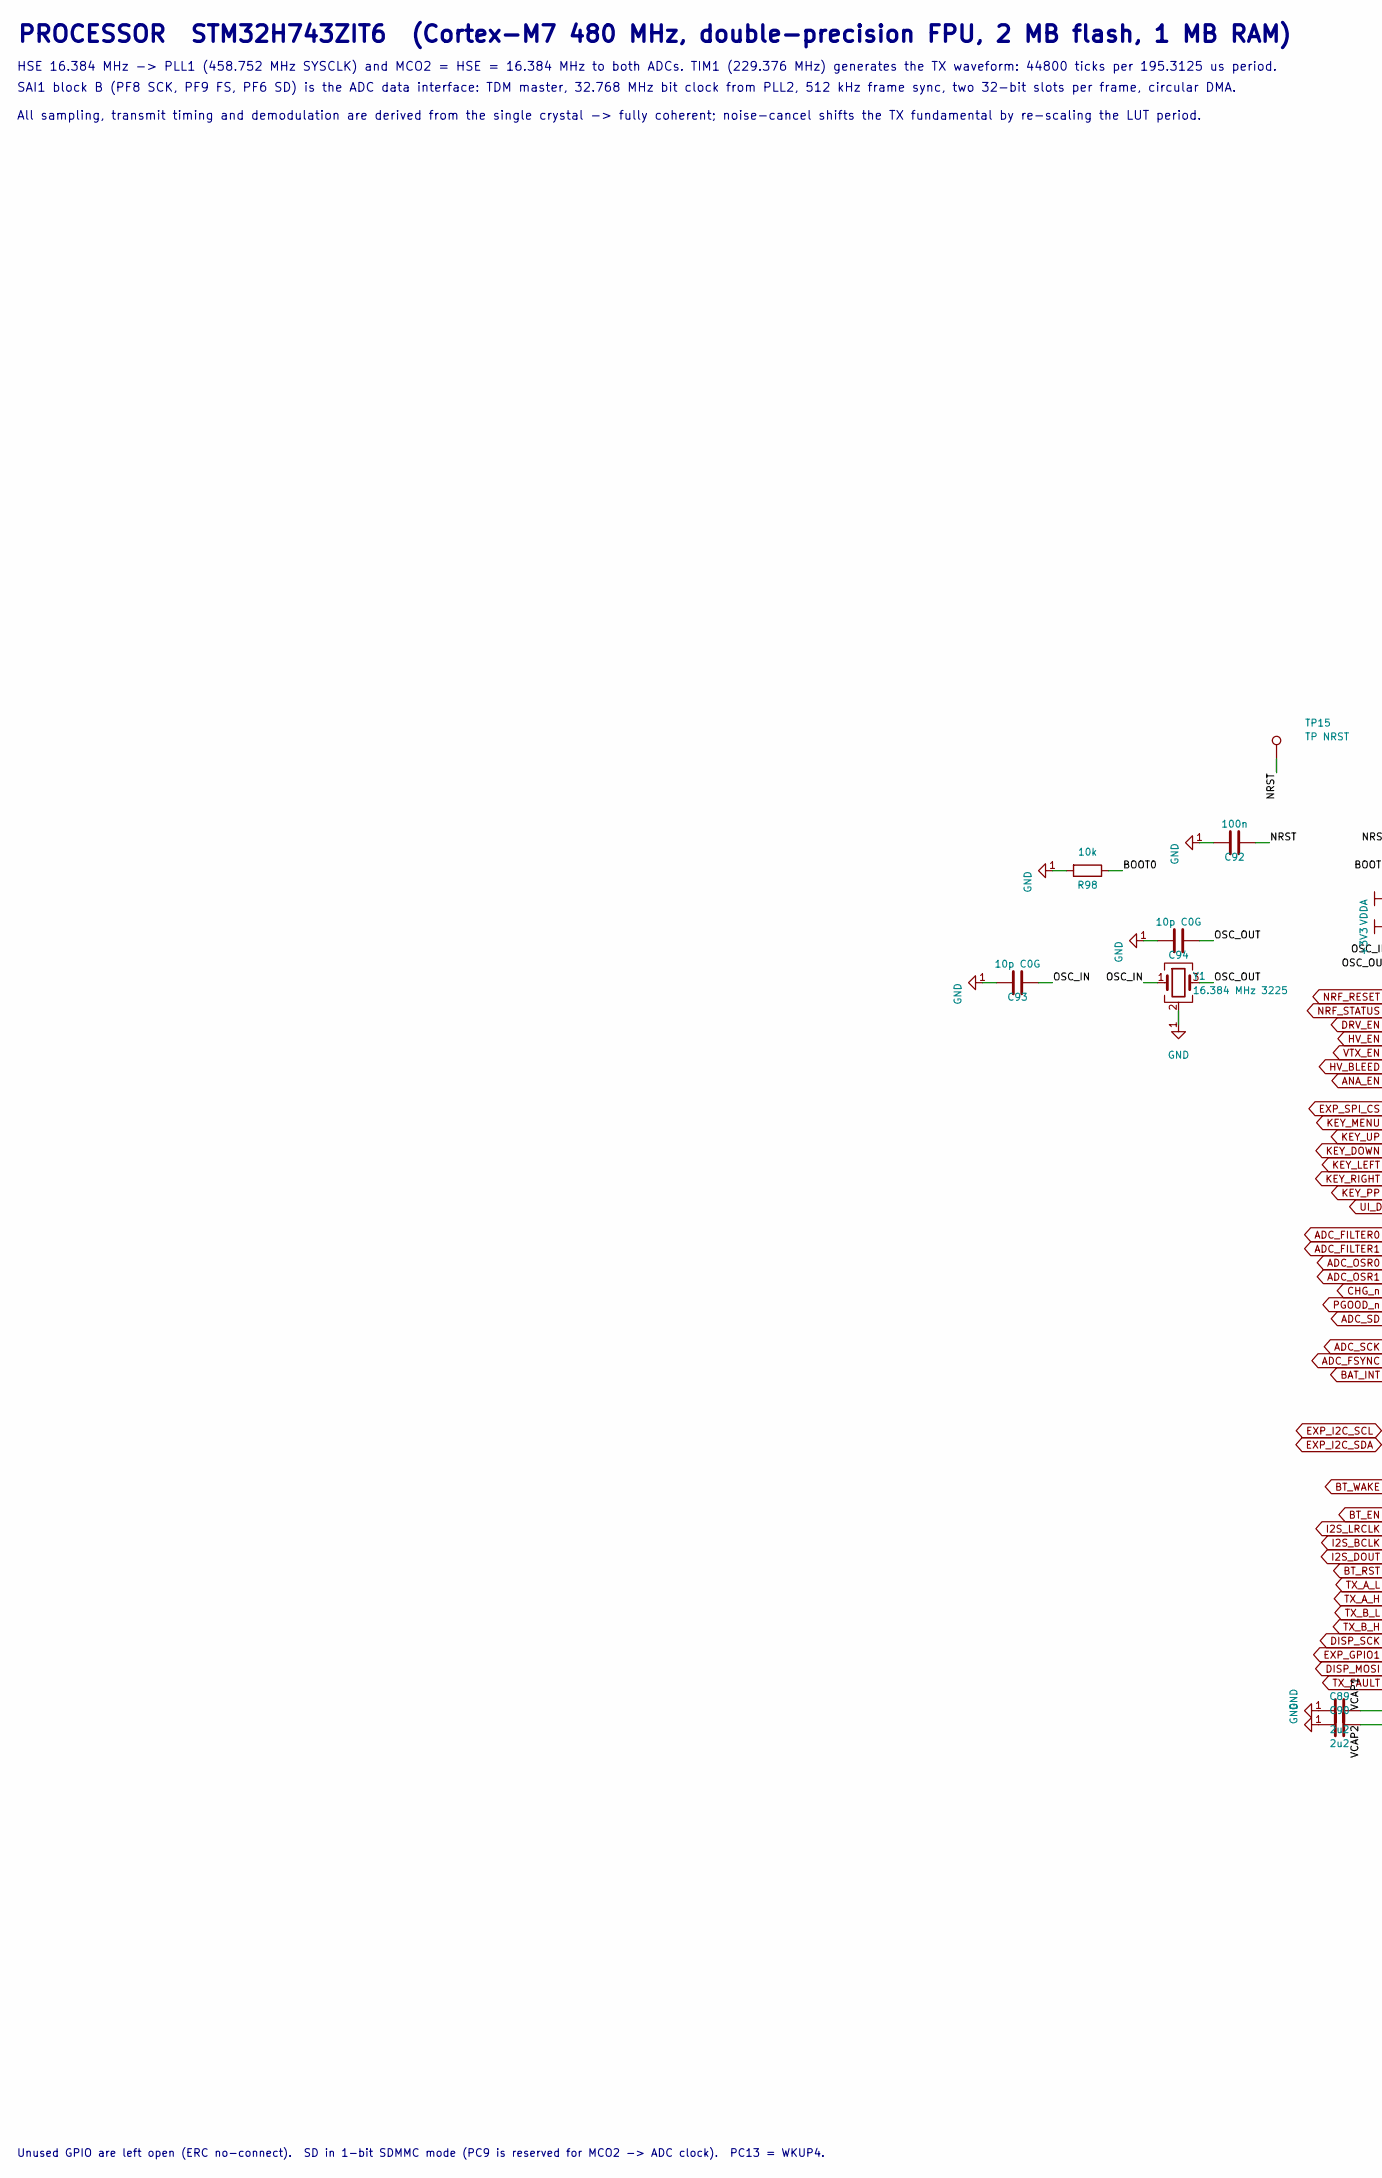
[picture p30: schematic mcu.kicad_sch, MCU: STM32H743ZI, clocks, debug, storage, part in row 1, column 1]

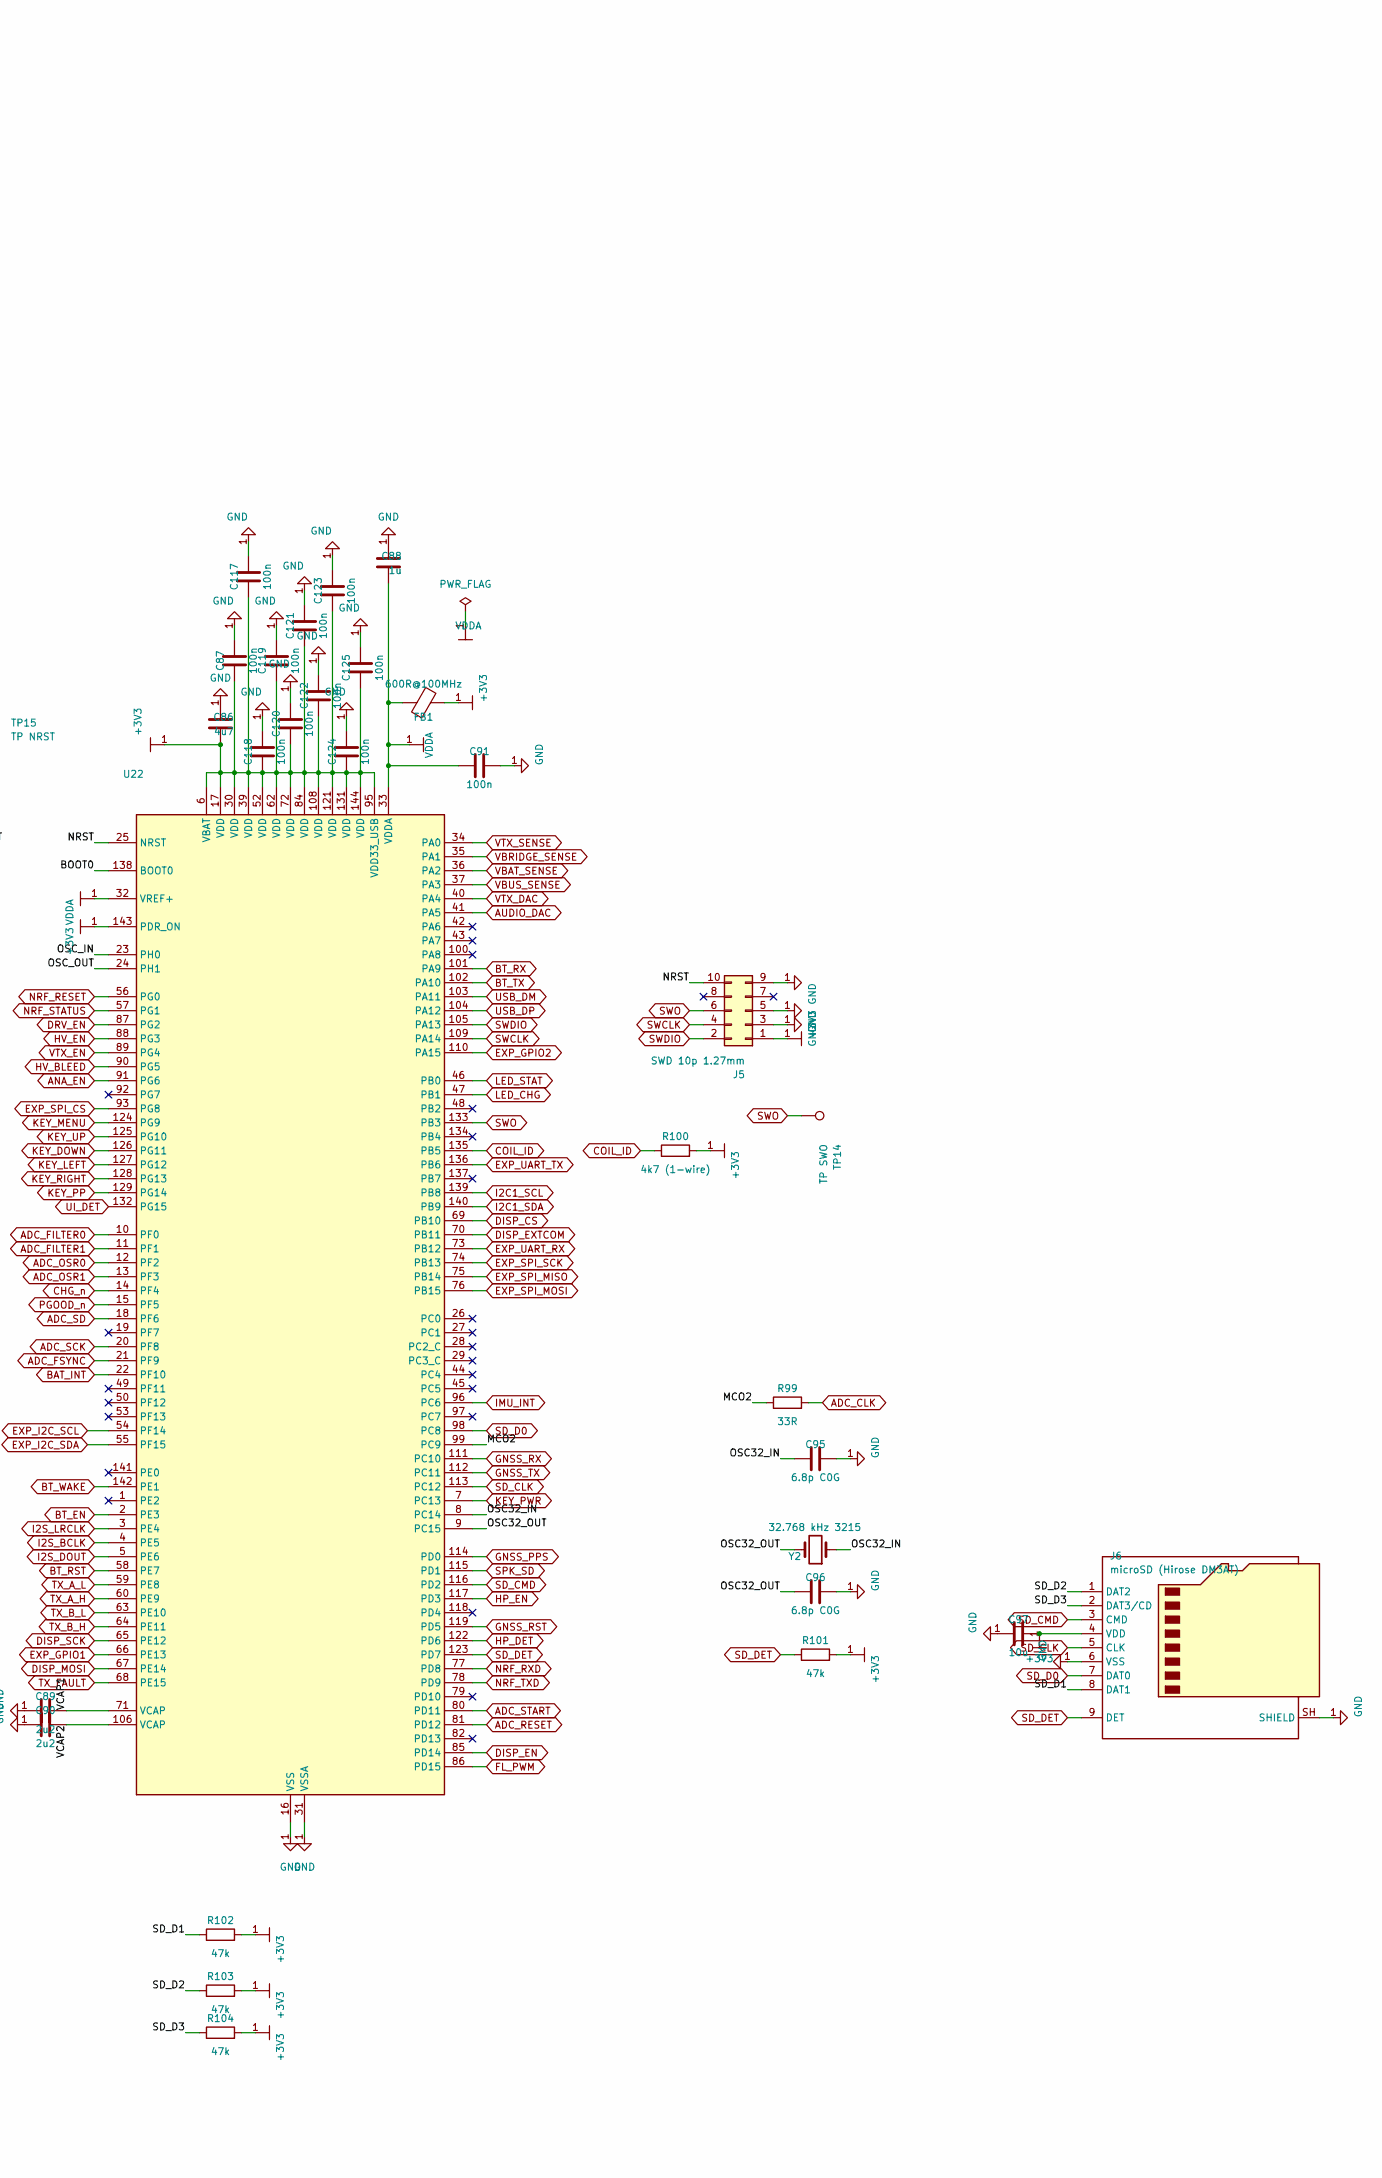
[picture p31: schematic mcu.kicad_sch, MCU: STM32H743ZI, clocks, debug, storage, part in row 1, column 2]

Parts:
C86: 4u7; C_0603_1608Metric
C87, C91, C92, C117, C118, C119, C120, C121, C122, C123, C124, C125: 100n; C_0402_1005Metric
C88: 1u; C_0603_1608Metric
C89, C90: 2u2; C_0603_1608Metric
C93, C94: 10p C0G; C_0402_1005Metric
C95, C96: 6.8p C0G; C_0402_1005Metric
C97: 10u; C_0805_2012Metric
FB1: 600R@100MHz; L_0603_1608Metric
J5: SWD 10p 1.27mm; PinHeader_2x05_P1.27mm_Vertical
J6: microSD (Hirose DM3AT); microSD_HC_Hirose_DM3AT-SF-PEJM5
R98: 10k; R_0402_1005Metric
R99: 33R; R_0402_1005Metric
R100: 4k7 (1-wire); R_0402_1005Metric
R101, R102, R103, R104: 47k; R_0402_1005Metric
TP14: TP SWO; TestPoint_Pad_D1.5mm
TP15: TP NRST; TestPoint_Pad_D1.5mm
U22: STM32H743ZIT6; LQFP-144_20x20mm_P0.5mm
Y1: 16.384 MHz 3225; Crystal_SMD_3225-4Pin_3.2x2.5mm
Y2: 32.768 kHz 3215; Crystal_SMD_3215-2Pin_3.2x1.5mm

Connections:
+3V3: C86.1, C87.1, C97.1, C117.1, C118.1, C119.1, C120.1, C121.1, C122.1, C123.1, C124.1, C125.1, FB1.1, J5.1, J6.4 (VDD), R100.2, R101.2, R102.2, R103.2, R104.2, U22.6 (VBAT), U22.17 (VDD), U22.30 (VDD), U22.39 (VDD), U22.52 (VDD), U22.62 (VDD), U22.72 (VDD), U22.84 (VDD), U22.95 (VDD33_USB), U22.108 (VDD), U22.121 (VDD), U22.131 (VDD), U22.143 (PDR_ON), U22.144 (VDD); also elsewhere on the board
/MCU: STM32H743ZI, clocks, debug, storage/BOOT0: R98.1, U22.138 (BOOT0)
/MCU: STM32H743ZI, clocks, debug, storage/MCO2: R99.1, U22.99 (PC9)
/MCU: STM32H743ZI, clocks, debug, storage/NRST: C92.1, J5.10, TP15.1 (1_1), U22.25 (NRST)
/MCU: STM32H743ZI, clocks, debug, storage/OSC32_IN: C95.1, U22.8 (PC14), Y2.1
/MCU: STM32H743ZI, clocks, debug, storage/OSC32_OUT: C96.1, U22.9 (PC15), Y2.2
/MCU: STM32H743ZI, clocks, debug, storage/OSC_IN: C93.1, U22.23 (PH0), Y1.1
/MCU: STM32H743ZI, clocks, debug, storage/OSC_OUT: C94.1, U22.24 (PH1), Y1.3
/MCU: STM32H743ZI, clocks, debug, storage/SD_D1: J6.8 (DAT1), R102.1
/MCU: STM32H743ZI, clocks, debug, storage/SD_D2: J6.1 (DAT2), R103.1
/MCU: STM32H743ZI, clocks, debug, storage/SD_D3: J6.2 (DAT3/CD), R104.1
/MCU: STM32H743ZI, clocks, debug, storage/VCAP1: C89.1, U22.71 (VCAP)
/MCU: STM32H743ZI, clocks, debug, storage/VCAP2: C90.1, U22.106 (VCAP)
ADC_CLK: R99.2; also elsewhere on the board
ADC_FILTER0: U22.10 (PF0); also elsewhere on the board
ADC_FILTER1: U22.11 (PF1); also elsewhere on the board
ADC_FSYNC: U22.21 (PF9); also elsewhere on the board
ADC_OSR0: U22.12 (PF2); also elsewhere on the board
ADC_OSR1: U22.13 (PF3); also elsewhere on the board
ADC_RESET: U22.81 (PD12); also elsewhere on the board
ADC_SCK: U22.20 (PF8); also elsewhere on the board
ADC_SD: U22.18 (PF6); also elsewhere on the board
ADC_START: U22.80 (PD11); also elsewhere on the board
ANA_EN: U22.91 (PG6); also elsewhere on the board
AUDIO_DAC: U22.41 (PA5); also elsewhere on the board
BAT_INT: U22.22 (PF10); also elsewhere on the board
BT_EN: U22.2 (PE3); also elsewhere on the board
BT_RST: U22.58 (PE7); also elsewhere on the board
BT_RX: U22.101 (PA9); also elsewhere on the board
BT_TX: U22.102 (PA10); also elsewhere on the board
BT_WAKE: U22.142 (PE1); also elsewhere on the board
CHG_n: U22.14 (PF4); also elsewhere on the board
COIL_ID: R100.1, U22.135 (PB5); also elsewhere on the board
DISP_CS: U22.69 (PB10); also elsewhere on the board
DISP_EN: U22.85 (PD14); also elsewhere on the board
DISP_EXTCOM: U22.70 (PB11); also elsewhere on the board
DISP_MOSI: U22.67 (PE14); also elsewhere on the board
DISP_SCK: U22.65 (PE12); also elsewhere on the board
DRV_EN: U22.87 (PG2); also elsewhere on the board
EXP_GPIO1: U22.66 (PE13); also elsewhere on the board
EXP_GPIO2: U22.110 (PA15); also elsewhere on the board
EXP_I2C_SCL: U22.54 (PF14); also elsewhere on the board
EXP_I2C_SDA: U22.55 (PF15); also elsewhere on the board
EXP_SPI_CS: U22.93 (PG8); also elsewhere on the board
EXP_SPI_MISO: U22.75 (PB14); also elsewhere on the board
EXP_SPI_MOSI: U22.76 (PB15); also elsewhere on the board
EXP_SPI_SCK: U22.74 (PB13); also elsewhere on the board
EXP_UART_RX: U22.73 (PB12); also elsewhere on the board
EXP_UART_TX: U22.136 (PB6); also elsewhere on the board
FL_PWM: U22.86 (PD15); also elsewhere on the board
GNSS_PPS: U22.114 (PD0); also elsewhere on the board
GNSS_RST: U22.119 (PD5); also elsewhere on the board
GNSS_RX: U22.111 (PC10); also elsewhere on the board
GNSS_TX: U22.112 (PC11); also elsewhere on the board
HP_DET: U22.122 (PD6); also elsewhere on the board
HP_EN: U22.117 (PD3); also elsewhere on the board
HV_BLEED: U22.90 (PG5); also elsewhere on the board
HV_EN: U22.88 (PG3); also elsewhere on the board
I2C1_SCL: U22.139 (PB8); also elsewhere on the board
I2C1_SDA: U22.140 (PB9); also elsewhere on the board
I2S_BCLK: U22.4 (PE5); also elsewhere on the board
I2S_DOUT: U22.5 (PE6); also elsewhere on the board
I2S_LRCLK: U22.3 (PE4); also elsewhere on the board
IMU_INT: U22.96 (PC6); also elsewhere on the board
KEY_DOWN: U22.126 (PG11); also elsewhere on the board
KEY_LEFT: U22.127 (PG12); also elsewhere on the board
KEY_MENU: U22.124 (PG9); also elsewhere on the board
KEY_PP: U22.129 (PG14); also elsewhere on the board
KEY_PWR: U22.7 (PC13); also elsewhere on the board
KEY_RIGHT: U22.128 (PG13); also elsewhere on the board
KEY_UP: U22.125 (PG10); also elsewhere on the board
LED_CHG: U22.47 (PB1); also elsewhere on the board
LED_STAT: U22.46 (PB0); also elsewhere on the board
NRF_RESET: U22.56 (PG0); also elsewhere on the board
NRF_RXD: U22.77 (PD8); also elsewhere on the board
NRF_STATUS: U22.57 (PG1); also elsewhere on the board
NRF_TXD: U22.78 (PD9); also elsewhere on the board
PGOOD_n: U22.15 (PF5); also elsewhere on the board
SD_CLK: J6.5 (CLK), U22.113 (PC12)
SD_CMD: J6.3 (CMD), U22.116 (PD2)
SD_D0: J6.7 (DAT0), U22.98 (PC8)
SD_DET: J6.9 (DET), R101.1, U22.123 (PD7)
SPK_SD: U22.115 (PD1); also elsewhere on the board
SWCLK: J5.4, U22.109 (PA14)
SWDIO: J5.2, U22.105 (PA13)
SWO: J5.6, TP14.1 (1_1), U22.133 (PB3)
TX_A_H: U22.60 (PE9); also elsewhere on the board
TX_A_L: U22.59 (PE8); also elsewhere on the board
TX_B_H: U22.64 (PE11); also elsewhere on the board
TX_B_L: U22.63 (PE10); also elsewhere on the board
TX_FAULT: U22.68 (PE15); also elsewhere on the board
UI_DET: U22.132 (PG15); also elsewhere on the board
USB_DM: U22.103 (PA11); also elsewhere on the board
USB_DP: U22.104 (PA12); also elsewhere on the board
VBAT_SENSE: U22.36 (PA2); also elsewhere on the board
VBRIDGE_SENSE: U22.35 (PA1); also elsewhere on the board
VBUS_SENSE: U22.37 (PA3); also elsewhere on the board
VDDA: C88.1, C91.1, FB1.2, U22.32 (VREF+), U22.33 (VDDA)
VTX_DAC: U22.40 (PA4); also elsewhere on the board
VTX_EN: U22.89 (PG4); also elsewhere on the board
VTX_SENSE: U22.34 (PA0); also elsewhere on the board

Notes on the sheet:
SAI1 block B (PF8 SCK, PF9 FS, PF6 SD) is the ADC data interface: TDM master, 32.768 MHz bit clock from PLL2, 512 kHz frame sync, two 32-bit slots per frame, circular DMA.
All sampling, transmit timing and demodulation are derived from the single crystal -> fully coherent; noise-cancel shifts the TX fundamental by re-scaling the LUT period.
HSE 16.384 MHz -> PLL1 (458.752 MHz SYSCLK) and MCO2 = HSE = 16.384 MHz to both ADCs. TIM1 (229.376 MHz) generates the TX waveform: 44800 ticks per 195.3125 us period.
Unused GPIO are left open (ERC no-connect). SD in 1-bit SDMMC mode (PC9 is reserved for MCO2 -> ADC clock). PC13 = WKUP4.
PROCESSOR STM32H743ZIT6 (Cortex-M7 480 MHz, double-precision FPU, 2 MB flash, 1 MB RAM)
