pingpongshow/MDX-1/hardware/mdx1/mdx1.kicad_pcb

## KiCad design hardware/mdx1/mdx1.kicad_pcb (continued)

Schematic: power.kicad_sch, Power: charger, gauge, rails, TX boost converters

Parts:
C1, C27: 4u7 10V; C_0603_1608Metric
C2, C3, C6, C9, C26: 10u 10V; C_0805_2012Metric
C4, C10, C28: 100n; C_0402_1005Metric
C5, C24, C25: 1u; C_0603_1608Metric
C7, C8: 22u 6.3V; C_0805_2012Metric
C11, C34: 220n; C_0402_1005Metric
C12: 10n (CP); C_0402_1005Metric
C13: 4n7 (CN); C_0402_1005Metric
C14, C15, C16: 22u 25V; C_1210_3225Metric
C17: 1u 25V; C_0603_1608Metric
C18, C21: 4u7 25V; C_0805_2012Metric
C19, C22: 10u 25V; C_0805_2012Metric
C20, C23, C29, C35: 4u7; C_0603_1608Metric
C30: 4n7; C_0402_1005Metric
C31: 100u 50V; CP_Radial_D8.0mm_P3.50mm
C32: 10u 50V; C_1210_3225Metric
C33: 4u7 50V; C_1210_3225Metric
C36: 10n; C_0402_1005Metric
C37: 47u 160V; CP_Radial_D10.0mm_P5.00mm
C38, C39: 2u2 250V; C_2220_5750Metric
D1: SMAJ5.0A TVS; D_SMA
D2, D3: SS34; D_SMA
D4: B560C 60V 5A; D_SMC
D5: STPS2150 150V; D_SMA
J1: USB-C 16P; USB_C_Receptacle_HRO_TYPE-C-31-M-12
J2: USBLC6-2SC6 (USB ESD); SOT-23-6
J3: Battery JST-PH 3p; JST_PH_B3B-PH-K_1x03_P2.00mm_Vertical
L1: 1u5 XAL4020; L_Coilcraft_XAL4020-XXX
L2, L3: 4u7 XAL4020; L_Coilcraft_XAL4020-XXX
L4: 22u XAL7050; L_Coilcraft_XAL7050-XXX
L5: 47u XAL7050; L_Coilcraft_XAL7050-XXX
Q1: SiR680ADP-T1-UE3; PowerPAK_SO-8_Single
Q2: BSC190N15NS3 (150V); Infineon_PG-TDSON-8_6.15x5.15mm
Q3: BSS127S (600V); SOT-23
R1, R2: 5k1; R_0402_1005Metric
R3: 1k1 (IIN 1.4A); R_0402_1005Metric
R4: 887R (ICHG 1A); R_0402_1005Metric
R5: 47k (timer); R_0402_1005Metric
R6: 10k (TS, DNP w/ NTC); R_0402_1005Metric
R7, R8, R14, R15, R24, R46: 100k; R_0402_1005Metric
R9: 10m 1% (gauge); R_1206_3216Metric
R10, R11, R16, R19, R37: 10k; R_0402_1005Metric
R12, R13: 4k7; R_0402_1005Metric
R17, R36: 47k; R_0402_1005Metric
R18, R29, R39: 22k; R_0402_1005Metric
R20: 100R (VIN filter); R_0402_1005Metric
R21: 1M; R_0402_1005Metric
R22: 113k; R_0402_1005Metric
R23: 499k; R_0402_1005Metric
R25, R26: 49k9 0.1% SET (100uA); R_0402_1005Metric
R27: 10R (LCD supply); R_0402_1005Metric
R28: 41k2 (300kHz); R_0402_1005Metric
R30, R35: 442k; R_0402_1005Metric
R31: 40k2; R_0402_1005Metric
R32: 66k5; R_0402_1005Metric
R33: 20m (sense); R_1206_3216Metric
R34, R44: 10R; R_0402_1005Metric
R38: 140k (100kHz); R_0402_1005Metric
R40, R41: 619k; R_0402_1005Metric
R42: 20k0; R_0402_1005Metric
R43: 50m (sense); R_1206_3216Metric
R45: 10k 1W (bleed); R_2512_6332Metric
U1: BQ24075RGT; VQFN-16-1EP_3x3mm_P0.5mm_EP1.6x1.6mm
U2: BQ27441DRZT-G1A; Texas_S-PDSO-N12
U3: TPS63001 (3.3V); Texas_DRC0010J_ThermalVias
U4: TPS65131RGET; Texas_RGE0024H_VQFN-24-1EP_4x4mm_P0.5mm_EP2.7x2.7mm_Thermal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
U5: LT3045 (+5VA); MSOP-12-1EP_3x4.039mm_P0.65mm_EP1.651x2.845mm
U6: LT3094 (-5VA); MSOP-12-1EP_3x4.039mm_P0.65mm_EP1.651x2.845mm
U7: TPS7A2033 (+3V3A); SOT-23-5
U8: LT3757 (VTX 8-30V); MSOP-10-1EP_3x3mm_P0.5mm_EP1.68x1.88mm
U9: LT3757 (VBRIDGE 100V); MSOP-10-1EP_3x3mm_P0.5mm_EP1.68x1.88mm

Connections:
+3V3: C7.1, C8.1, R7.2, R8.2, R12.2, R13.2, U3.1 (VOUT), U3.10 (FB); also elsewhere on the board
+3V3A: C25.1, U7.5 (OUT); also elsewhere on the board
+5VA: C19.1, C24.1, R27.1, U5.10 (OUTS), U5.11 (OUT), U5.12 (OUT), U7.1 (IN), U7.3 (EN); also elsewhere on the board
+5V_LCD: C26.1, R27.2; also elsewhere on the board
+12V: C14.1, C15.1, C18.1, D2.1 (K), R21.1, U4.23 (VPOS), U5.1 (IN), U5.2 (IN), U5.3 (IN), U5.4 (EN/UV), U5.7 (PGFB); also elsewhere on the board
-5VA: C22.1, U6.10 (OUTS), U6.11 (OUT), U6.12 (OUT); also elsewhere on the board
-6V: C16.1, C17.1, C21.1, D3.2 (A), R23.2, U4.15 (VNEG), U6.1 (IN), U6.2 (IN), U6.3 (EN/UV), U6.5 (PGFB), U6.13 (IN)
/Power: charger, gauge, rails, TX boost converters/BAT_PACK+: C4.1, J3.1, R9.1, U2.6 (BAT), U2.8 (SRP)
/Power: charger, gauge, rails, TX boost converters/BAT_TS: J3.2, R6.1, U1.1 (TS)
/Power: charger, gauge, rails, TX boost converters/CC1: J1.A5 (CC1), R1.1
/Power: charger, gauge, rails, TX boost converters/CC2: J1.B5 (CC2), R2.1
/Power: charger, gauge, rails, TX boost converters/CHG_ILIM: R3.1, U1.12 (ILIM)
/Power: charger, gauge, rails, TX boost converters/CHG_ISET: R4.1, U1.16 (ISET)
/Power: charger, gauge, rails, TX boost converters/CHG_TMR: R5.1, U1.14 (TMR)
/Power: charger, gauge, rails, TX boost converters/CN_COMP: C13.1, U4.18 (CN)
/Power: charger, gauge, rails, TX boost converters/CP_COMP: C12.1, U4.21 (CP)
/Power: charger, gauge, rails, TX boost converters/FBN: R23.1, R24.1, U4.16 (FBN)
/Power: charger, gauge, rails, TX boost converters/FBP: R21.2, R22.1, U4.22 (FBP)
/Power: charger, gauge, rails, TX boost converters/GAUGE_BIN: R10.1, U2.10 (BIN)
/Power: charger, gauge, rails, TX boost converters/HV_BLEED_D: Q3.2 (D), R45.2
/Power: charger, gauge, rails, TX boost converters/HV_CS: Q2.3 (S), R43.1, U9.6 (SENSE)
/Power: charger, gauge, rails, TX boost converters/HV_FB: R41.2, R42.1, U9.2 (FBX)
/Power: charger, gauge, rails, TX boost converters/HV_FB_M: R40.2, R41.1
/Power: charger, gauge, rails, TX boost converters/HV_GATE: Q2.1 (G), R44.2
/Power: charger, gauge, rails, TX boost converters/HV_GATE_R: R44.1, U9.7 (GATE)
/Power: charger, gauge, rails, TX boost converters/HV_INTVCC: C35.1, U9.8 (INTVCC)
/Power: charger, gauge, rails, TX boost converters/HV_RT: R38.1, U9.4 (RT)
/Power: charger, gauge, rails, TX boost converters/HV_SS: C34.1, U9.3 (SS)
/Power: charger, gauge, rails, TX boost converters/HV_VC: R39.1, U9.1 (VC)
/Power: charger, gauge, rails, TX boost converters/HV_VC_C: C36.1, R39.2
/Power: charger, gauge, rails, TX boost converters/SET_5VA: C20.1, R25.1, U5.8 (SET)
/Power: charger, gauge, rails, TX boost converters/SET_N5VA: C23.1, R26.1, U6.8 (SET)
/Power: charger, gauge, rails, TX boost converters/SW3V3_A: L1.1, U3.4 (L1)
/Power: charger, gauge, rails, TX boost converters/SW3V3_B: L1.2, U3.2 (L2)
/Power: charger, gauge, rails, TX boost converters/SW_HV: D5.2 (A), L5.2, Q2.2 (D)
/Power: charger, gauge, rails, TX boost converters/SW_NEG: D3.1 (K), L3.1, U4.13 (OUTN), U4.14 (OUTN)
/Power: charger, gauge, rails, TX boost converters/SW_POS: D2.2 (A), L2.2, U4.1 (INP), U4.24 (INP)
/Power: charger, gauge, rails, TX boost converters/SW_VTX: D4.2 (A), L4.2, Q1.2 (D)
/Power: charger, gauge, rails, TX boost converters/USB_DM_C: J1.A7 (D-), J1.B7 (D-), J2.3 (I/O2)
/Power: charger, gauge, rails, TX boost converters/USB_DP_C: J1.A6 (D+), J1.B6 (D+), J2.1 (I/O1)
/Power: charger, gauge, rails, TX boost converters/VBAT_DIV: R14.2, R15.1, R16.1
/Power: charger, gauge, rails, TX boost converters/VBUS_DIV: R17.2, R18.1, R19.1
/Power: charger, gauge, rails, TX boost converters/VIN_65131: C10.1, R20.2, U4.4 (VIN)
/Power: charger, gauge, rails, TX boost converters/VREF_65131: C11.1, R24.2, U4.17 (VREF)
/Power: charger, gauge, rails, TX boost converters/VTX_CS: Q1.3 (S), R33.1, U8.6 (SENSE)
/Power: charger, gauge, rails, TX boost converters/VTX_DIV: R35.2, R36.1, R37.1
/Power: charger, gauge, rails, TX boost converters/VTX_FB: R30.2, R31.1, R32.1, U8.2 (FBX)
/Power: charger, gauge, rails, TX boost converters/VTX_GATE: Q1.1 (G), R34.2
/Power: charger, gauge, rails, TX boost converters/VTX_GATE_R: R34.1, U8.7 (GATE)
/Power: charger, gauge, rails, TX boost converters/VTX_INTVCC: C29.1, U8.8 (INTVCC)
/Power: charger, gauge, rails, TX boost converters/VTX_RT: R28.1, U8.4 (RT)
/Power: charger, gauge, rails, TX boost converters/VTX_SS: C28.1, U8.3 (SS)
/Power: charger, gauge, rails, TX boost converters/VTX_VC: R29.1, U8.1 (VC)
ANA_EN: U4.8 (ENP), U4.10 (ENN); also elsewhere on the board
BAT_INT: R11.1, U2.12 (GPOUT); also elsewhere on the board
CHG_n: R8.1, U1.9 (~CHG); also elsewhere on the board
GAUGE_VDD: C5.1, R11.2, U2.5 (V_{DD})
HV_BLEED: Q3.1 (G), R46.1; also elsewhere on the board
HV_EN: U9.9 (~SHDN/UVLO); also elsewhere on the board
I2C1_SCL: R13.1, U2.2 (SCL); also elsewhere on the board
I2C1_SDA: R12.1, U2.1 (SDA); also elsewhere on the board
PGOOD_n: R7.1, U1.7 (~PGOOD); also elsewhere on the board
USB_DM: J2.4 (I/O2); also elsewhere on the board
USB_DP: J2.6 (I/O1); also elsewhere on the board
VBAT: C3.1, R9.2, R14.1, U1.2 (BAT), U1.3 (BAT), U2.7 (SRN); also elsewhere on the board
VBAT_SENSE: R16.2; also elsewhere on the board
VBRIDGE: C37.1, C38.1, C39.1, D5.1 (K), R40.1, R45.1; also elsewhere on the board
VBUS: C1.1, D1.1 (A1), J1.A4 (VBUS), J1.A9 (VBUS), J1.B4 (VBUS), J1.B9 (VBUS), J2.5 (VBUS), R17.1, U1.5 (EN2), U1.13 (IN)
VBUS_SENSE: R19.2; also elsewhere on the board
VSYS: C2.1, C6.1, C9.1, C27.1, L2.1, L4.1, R20.1, U1.10 (OUT), U1.11 (OUT), U3.5 (VIN), U3.6 (EN), U3.7 (PS/SYNC), U3.8 (VINA), U4.5 (INN), U4.6 (INN), U8.10 (VIN); also elsewhere on the board
VTX: C31.1, C32.1, C33.1, D4.1 (K), L5.1, R30.1, R35.1, U9.10 (VIN)
VTX_DAC: R32.2; also elsewhere on the board
VTX_EN: U8.9 (~SHDN/UVLO); also elsewhere on the board
VTX_SENSE: R37.2; also elsewhere on the board

Notes on the sheet:
MDX-1 POWER TREE
1S Li-ion 21700 (5 Ah) -> BQ24075 power-path charger (USB-C 5 V) -> VSYS. VSYS -> TPS63001 buck-boost +3V3 (digital);
VTX = 1.6V*(1+442k/40.2k+442k/66.5k) - VDAC*(442k/66.5k) -> 29.8 V @ 0 V DAC, 7.9 V @ 3.3 V DAC. VBRIDGE = 1.6V*(1+1.238M/20k) = 100.6 V.
Capacitors drawn at a pin belong to that pin (PCB placement follows the schematic).
LT3757 #1: VSYS -> VTX programmable 8..30 V (DAC-steered feedback) = VLF transmit rail. LT3757 #2: VTX -> VBRIDGE 100 V for PI/ZVT mode (off in VLF: VBRIDGE = VTX - Vf).
+5V_LCD: the memory LCD is a 5 V panel (VDD 4.8-5.5 V, VIH 2.7 V min, so 3.3 V logic is fine); 10R/10u keeps its refresh current off the analog rail.
HV_BLEED: MCU discharges the 100 V bank (27 uF, 0.13 J) through 10k (1 W pulse rated) in ~1.4 s when leaving PI mode.
TPS65131 -> +12V (gate drivers, feeds LT3045 +5VA ultra-low-noise LDO) and -6V (feeds LT3094 -5VA LDO); TPS7A20 -> +3V3A (ADC/ref).

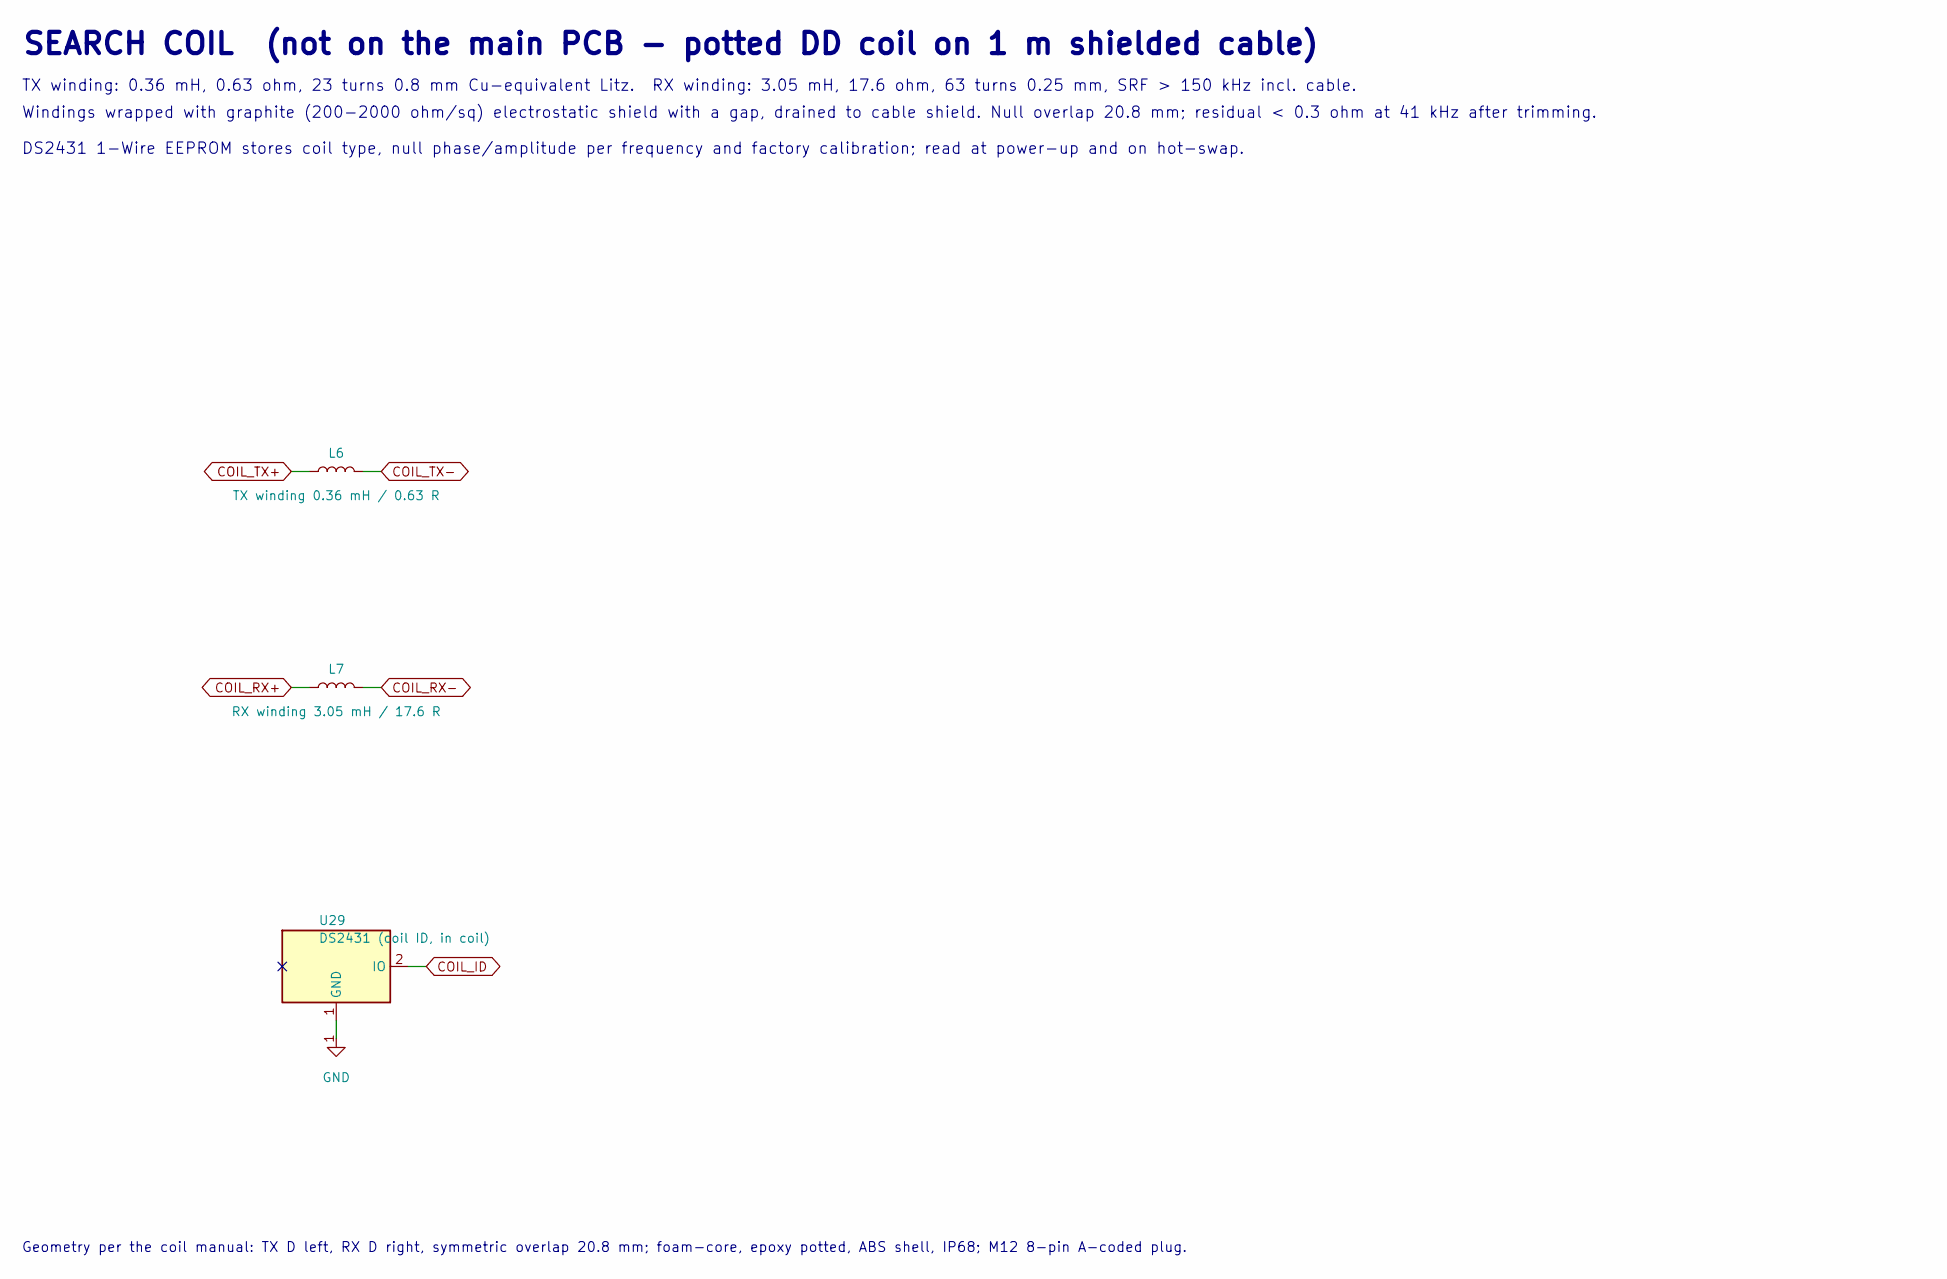
[picture p32: schematic coil.kicad_sch, Search coil assembly (DD 11 in): windings, shield, ID chip]

Parts:
L6: TX winding 0.36 mH / 0.63 R
L7: RX winding 3.05 mH / 17.6 R
U29: DS2431 (coil ID, in coil); SOT-23

Notes on the sheet:
Windings wrapped with graphite (200-2000 ohm/sq) electrostatic shield with a gap, drained to cable shield. Null overlap 20.8 mm; residual < 0.3 ohm at 41 kHz after trimming.
TX winding: 0.36 mH, 0.63 ohm, 23 turns 0.8 mm Cu-equivalent Litz. RX winding: 3.05 mH, 17.6 ohm, 63 turns 0.25 mm, SRF > 150 kHz incl. cable.
Geometry per the coil manual: TX D left, RX D right, symmetric overlap 20.8 mm; foam-core, epoxy potted, ABS shell, IP68; M12 8-pin A-coded plug.
SEARCH COIL (not on the main PCB - potted DD coil on 1 m shielded cable)
DS2431 1-Wire EEPROM stores coil type, null phase/amplitude per frequency and factory calibration; read at power-up and on hot-swap.

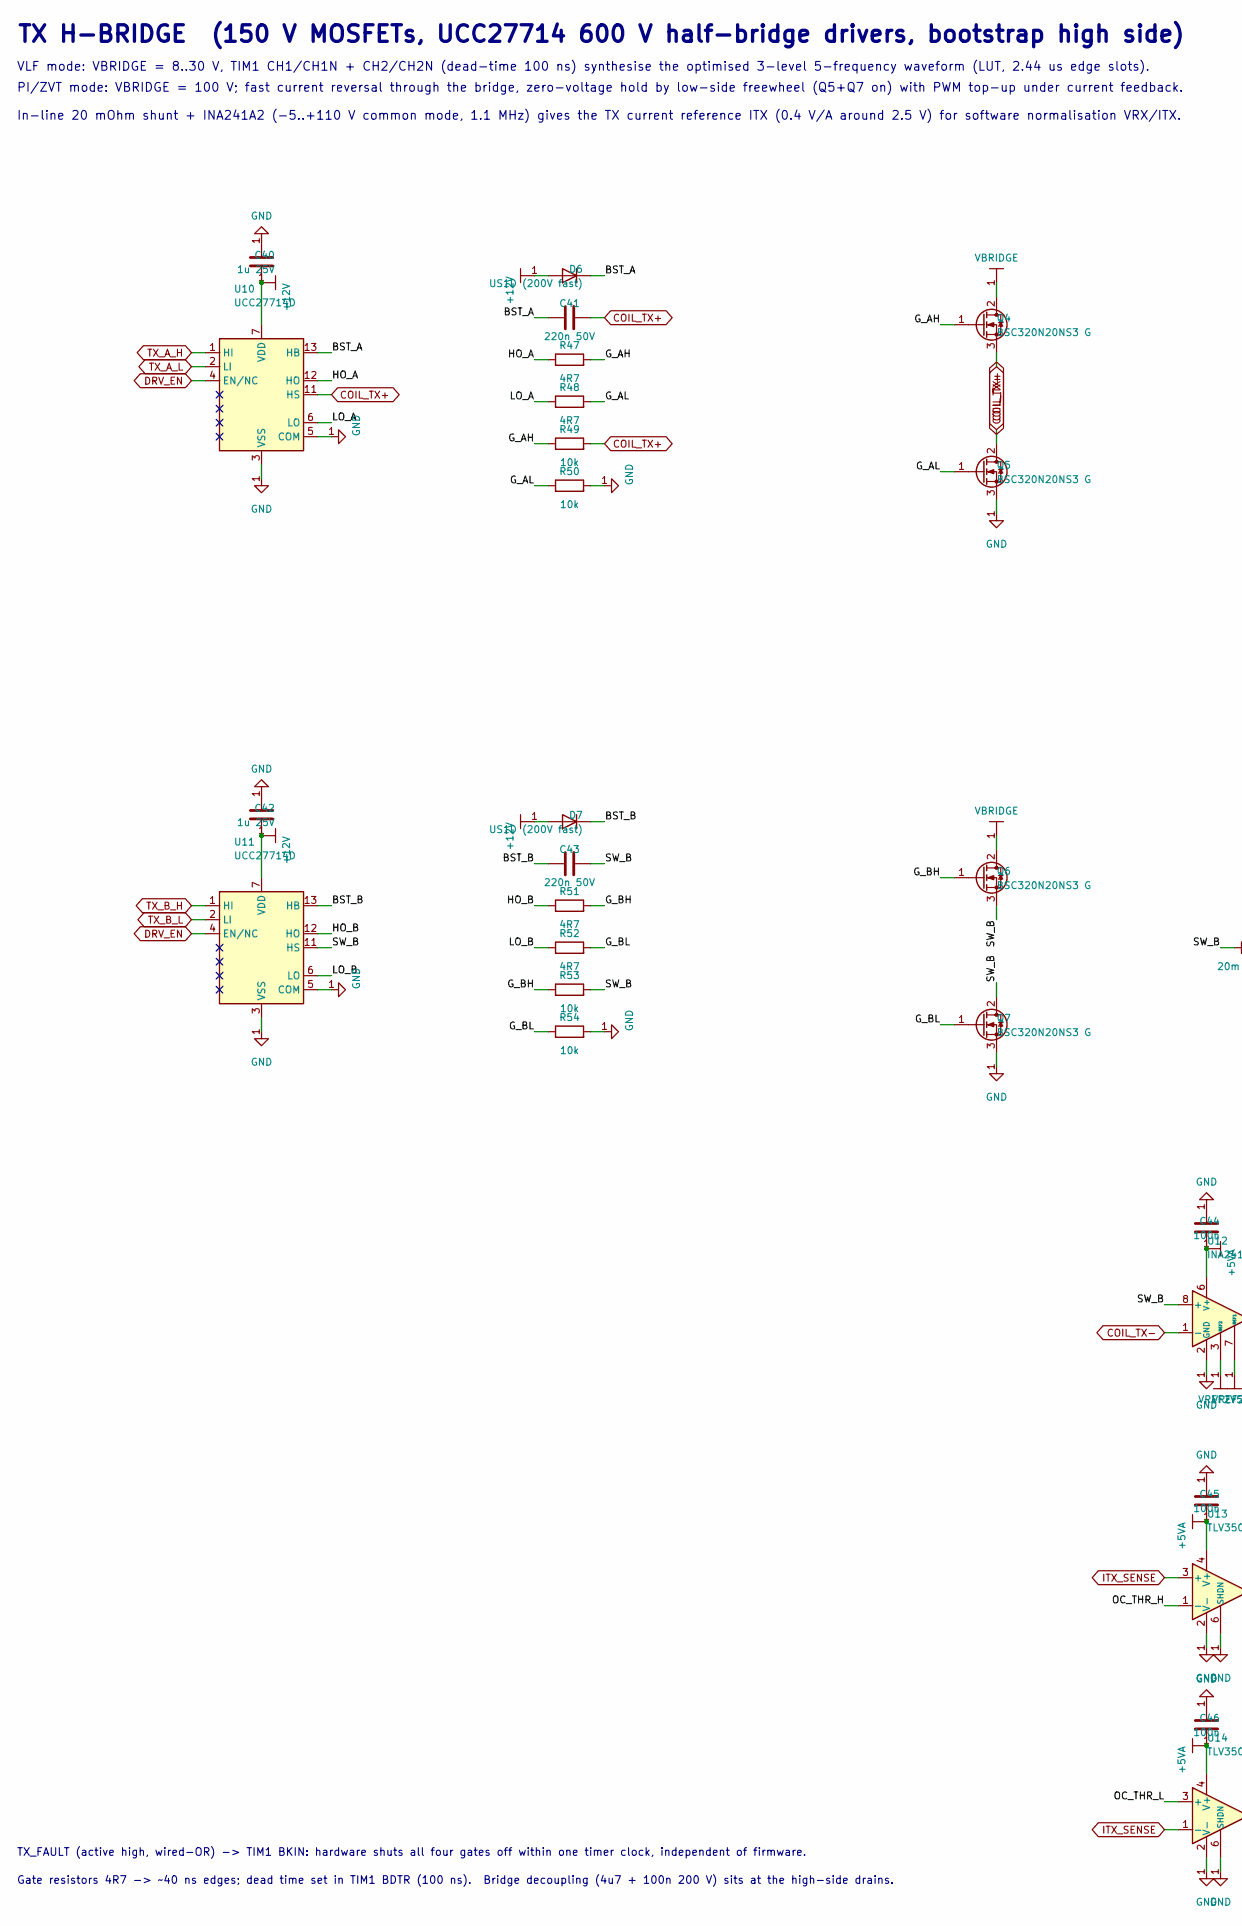
[picture p33: schematic tx_driver.kicad_sch, TX driver: 3-level H-bridge, current sense, over-current tr…, part in row 1, column 1]

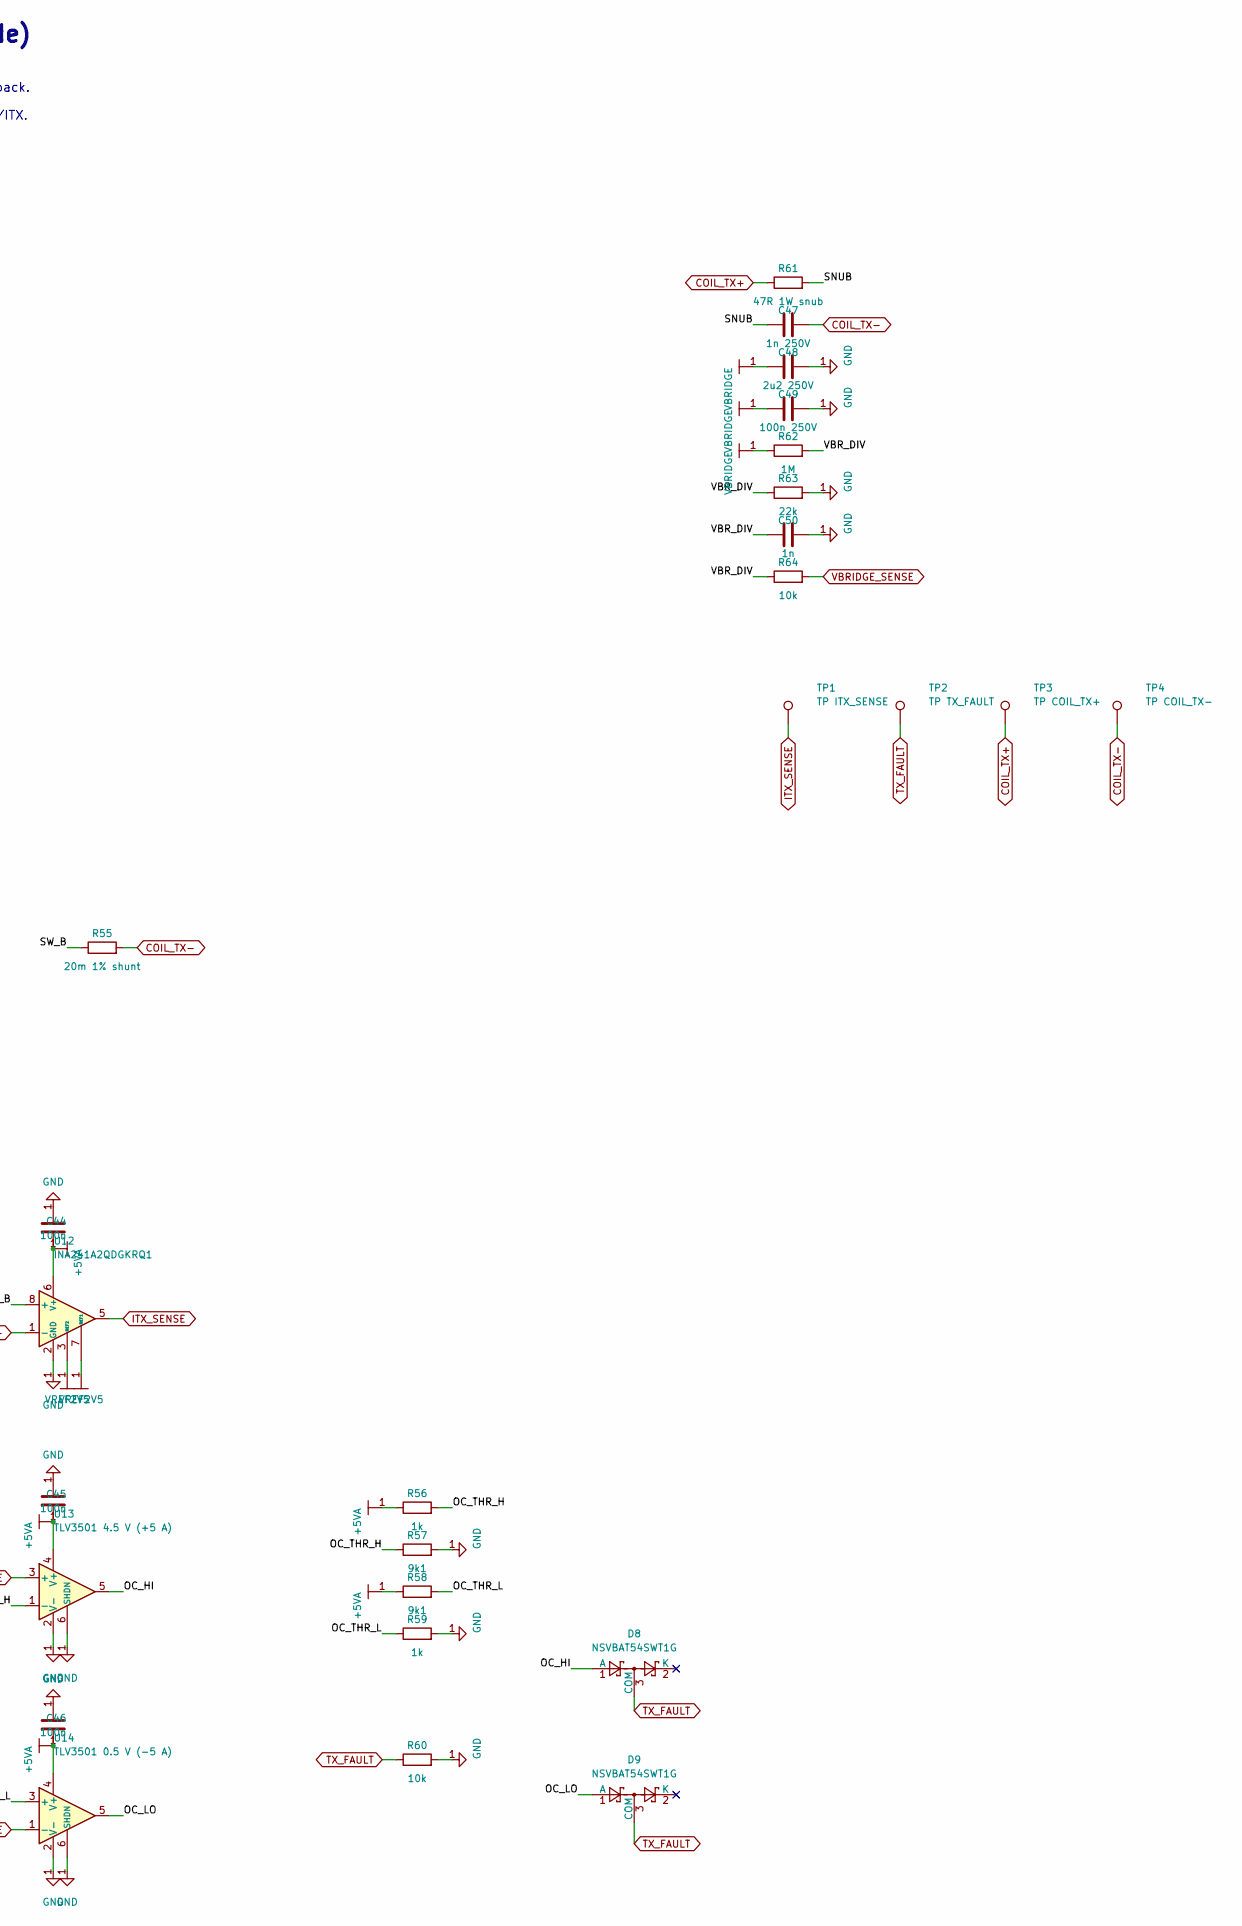
[picture p34: schematic tx_driver.kicad_sch, TX driver: 3-level H-bridge, current sense, over-current tr…, part in row 1, column 2]

Parts:
C40, C42: 1u 25V; C_0603_1608Metric
C41, C43: 220n 50V; C_0603_1608Metric
C44, C45, C46: 100n; C_0402_1005Metric
C47: 1n 250V; C_1206_3216Metric
C48: 2u2 250V; C_2220_5750Metric
C49: 100n 250V; C_1206_3216Metric
C50: 1n; C_0402_1005Metric
D6, D7: US1D (200V fast); D_SMA
D8, D9: NSVBAT54SWT1G; SOT-323_SC-70
Q4, Q5, Q6, Q7: BSC320N20NS3 G; Infineon_PG-TDSON-8_6.15x5.15mm
R47, R48, R51, R52: 4R7; R_0402_1005Metric
R49, R50, R53, R54, R60, R64: 10k; R_0402_1005Metric
R55: 20m 1% shunt; R_2512_6332Metric
R56, R59: 1k; R_0402_1005Metric
R57, R58: 9k1; R_0402_1005Metric
R61: 47R 1W snub; R_2512_6332Metric
R62: 1M; R_0402_1005Metric
R63: 22k; R_0402_1005Metric
TP1: TP ITX_SENSE; TestPoint_Pad_D1.5mm
TP2: TP TX_FAULT; TestPoint_Pad_D1.5mm
TP3: TP COIL_TX+; TestPoint_Pad_D1.5mm
TP4: TP COIL_TX-; TestPoint_Pad_D1.5mm
U10, U11: UCC27714D; SOIC-14_3.9x8.7mm_P1.27mm
U12: INA241A2QDGKRQ1; VSSOP-8_3x3mm_P0.65mm
U13: TLV3501 4.5 V (+5 A); SOT-23-6
U14: TLV3501 0.5 V (-5 A); SOT-23-6

Connections:
+5VA: C44.1, C45.1, C46.1, R56.1, R58.1, U12.6 (V+), U13.4 (V+), U14.4 (V+); also elsewhere on the board
+12V: C40.1, C42.1, D6.2 (A), D7.2 (A), U10.7 (VDD), U11.7 (VDD); also elsewhere on the board
/TX driver: 3-level H-bridge, current sense, over-current trip/BST_A: C41.1, D6.1 (K), U10.13 (HB)
/TX driver: 3-level H-bridge, current sense, over-current trip/BST_B: C43.1, D7.1 (K), U11.13 (HB)
/TX driver: 3-level H-bridge, current sense, over-current trip/G_AH: Q4.1 (G), R47.2, R49.1
/TX driver: 3-level H-bridge, current sense, over-current trip/G_AL: Q5.1 (G), R48.2, R50.1
/TX driver: 3-level H-bridge, current sense, over-current trip/G_BH: Q6.1 (G), R51.2, R53.1
/TX driver: 3-level H-bridge, current sense, over-current trip/G_BL: Q7.1 (G), R52.2, R54.1
/TX driver: 3-level H-bridge, current sense, over-current trip/HO_A: R47.1, U10.12 (HO)
/TX driver: 3-level H-bridge, current sense, over-current trip/HO_B: R51.1, U11.12 (HO)
/TX driver: 3-level H-bridge, current sense, over-current trip/LO_A: R48.1, U10.6 (LO)
/TX driver: 3-level H-bridge, current sense, over-current trip/LO_B: R52.1, U11.6 (LO)
/TX driver: 3-level H-bridge, current sense, over-current trip/OC_HI: D8.1 (A), U13.5
/TX driver: 3-level H-bridge, current sense, over-current trip/OC_LO: D9.1 (A), U14.5
/TX driver: 3-level H-bridge, current sense, over-current trip/OC_THR_H: R56.2, R57.1, U13.1 (-)
/TX driver: 3-level H-bridge, current sense, over-current trip/OC_THR_L: R58.2, R59.1, U14.3 (+)
/TX driver: 3-level H-bridge, current sense, over-current trip/SNUB: C47.1, R61.2
/TX driver: 3-level H-bridge, current sense, over-current trip/SW_B: C43.2, Q6.3 (S), Q7.2 (D), R53.2, R55.1, U11.11 (HS), U12.8 (+)
/TX driver: 3-level H-bridge, current sense, over-current trip/VBR_DIV: C50.1, R62.2, R63.1, R64.1
COIL_TX+: C41.2, Q4.3 (S), Q5.2 (D), R49.2, R61.1, TP3.1 (1_1), U10.11 (HS); also elsewhere on the board
COIL_TX-: C47.2, R55.2, TP4.1 (1_1), U12.1 (-); also elsewhere on the board
DRV_EN: U10.4 (EN/NC), U11.4 (EN/NC); also elsewhere on the board
ITX_SENSE: TP1.1 (1_1), U12.5, U13.3 (+), U14.1 (-); also elsewhere on the board
TX_A_H: U10.1 (HI); also elsewhere on the board
TX_A_L: U10.2 (LI); also elsewhere on the board
TX_B_H: U11.1 (HI); also elsewhere on the board
TX_B_L: U11.2 (LI); also elsewhere on the board
TX_FAULT: D8.3 (COM), D9.3 (COM), R60.1, TP2.1 (1_1); also elsewhere on the board
VBRIDGE: C48.1, C49.1, Q4.2 (D), Q6.2 (D), R62.1; also elsewhere on the board
VBRIDGE_SENSE: R64.2; also elsewhere on the board
VREF2V5: U12.3 (REF2), U12.7 (REF1); also elsewhere on the board

Notes on the sheet:
TX_FAULT (active high, wired-OR) -> TIM1 BKIN: hardware shuts all four gates off within one timer clock, independent of firmware.
In-line 20 mOhm shunt + INA241A2 (-5..+110 V common mode, 1.1 MHz) gives the TX current reference ITX (0.4 V/A around 2.5 V) for software normalisation VRX/ITX.
Gate resistors 4R7 -> ~40 ns edges; dead time set in TIM1 BDTR (100 ns). Bridge decoupling (4u7 + 100n 200 V) sits at the high-side drains.
VLF mode: VBRIDGE = 8..30 V, TIM1 CH1/CH1N + CH2/CH2N (dead-time 100 ns) synthesise the optimised 3-level 5-frequency waveform (LUT, 2.44 us edge slots).
TX H-BRIDGE (150 V MOSFETs, UCC27714 600 V half-bridge drivers, bootstrap high side)
PI/ZVT mode: VBRIDGE = 100 V; fast current reversal through the bridge, zero-voltage hold by low-side freewheel (Q5+Q7 on) with PWM top-up under current feedback.

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
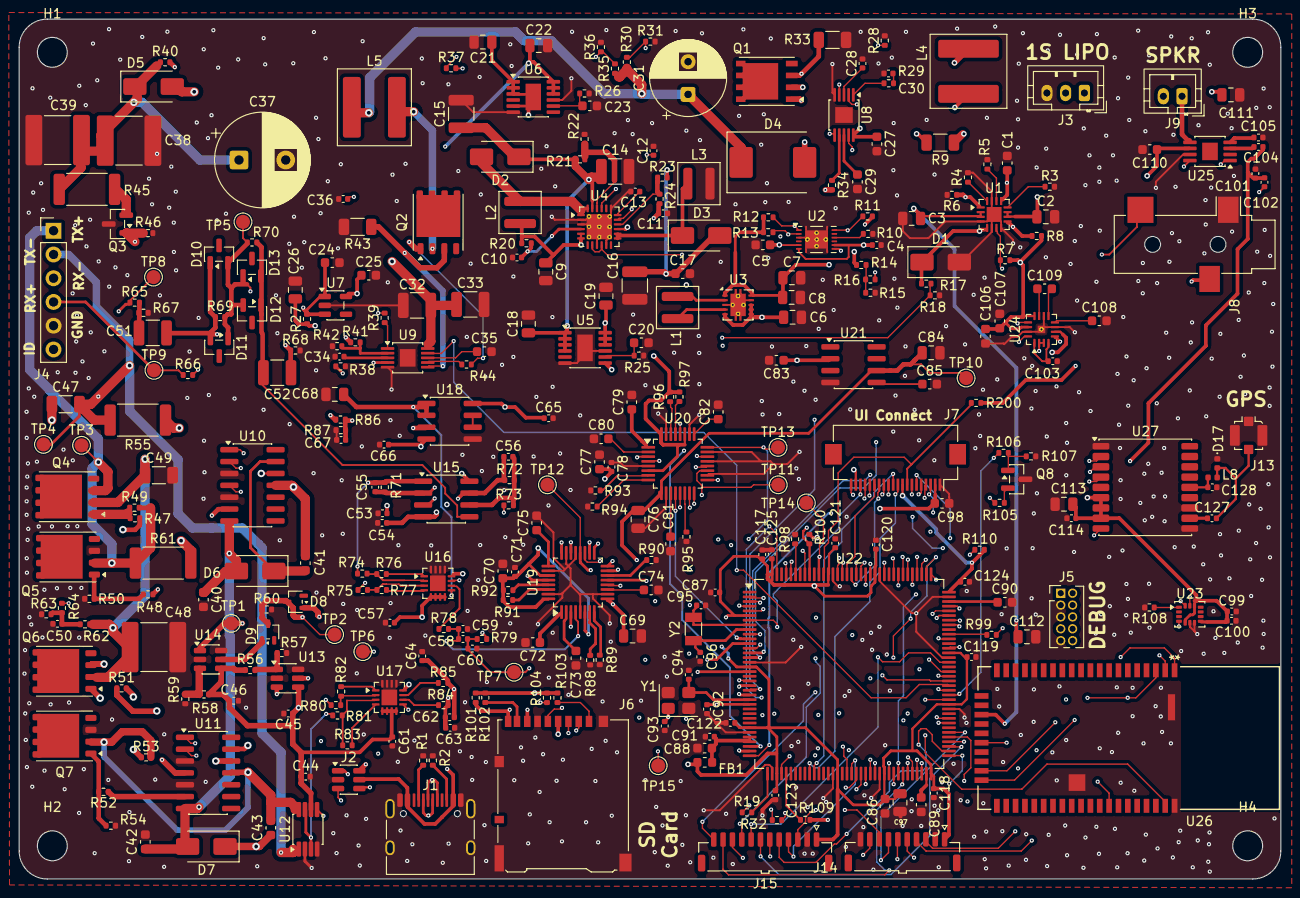
[picture p35: board mdx1.kicad_pcb from above]

Board: 4 copper layers, 135.0 x 92.0 mm, 325 parts (0 on the bottom side), 250 nets.

Other parts of the board:
H1, H2, H3, H4: MountingHole_3.2mm_M3
