pingpongshow/MDX-1/hardware/mdx1/mdx1_ui.kicad_pcb

## KiCad design hardware/mdx1/mdx1_ui.kicad_pcb (2026-09-09)

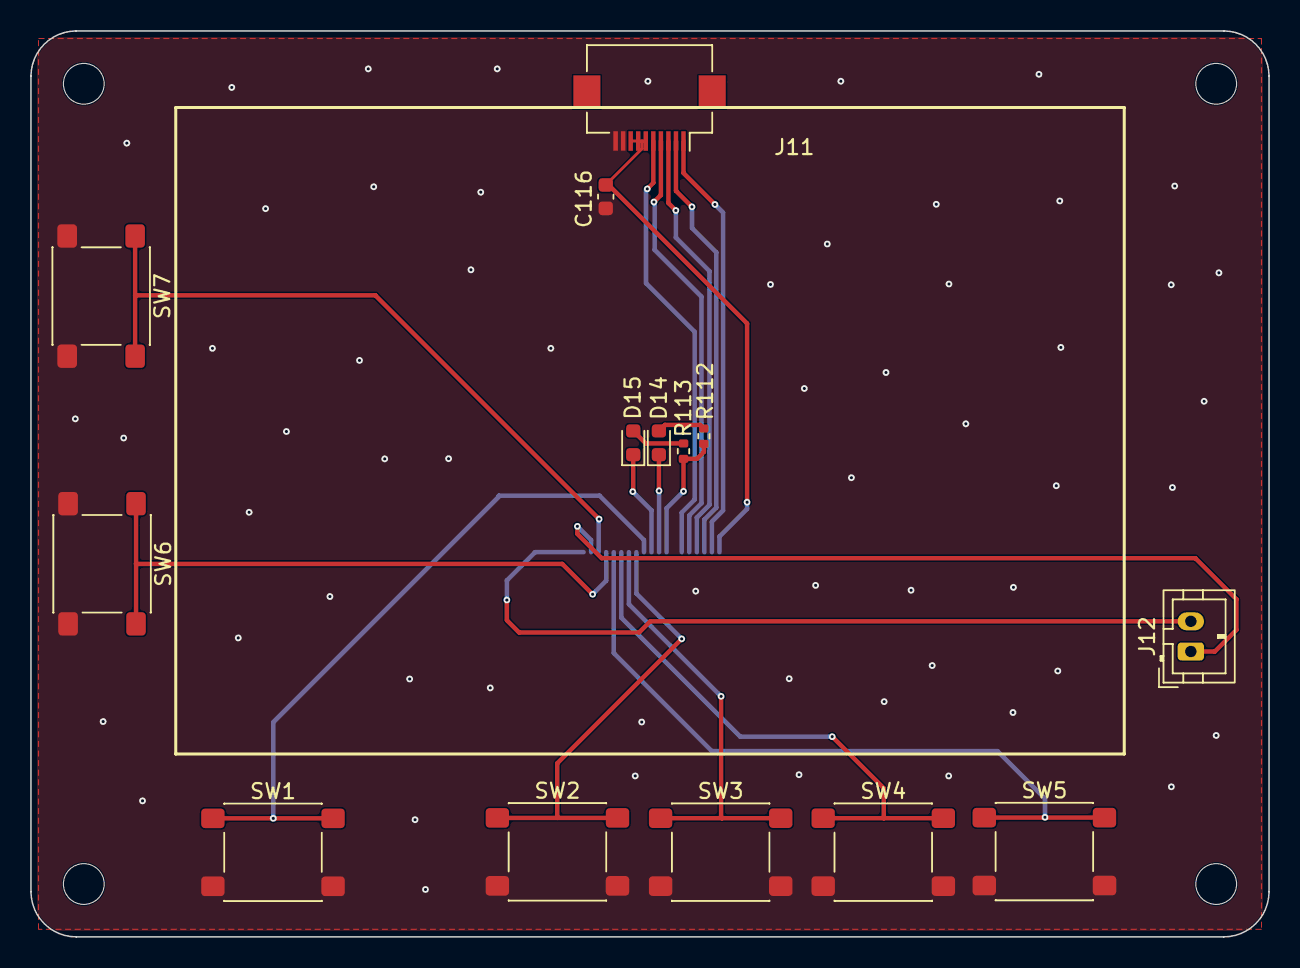
[picture p36: board mdx1_ui.kicad_pcb from above]

Board: 2 copper layers, 82.0 x 60.0 mm, 19 parts (1 on the bottom side), 21 nets.

Parts:
C116: 1u; C_0603_1608Metric
D14: LED green; LED_0603_1608Metric
D15: LED amber; LED_0603_1608Metric
H1, H2, H3, H4: MountingHole_2.7mm_M2.5
J10: UI link FFC 20p 0.5mm; Hirose_FH12-20S-0.5SH_1x20-1MP_P0.50mm_Horizontal
J11: LCD FPC 10p 0.5mm; Hirose_FH12-10S-0.5SH_1x10-1MP_P0.50mm_Horizontal
J12: Front-light LED; JST_PH_B2B-PH-K_1x02_P2.00mm_Vertical
R112, R113: 1k; R_0402_1005Metric
SW1: MENU; SW_SPST_PTS645Sx43SMTR92
SW2: UP; SW_SPST_PTS645Sx43SMTR92
SW3: DOWN; SW_SPST_PTS645Sx43SMTR92
SW4: LEFT; SW_SPST_PTS645Sx43SMTR92
SW5: RIGHT; SW_SPST_PTS645Sx43SMTR92
SW6: PINPOINT; SW_SPST_PTS645Sx43SMTR92
SW7: POWER; SW_SPST_PTS645Sx43SMTR92

Connections:
+3V3: J10.9, R112.1, R113.1
+5V_LCD: C116.1, J10.2, J11.6, J11.7, J11.8
/UI board (separate PCB): memory LCD, 6-key pad + pinpoint + power, LEDs, front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: D14.2, R112.2
/UI board (separate PCB): memory LCD, 6-key pad + pinpoint + power, LEDs, front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: D15.2, R113.2
DISP_CS: J10.5, J11.3
DISP_EN: J10.7, J11.5
DISP_EXTCOM: J10.6, J11.4
DISP_MOSI: J10.4, J11.2
DISP_SCK: J10.3, J11.1
FL_K: J10.20, J12.2
GND: C116.2, J10.1, J10.8, J11.9, J11.10, SW1.2, SW2.2, SW3.2, SW4.2, SW5.2, SW6.2, SW7.2
KEY_DOWN: J10.14, SW3.1
KEY_LEFT: J10.15, SW4.1
KEY_MENU: J10.12, SW1.1
KEY_PP: J10.17, SW6.1
KEY_PWR: J10.18, SW7.1
KEY_RIGHT: J10.16, SW5.1
KEY_UP: J10.13, SW2.1
LED_CHG: D15.1, J10.11
LED_STAT: D14.1, J10.10
VSYS: J10.19, J12.1
