pingpongshow/MDX-1/(commit log)

2026-09-09 Initial commit — MDX-1 multi-frequency + pulse-induction metal detector
    Open hardware, firmware and companion-app design:
    - KiCad 4-layer main board and 2-layer UI board (hand-placed and routed)
    - Search-coil design and build manual
    - Portable-C firmware with host simulator and test bench; STM32H743 target layer
    - iOS (SwiftUI) and Android (Compose) companion apps
    - Fabrication packages (Gerbers, drill, assembly BOM, pick-and-place) for both boards
    Experimental, unbuilt and untested. Transmit stage switches up to 100 V.
    [LS027B7DH01_LCD_outline.dxf, MDX-1_interconnect_BOM.csv, MDX-1_main_BOM.csv, MDX-1_main_outline.dxf, MDX-1_ui_BOM.csv, MDX-1_ui_layout.dxf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]
2026-09-16 fab: verify + reorganize BOM, regenerate fab package, add board layer images
    BOM verification & cleanup
    - Reconciled bom_data.json against the placed board: all 317 placed parts map
    to a priced entry; rebuilt References and Qty from the board, dropped 3 stale
    rows and the 15 test-point (non-part) rows.
    - fab_jlc.py now groups the assembly BOM by manufacturer part number, so the
    same component under different value annotations collapses onto one line
    (main 137->118 lines, UI 14->8); DNP option pads and no-MPN parts excluded.
    - Fab outputs now written into fab/Gerbers, fab/BOM and fab/PNP.
    - Fixed the stale coil-connector row in the interconnect BOM (J4 is a 1x06
    2.54 mm header, not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
    [MDX-1_interconnect_BOM.csv, MDX-1_main_BOM.csv, MDX-1_ui_BOM.csv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]
2026-09-16 bom: reprice from actual DigiKey/Mouser/Coilcraft carts
    - Quantity-1 unit prices in bom_data.json now come from the real shopping
    carts (2026-09-08): board-component qty-1 total $209.20 -> $292.11. The two
    ADS127L01 ($18.97 ea) and the MCU drive most of the increase; the earlier
    catalogue figures were optimistic.
    - Aligned the 4.7 uF 0603 to the part actually in the cart (Taiyo Yuden
    LMK107BJ475KA-T, $0.088) instead of the Murata catalogue MPN.
    - Six parts absent from the carts (BQ27441 gauge, 16.384 MHz crystal, coil
    header, JST B2B-PH-K-S) keep a catalogue estimate; qty-100 column remains a
    volume estimate, not a quote.
    - Regenerated the BOM review (board-only assembled proto n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
    [MDX-1_main_BOM.csv]
2026-09-24 Re-source out-of-stock parts; rework D8/9 footprint and GNSS antenna front end
    Parts re-sourced to in-stock equivalents (BOM + board + firmware kept in sync):
    - U4 TPS65131RGET, U12 INA241A2QDGKRQ1, U23 LSM6DSO32TR (same footprints)
    - Q1 SiR680ADP-T1-UE3 (80 V, same PowerPAK SO-8; higher Qg - verify gate drive)
    - U2 BQ27441DRZT-G1A (drop-in, R9 sense retained)
    - D8/9 NSVBAT54SWT1G: SOT-323/SC-70 dual-series wired as a single diode
    (anode=pin1, cathode=pin3, pin2 NC); footprint changed on the board
    - C32/C33/C38-48 re-sourced (KEMET/Murata/TDK), same footprints
    GNSS antenna: chip antenna -> external active antenna via u.FL
    - Removed U28 (chip antenna), C115 (match pad), R111 (0R RF seri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
    [MDX-1_DigiKey_BOM.csv, MDX-1_main_BOM.csv, mcu.kicad_sch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]
2026-09-26 Add LL-audio + expansion-header support (firmware, schematic nets, mount holes)
    Firmware (host bench 96/0):
    - Optional low-latency audio module (nRF52840 daughterboard on J14): settings
    item "Low-latency audio" + "Pair LL headphones" (auto-exposed to UI and app via
    the item table), settings_t.ll_audio, HAL hal_ll_audio_*(), USART3 (PD8/PD9) +
    PG0/PG1 on the target; BM83 kept for BLE/app + standard-BT audio. Sim stubs.
    - Expansion header: I2C4 (PF14/PF15), SPI2 (PB13/14/15, CS PG8), UART5 (PB6/PB12),
    GPIO PE13/PA15 initialised; portable hal_exp_*() API + sim stubs.
    Schematic: J14 LL-audio header and expansion-header nets wired to the MCU; cleared
    the no-connect flags on the newly use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
    [mcu.kicad_sch, mdx1.kicad_pcb, ui_audio_rf.kicad_sch]
